Er-Chiacchiera/Soccer-2018-19/Meccanica/Adafruit BNO055/Renderings/Render.png

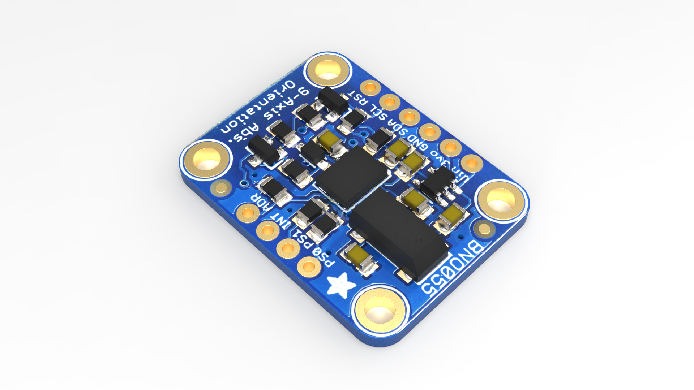
Meccanica/Adafruit BNO055/Renderings/Render.png
