Er-Chiacchiera/Soccer-2018-19/Meccanica/Adafruit BNO055/bottom.jpg

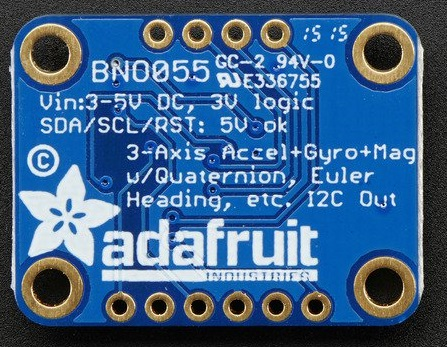
Meccanica/Adafruit BNO055/bottom.jpg
