Er-Chiacchiera/Soccer-2018-19/README.md

# Soccer-2018-19
Soccer Robot of Pacinotti-Archimede 2018/2019
