Er-Chiacchiera/Soccer-2018-19/Elettronica/Immagini/bmp/nero prova.bmp

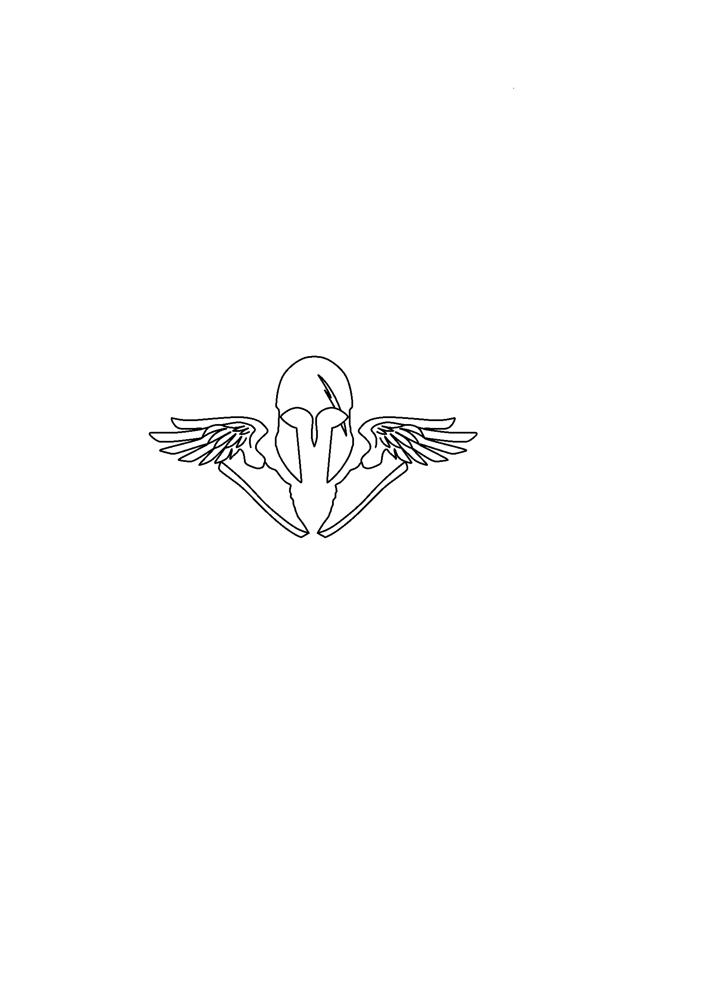
Elettronica/Immagini/bmp/nero prova.bmp
