Er-Chiacchiera/Soccer-2018-19/Meccanica/Adafruit BNO055/Renderings/Render2.png

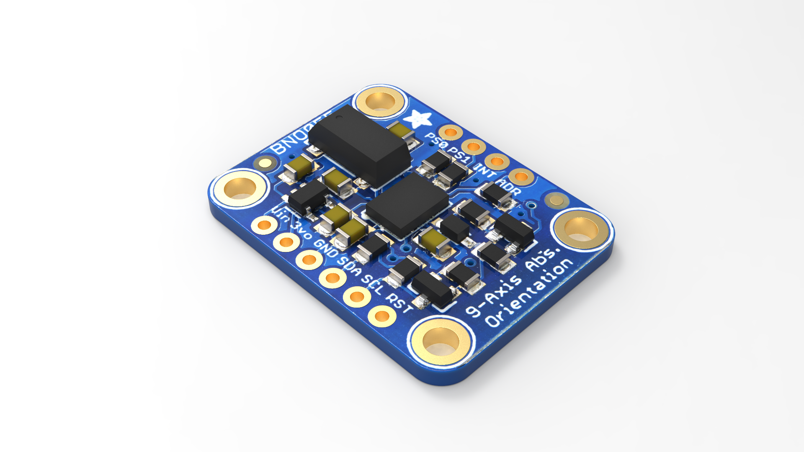
Meccanica/Adafruit BNO055/Renderings/Render2.png
