Er-Chiacchiera/Soccer-2018-19/Meccanica/Adafruit BNO055/top.jpg

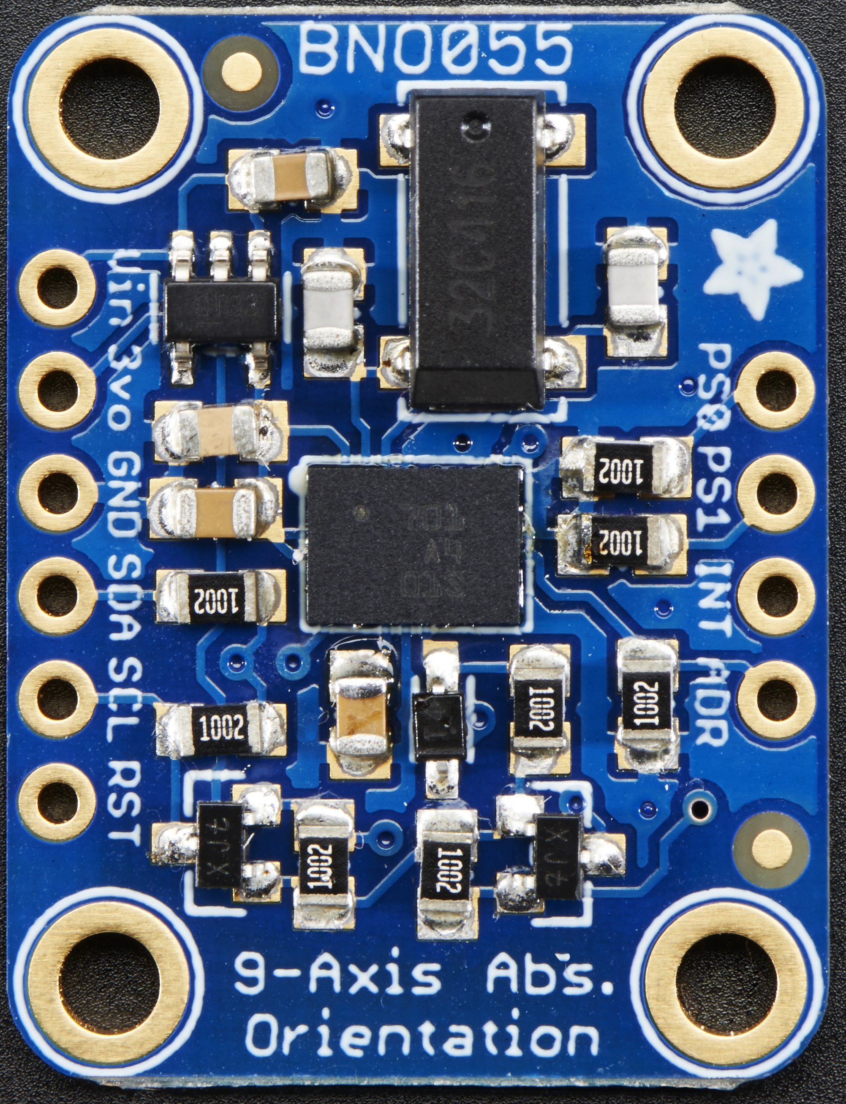
Meccanica/Adafruit BNO055/top.jpg
