Er-Chiacchiera/Soccer-2018-19/Elettronica/DXF/sensori_linea.dxf

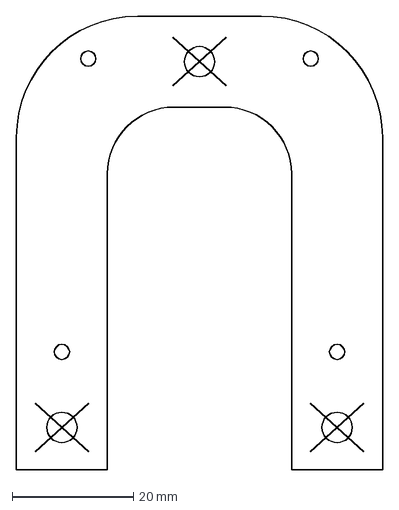
[picture p6: CAD file, 2019-03-06]
Elettronica/DXF/sensori_linea.dxf
60.3 x 74.8 mm
