Er-Chiacchiera/Soccer-2018-19/Elettronica/Vecchie/soccer-2015-pcb/Sensore Linea Rev 1/Sensore Linea Rev 1/sensore_linea.dxf

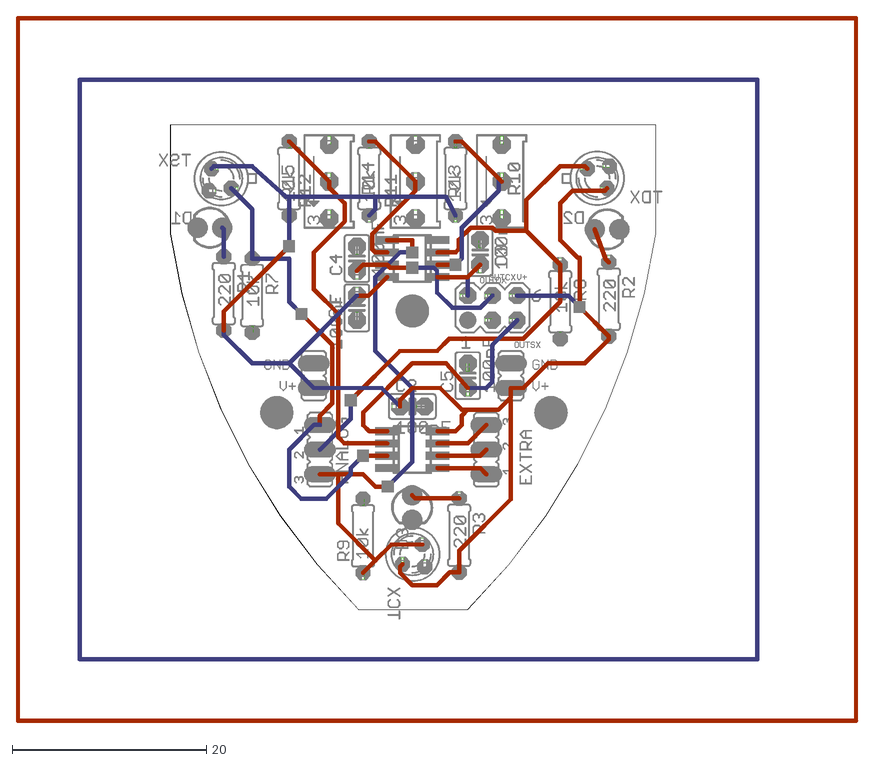
[picture p7: CAD file, 2019-03-06]
Elettronica/Vecchie/soccer-2015-pcb/Sensore Linea Rev 1/Sensore Linea Rev 1/sensore_linea.dxf
86.8 x 72.8
