Er-Chiacchiera/Soccer-2018-19/Meccanica/Adafruit BNO055/Adafruit_BNO055.SLDPRT

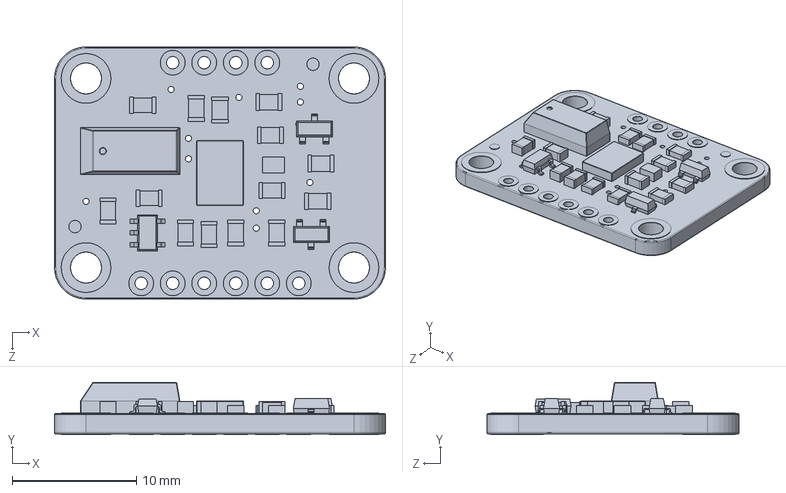
[picture p8: CAD file, 2019-03-06]
Meccanica/Adafruit BNO055/Adafruit_BNO055.SLDPRT
26.7 x 4.20 x 20.3 mm
