Er-Chiacchiera/Soccer-2018-19/Meccanica/Base_Sotto.dxf

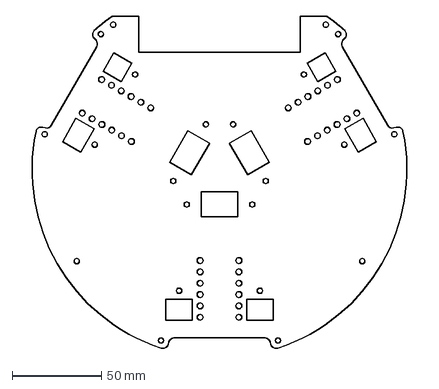
[picture p9: CAD file, 2019-03-11]
Meccanica/Base_Sotto.dxf
227.6 x 186.1 mm
