Er-Chiacchiera/Soccer-2018-19/Elettronica/DXF/PCB .dxf

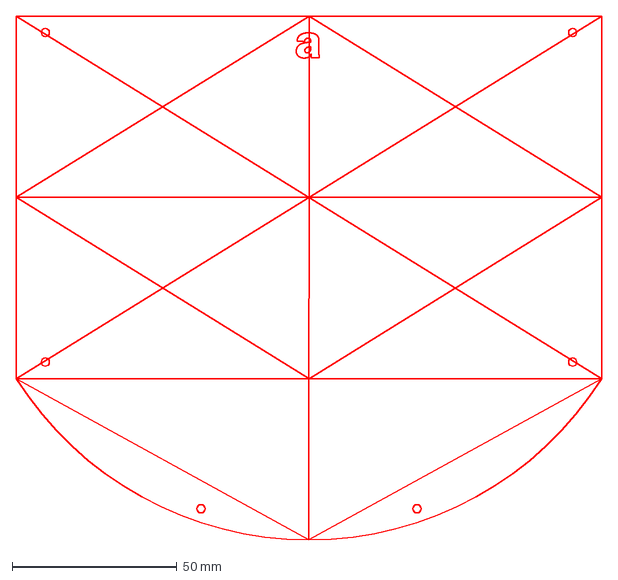
[picture p10: CAD file, 2019-03-06]
Elettronica/DXF/PCB .dxf
177.6 x 159.0 mm
