Er-Chiacchiera/Soccer-2018-19/Meccanica/Base_Sopra.dxf

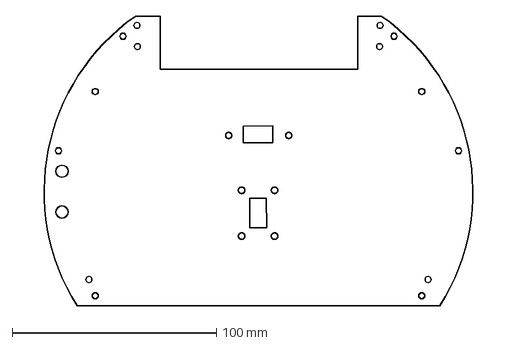
[picture p11: CAD file, 2019-03-11]
Meccanica/Base_Sopra.dxf
237.4 x 142.0 mm
