Er-Chiacchiera/Soccer-2018-19/Elettronica/Vecchie/soccer-2015-pcb/Sotto/cappucci anteriori.stl

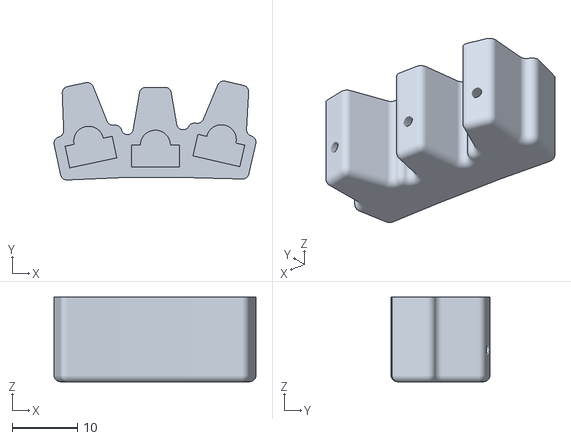
[picture p12: CAD file, 2019-03-06]
Elettronica/Vecchie/soccer-2015-pcb/Sotto/cappucci anteriori.stl
31.1 x 15.2 x 13.0
