Er-Chiacchiera/Soccer-2018-19/Meccanica/Rullo_Conico.stl

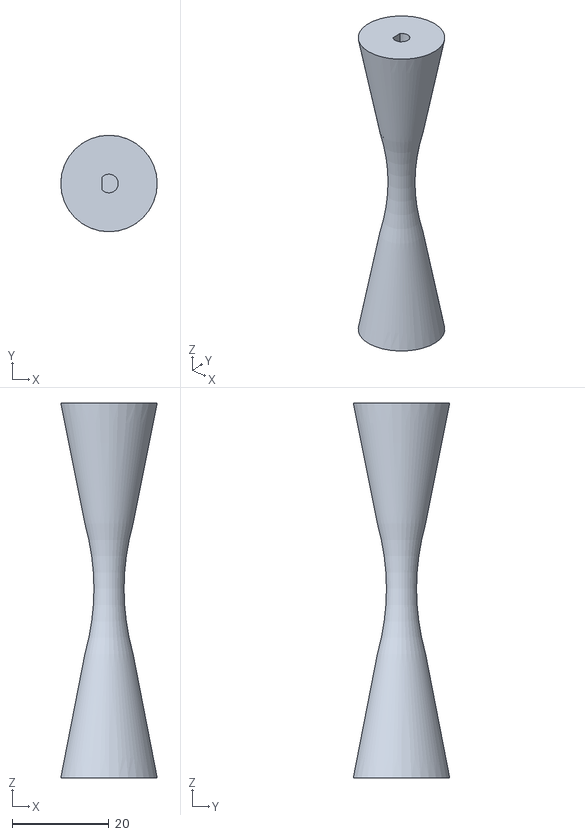
[picture p13: CAD file, 2019-03-06]
Meccanica/Rullo_Conico.stl
20.0 x 20.0 x 77.7
