Er-Chiacchiera/Soccer-2018-19/Meccanica/Rullo_Cilindrico.stl

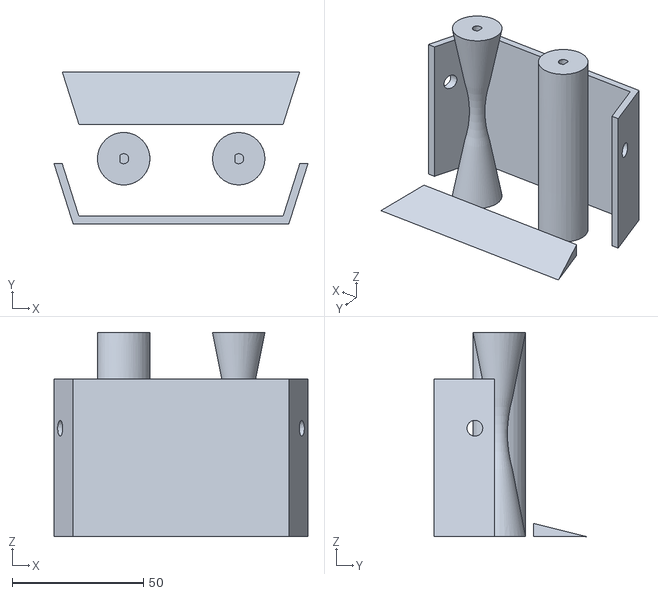
[picture p14: CAD file, 2019-03-06]
Meccanica/Rullo_Cilindrico.stl
96.7 x 57.9 x 77.7
