Er-Chiacchiera/Soccer-2018-19/Meccanica/Rampa_pt3.stl

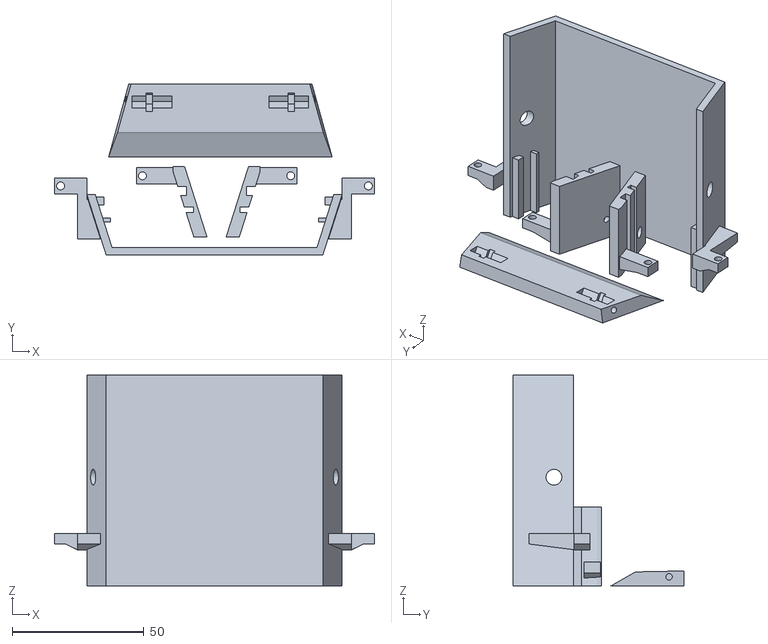
[picture p15: CAD file, 2019-03-06]
Meccanica/Rampa_pt3.stl
121.3 x 65.0 x 80.0
