Er-Chiacchiera/Soccer-2018-19/Meccanica/Rampa_pt2.stl

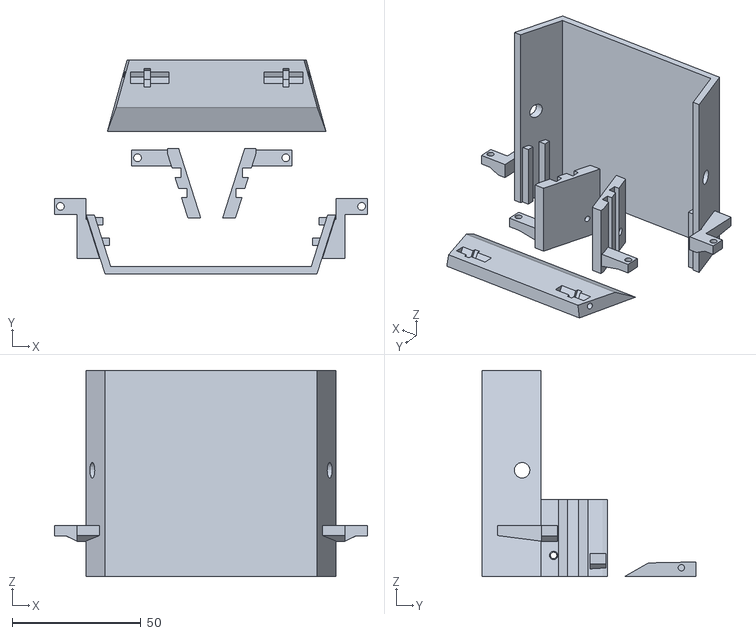
[picture p16: CAD file, 2019-03-06]
Meccanica/Rampa_pt2.stl
121.3 x 83.1 x 80.0
