Er-Chiacchiera/Soccer-2018-19/Meccanica/Rampa_pt1.stl

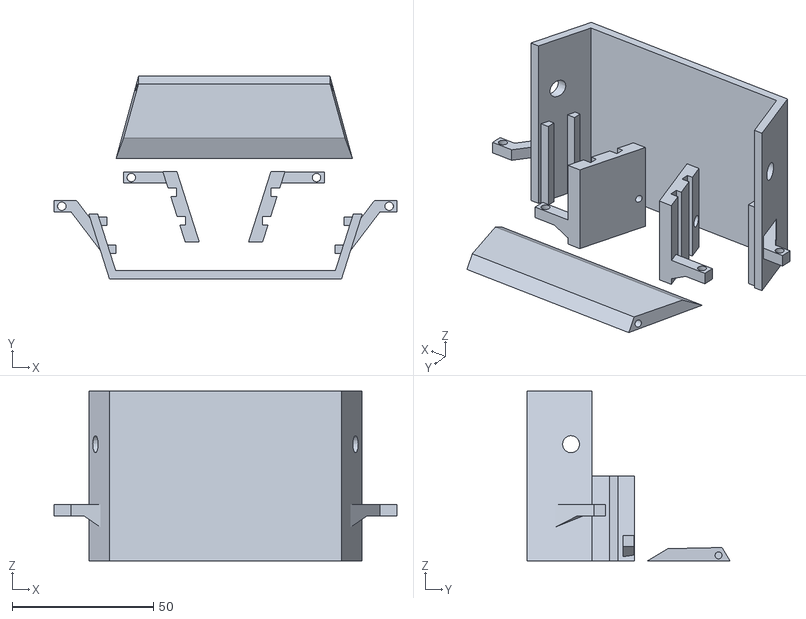
[picture p17: CAD file, 2019-03-06]
Meccanica/Rampa_pt1.stl
121.4 x 71.9 x 60.0
