Er-Chiacchiera/Soccer-2018-19/Meccanica/PCB .dxf

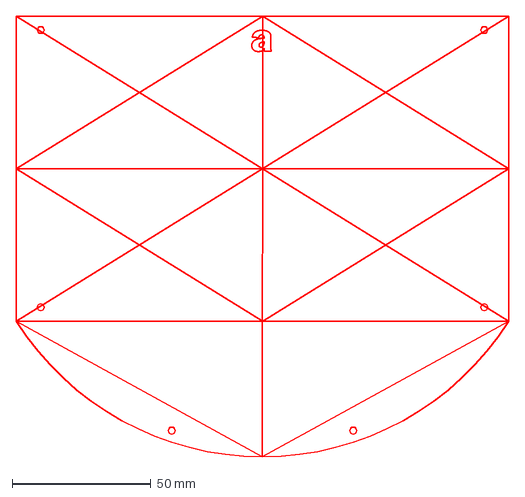
[picture p18: CAD file, 2019-03-06]
Meccanica/PCB .dxf
177.6 x 159.0 mm
