Er-Chiacchiera/Soccer-2018-19/Meccanica/Stampa_Ruote_prova.stl

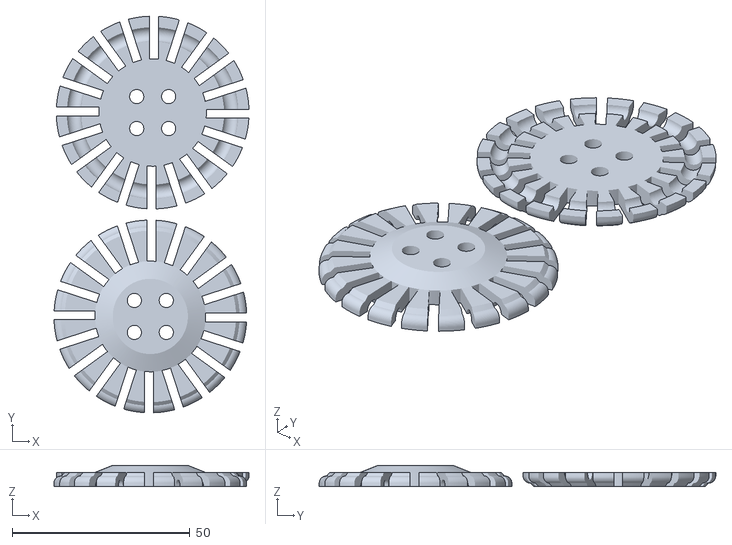
[picture p19: CAD file, 2019-03-06]
Meccanica/Stampa_Ruote_prova.stl
54.8 x 111.5 x 6.00
