Er-Chiacchiera/Soccer-2018-19/(list of files, cad)

Other CAD files:
Elettronica/Vecchie/soccer-2015-pcb/Sotto/Calciatore Rev.2 DOWN.dwg
Elettronica/Vecchie/soccer-2015-pcb/Sotto/cappuccio.dwg
Meccanica/Adafruit BNO055/Adafruit_BNO055_AP203.STEP
Meccanica/Adafruit BNO055/Adafruit_BNO055_AP214.STEP
Elettronica/Vecchie/soccer-2015-pcb/Sotto/cappucci anteriori.dwg
Meccanica/Rampa_pt1.3dm
Meccanica/Rampa_pt2.3dm
Meccanica/Rampa_pt3 .3dm
Meccanica/bussola.3dm
Meccanica/logo soccer.3dm
