Er-Chiacchiera/Soccer-2018-19/Elettronica/PCB/PCB.brd

## EAGLE design Elettronica/PCB/PCB.brd (2020-01-30)

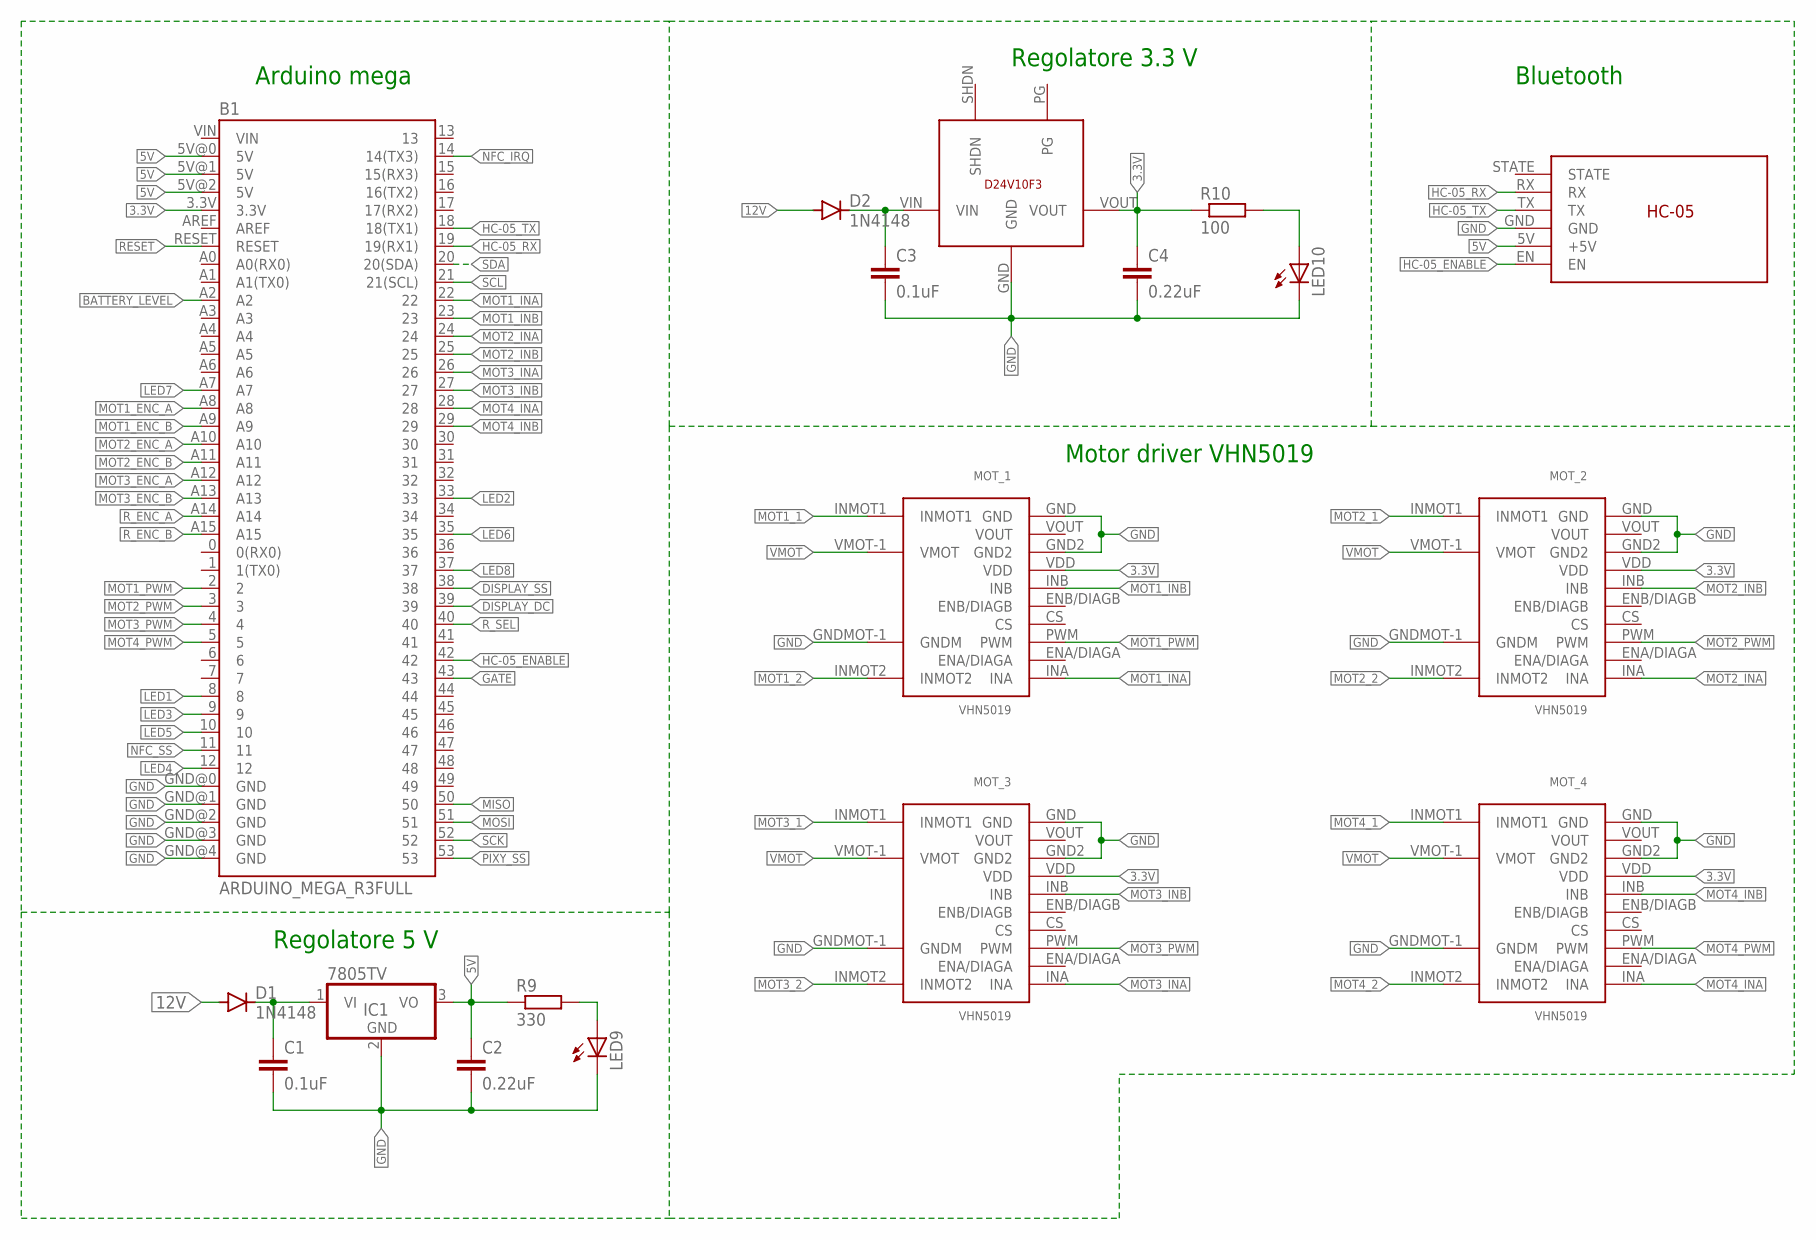
[picture p20: schematic PCB.sch, sheet 1]

Parts:
B1: ARDUINO_MEGA_R3FULL; ARDUINO_MEGA
C1, C3: 0.1uF; CAP-PTH-SMALL-KIT
C2, C4: 0.22uF; CAP-PTH-SMALL-KIT
D1, D2: 1N4148; DO41-10
IC1: 7805TV; TO220V
LED9, LED10: LED1206; LED-1206
MOT_1, MOT_2, MOT_3, MOT_4: VHN5019; MOTOR-SHIELD
R9: 330; R1206
R10: 100; R1206
U$1: STEPDOWN_D24V10F3
U$9: HC-05

Connections:
3.3V: B1.3.3V, C4.1, MOT_1.VDD, MOT_2.VDD, MOT_3.VDD, MOT_4.VDD, R10.1, U$1.VOUT; also elsewhere on the board
5V: B1.5V@0 (5V), B1.5V@1 (5V), B1.5V@2 (5V), C2.1, IC1.3 (VO), R9.1, U$9.5V (+5V); also elsewhere on the board
12V: D1.A, D2.A; also elsewhere on the board
BATTERY_LEVEL: B1.A2; also elsewhere on the board
DISPLAY_DC: B1.39; also elsewhere on the board
DISPLAY_SS: B1.38; also elsewhere on the board
GATE: B1.43; also elsewhere on the board
GND: B1.GND@0 (GND), B1.GND@1 (GND), B1.GND@2 (GND), B1.GND@3 (GND), B1.GND@4 (GND), C1.2, C2.2, C3.2, C4.2, IC1.2 (GND), LED9.C, LED10.C, MOT_1.GND, MOT_1.GND2, MOT_1.GNDMOT-1 (GNDM), MOT_2.GND, MOT_2.GND2, MOT_2.GNDMOT-1 (GNDM), MOT_3.GND, MOT_3.GND2, MOT_3.GNDMOT-1 (GNDM), MOT_4.GND, MOT_4.GND2, MOT_4.GNDMOT-1 (GNDM), U$1.GND, U$9.GND; also elsewhere on the board
HC-05_ENABLE: B1.42, U$9.EN
HC-05_RX: B1.19 (19(RX1)), U$9.RX
HC-05_TX: B1.18 (18(TX1)), U$9.TX
LED1: B1.8; also elsewhere on the board
LED2: B1.33; also elsewhere on the board
LED3: B1.9; also elsewhere on the board
LED4: B1.12; also elsewhere on the board
LED5: B1.10; also elsewhere on the board
LED6: B1.35; also elsewhere on the board
LED7: B1.A7; also elsewhere on the board
LED8: B1.37; also elsewhere on the board
MISO: B1.50; also elsewhere on the board
MOSI: B1.51; also elsewhere on the board
MOT1_1: MOT_1.INMOT1; also elsewhere on the board
MOT1_2: MOT_1.INMOT2; also elsewhere on the board
MOT1_ENC_A: B1.A8; also elsewhere on the board
MOT1_ENC_B: B1.A9; also elsewhere on the board
MOT1_INA: B1.22, MOT_1.INA
MOT1_INB: B1.23, MOT_1.INB
MOT1_PWM: B1.2, MOT_1.PWM
MOT2_1: MOT_2.INMOT1; also elsewhere on the board
MOT2_2: MOT_2.INMOT2; also elsewhere on the board
MOT2_ENC_A: B1.A10; also elsewhere on the board
MOT2_ENC_B: B1.A11; also elsewhere on the board
MOT2_INA: B1.24, MOT_2.INA
MOT2_INB: B1.25, MOT_2.INB
MOT2_PWM: B1.3, MOT_2.PWM
MOT3_1: MOT_3.INMOT1; also elsewhere on the board
MOT3_2: MOT_3.INMOT2; also elsewhere on the board
MOT3_ENC_A: B1.A12; also elsewhere on the board
MOT3_ENC_B: B1.A13; also elsewhere on the board
MOT3_INA: B1.26, MOT_3.INA
MOT3_INB: B1.27, MOT_3.INB
MOT3_PWM: B1.4, MOT_3.PWM
MOT4_1: MOT_4.INMOT1
MOT4_2: MOT_4.INMOT2
MOT4_INA: B1.28, MOT_4.INA
MOT4_INB: B1.29, MOT_4.INB
MOT4_PWM: B1.5, MOT_4.PWM
unnamed: LED9.A, R9.2
unnamed: C3.1, D2.C, U$1.VIN
unnamed: LED10.A, R10.2
unnamed: C1.1, D1.C, IC1.1 (VI)
NFC_IRQ: B1.14 (14(TX3)); also elsewhere on the board
NFC_SS: B1.11; also elsewhere on the board
PIXY_SS: B1.53; also elsewhere on the board
RESET: B1.RESET; also elsewhere on the board
R_ENC_A: B1.A14; also elsewhere on the board
R_ENC_B: B1.A15; also elsewhere on the board
R_SEL: B1.40; also elsewhere on the board
SCK: B1.52; also elsewhere on the board
SCL: B1.21 (21(SCL)); also elsewhere on the board
SDA: B1.20 (20(SDA)); also elsewhere on the board
VMOT: MOT_1.VMOT-1 (VMOT), MOT_2.VMOT-1 (VMOT), MOT_3.VMOT-1 (VMOT), MOT_4.VMOT-1 (VMOT); also elsewhere on the board

Notes on the sheet:
Arduino mega
Regolatore 5 V
Motor driver VHN5019
Bluetooth
Regolatore 3.3 V

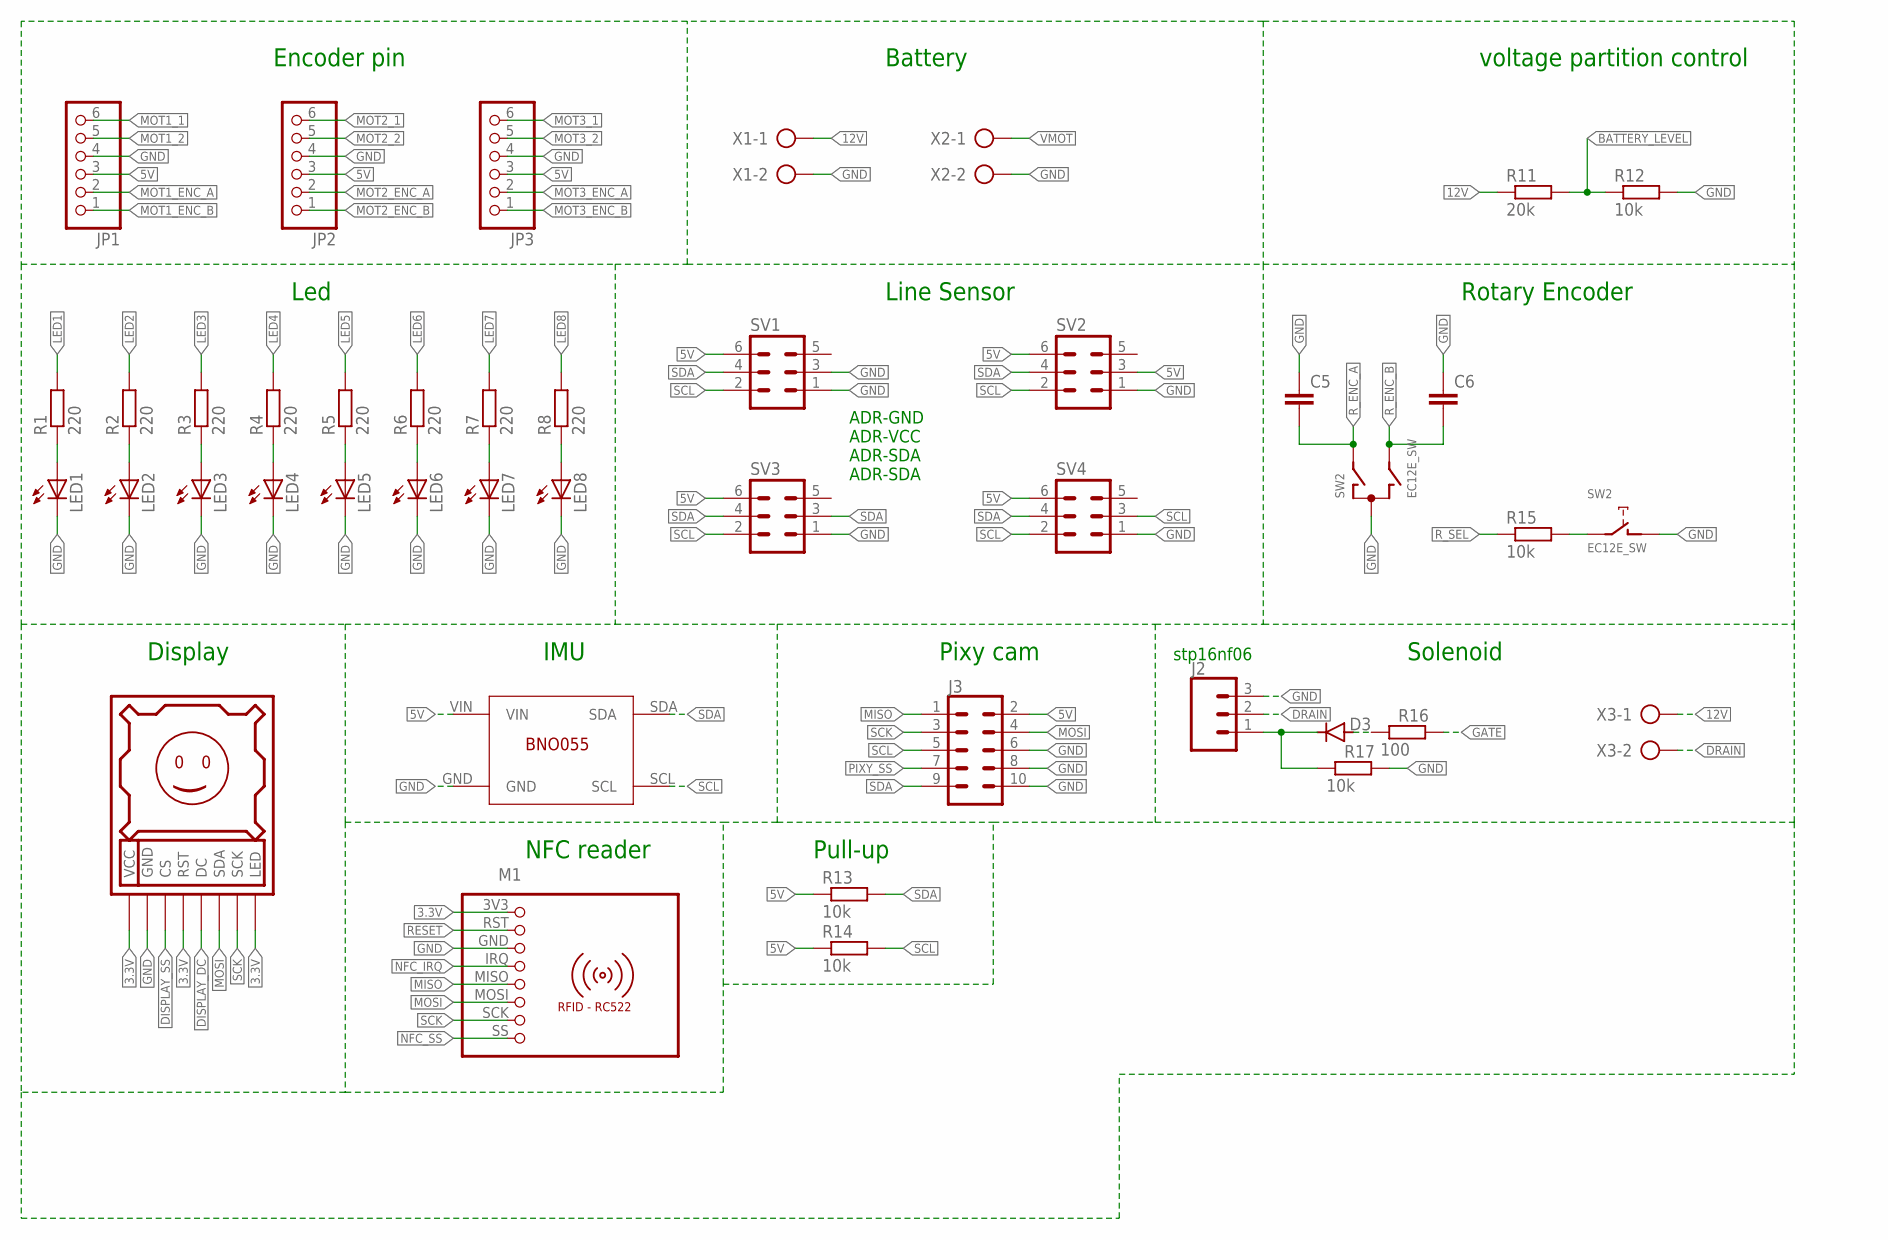
[picture p21: schematic PCB.sch, sheet 2]

Parts:
C5, C6: C-EUC1206; C1206
D3: 1N4148; DO35-7
DISPLAY1: DISPLAY128X128
J2: 455-1750-1-ND; 1X03
J3: CONN_05X2PTH; 2X5
JP1, JP2, JP3: PINHD-1X6; 1X06
LED1, LED2, LED3, LED4, LED5, LED6, LED7, LED8: LED1206; LED-1206
M1: RFID-RC522
R1, R2, R3, R4, R5, R6, R7, R8: 220; R1206
R11: 20k; 0204/7
R12: 10k; 0204/7
R13, R14, R15, R17: 10k; R1206
R16: 100; R1206
SV1, SV2, SV3, SV4: MA03-2
SW2: EC12E_SW; ALPS_EC12E_SW
U$8: BNO055; BNO005
X1, X2, X3: AK500/2-H

Connections:
3.3V: DISPLAY1.LED, DISPLAY1.RST, DISPLAY1.VCC, M1.3V3 (1); also elsewhere on the board
5V: J3.2, JP1.3, JP2.3, JP3.3, R13.1, R14.1, SV1.6, SV2.3, SV2.6, SV3.6, SV4.6, U$8.VIN; also elsewhere on the board
12V: R11.1, X1.1, X3.1; also elsewhere on the board
BATTERY_LEVEL: R11.2, R12.1; also elsewhere on the board
DISPLAY_DC: DISPLAY1.DC; also elsewhere on the board
DISPLAY_SS: DISPLAY1.CS; also elsewhere on the board
DRAIN: J2.2, X3.2
GATE: R16.2; also elsewhere on the board
GND: C5.1, C6.1, DISPLAY1.GND, J2.3, J3.6, J3.8, J3.10, JP1.4, JP2.4, JP3.4, LED1.C, LED2.C, LED3.C, LED4.C, LED5.C, LED6.C, LED7.C, LED8.C, M1.GND (3), R12.2, R17.2, SV1.1, SV1.3, SV2.1, SV3.1, SV4.1, SW2.C, SW2.D (1), U$8.GND, X1.2, X2.2; also elsewhere on the board
LED1: R1.2; also elsewhere on the board
LED2: R2.2; also elsewhere on the board
LED3: R3.2; also elsewhere on the board
LED4: R4.2; also elsewhere on the board
LED5: R5.2; also elsewhere on the board
LED6: R6.2; also elsewhere on the board
LED7: R7.2; also elsewhere on the board
LED8: R8.2; also elsewhere on the board
MISO: J3.1, M1.MISO (5); also elsewhere on the board
MOSI: DISPLAY1.SDA, J3.4, M1.MOSI (6); also elsewhere on the board
MOT1_1: JP1.6; also elsewhere on the board
MOT1_2: JP1.5; also elsewhere on the board
MOT1_ENC_A: JP1.2; also elsewhere on the board
MOT1_ENC_B: JP1.1; also elsewhere on the board
MOT2_1: JP2.6; also elsewhere on the board
MOT2_2: JP2.5; also elsewhere on the board
MOT2_ENC_A: JP2.2; also elsewhere on the board
MOT2_ENC_B: JP2.1; also elsewhere on the board
MOT3_1: JP3.6; also elsewhere on the board
MOT3_2: JP3.5; also elsewhere on the board
MOT3_ENC_A: JP3.2; also elsewhere on the board
MOT3_ENC_B: JP3.1; also elsewhere on the board
unnamed: D3.C, J2.1, R17.1
unnamed: D3.A, R16.1
unnamed: LED1.A, R1.1
unnamed: LED2.A, R2.1
unnamed: LED3.A, R3.1
unnamed: LED4.A, R4.1
unnamed: LED5.A, R5.1
unnamed: LED6.A, R6.1
unnamed: LED7.A, R7.1
unnamed: LED8.A, R8.1
unnamed: R15.2, SW2.E (2)
NFC_IRQ: M1.IRQ (4); also elsewhere on the board
NFC_SS: M1.SS (8); also elsewhere on the board
PIXY_SS: J3.7; also elsewhere on the board
RESET: M1.RST (2); also elsewhere on the board
R_ENC_A: C5.2, SW2.A; also elsewhere on the board
R_ENC_B: C6.2, SW2.B; also elsewhere on the board
R_SEL: R15.1; also elsewhere on the board
SCK: DISPLAY1.SCK, J3.3, M1.SCK (7); also elsewhere on the board
SCL: J3.5, R14.2, SV1.2, SV2.2, SV3.2, SV4.2, SV4.3, U$8.SCL; also elsewhere on the board
SDA: J3.9, R13.2, SV1.4, SV2.4, SV3.3, SV3.4, SV4.4, U$8.SDA; also elsewhere on the board
VMOT: X2.1; also elsewhere on the board

Notes on the sheet:
Encoder pin
Battery
Led
ADR-GND ADR-VCC ADR-SDA ADR-SDA
voltage partition control
Rotary Encoder
Line Sensor
Display
Solenoid
IMU
Pixy cam
NFC reader
stp16nf06
Pull-up

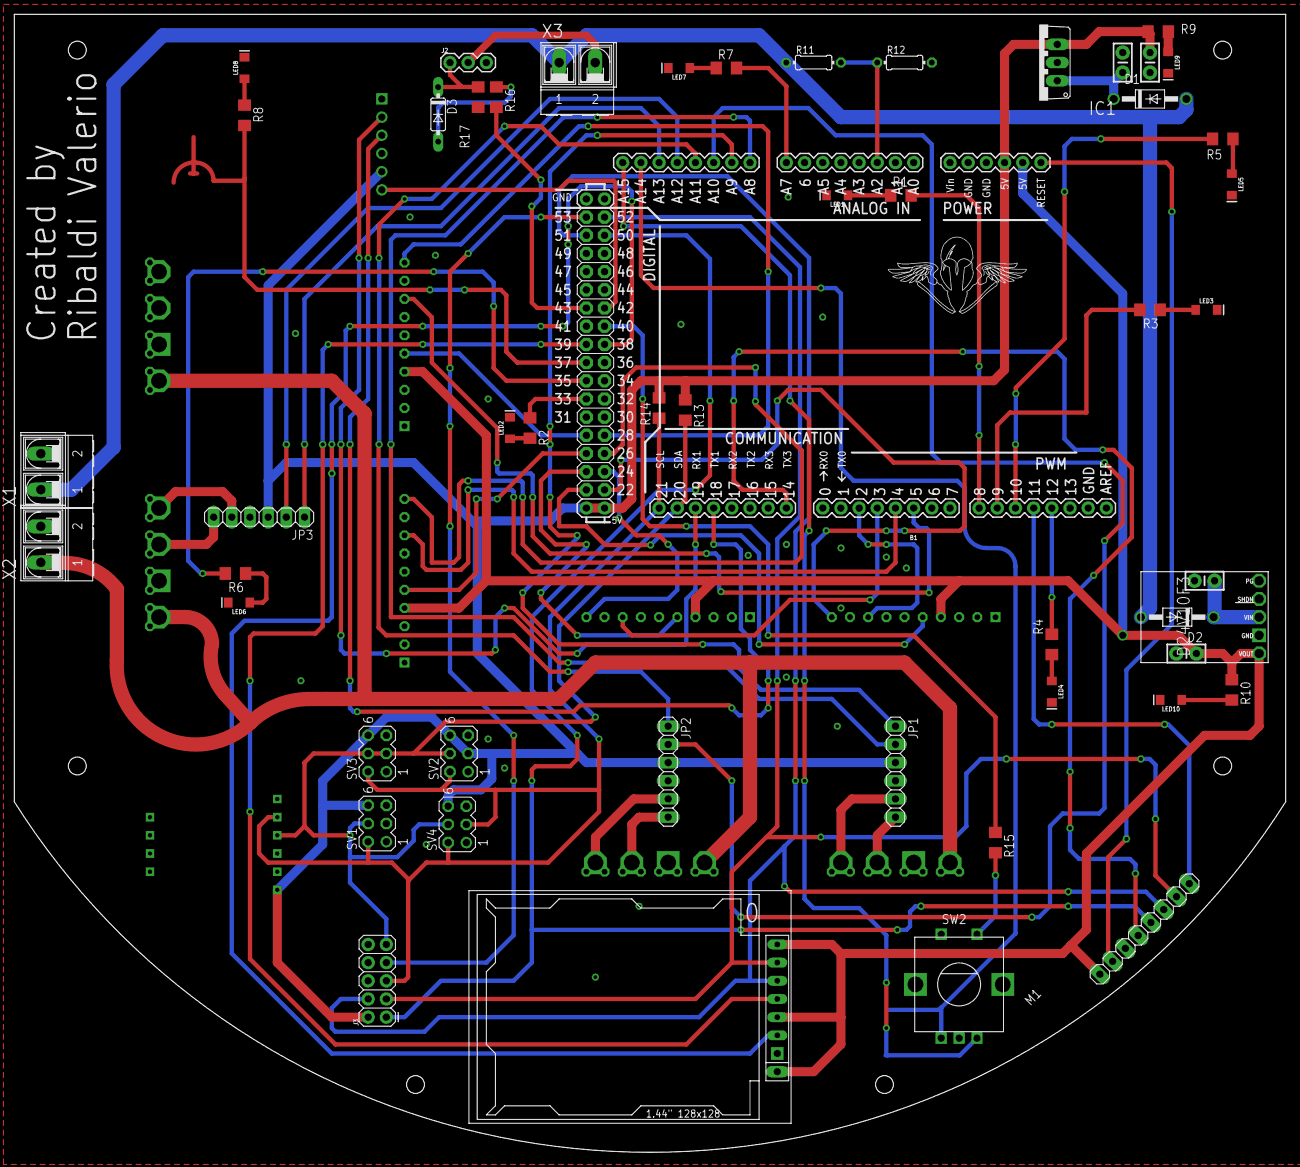
[picture p22: board PCB.brd from above]

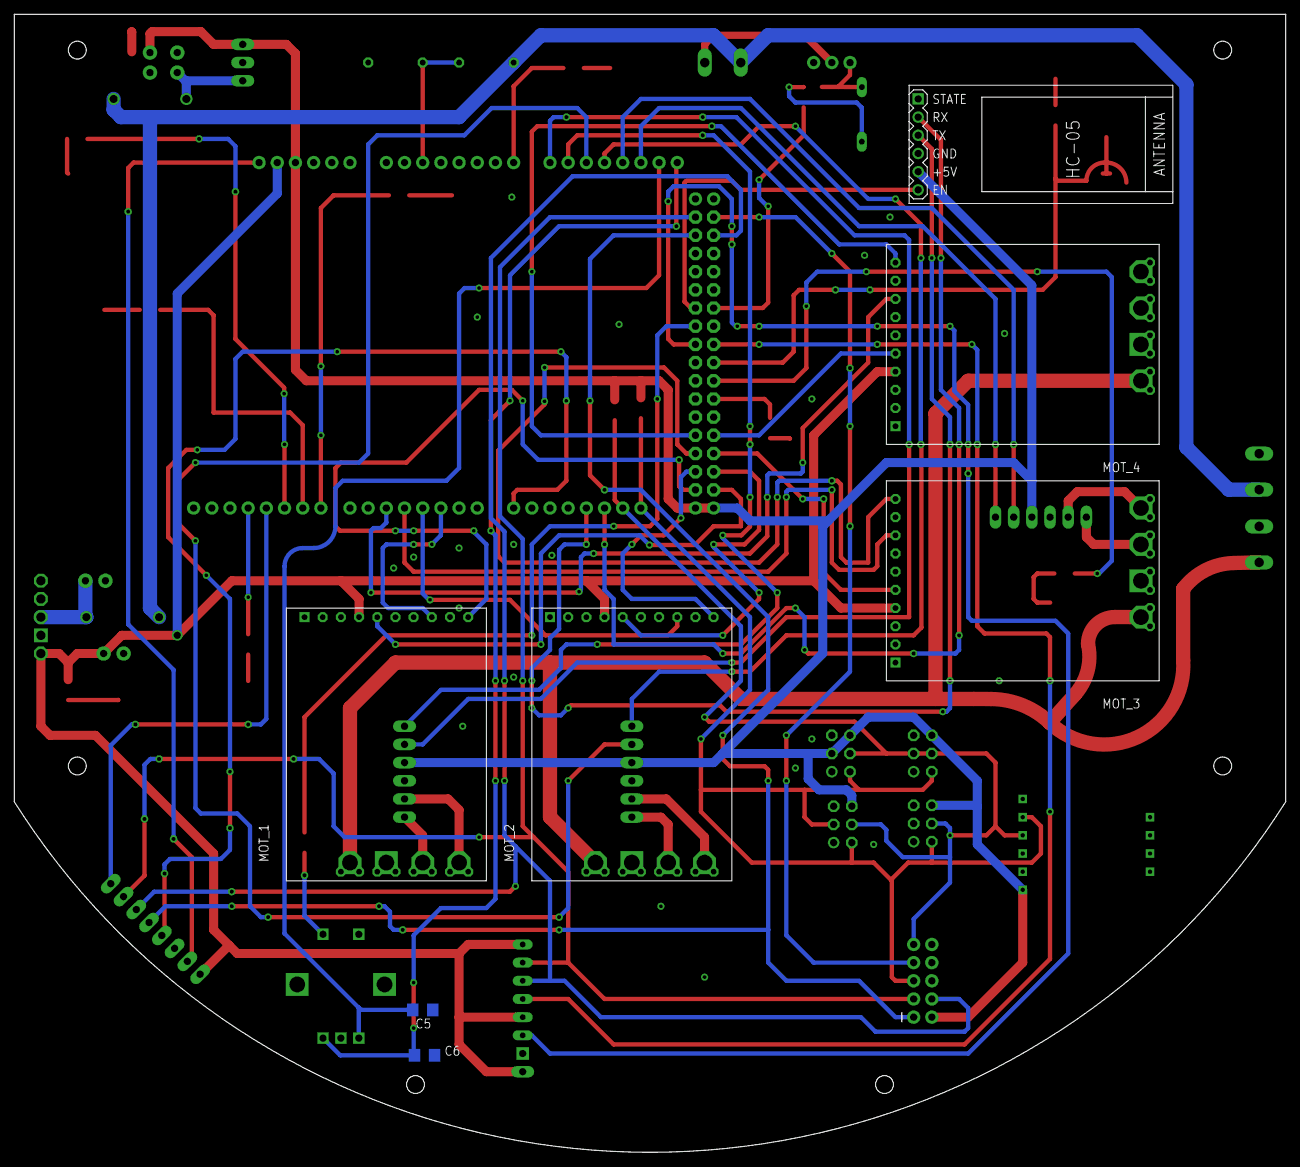
[picture p23: board PCB.brd from below]

Board: 2 copper layers, 177.6 x 159.0 mm, 60 parts (7 on the bottom side), 72 nets.
