Er-Chiacchiera/Soccer-2018-19/Elettronica/Vecchie/soccer-2015-pcb/Sensore Linea Rev 1/Sensore Linea Rev 1/sensore_linea.brd

## EAGLE design Elettronica/Vecchie/soccer-2015-pcb/Sensore Linea Rev 1/Sensore Linea Rev 1/sensore_linea.brd (2019-03-06)

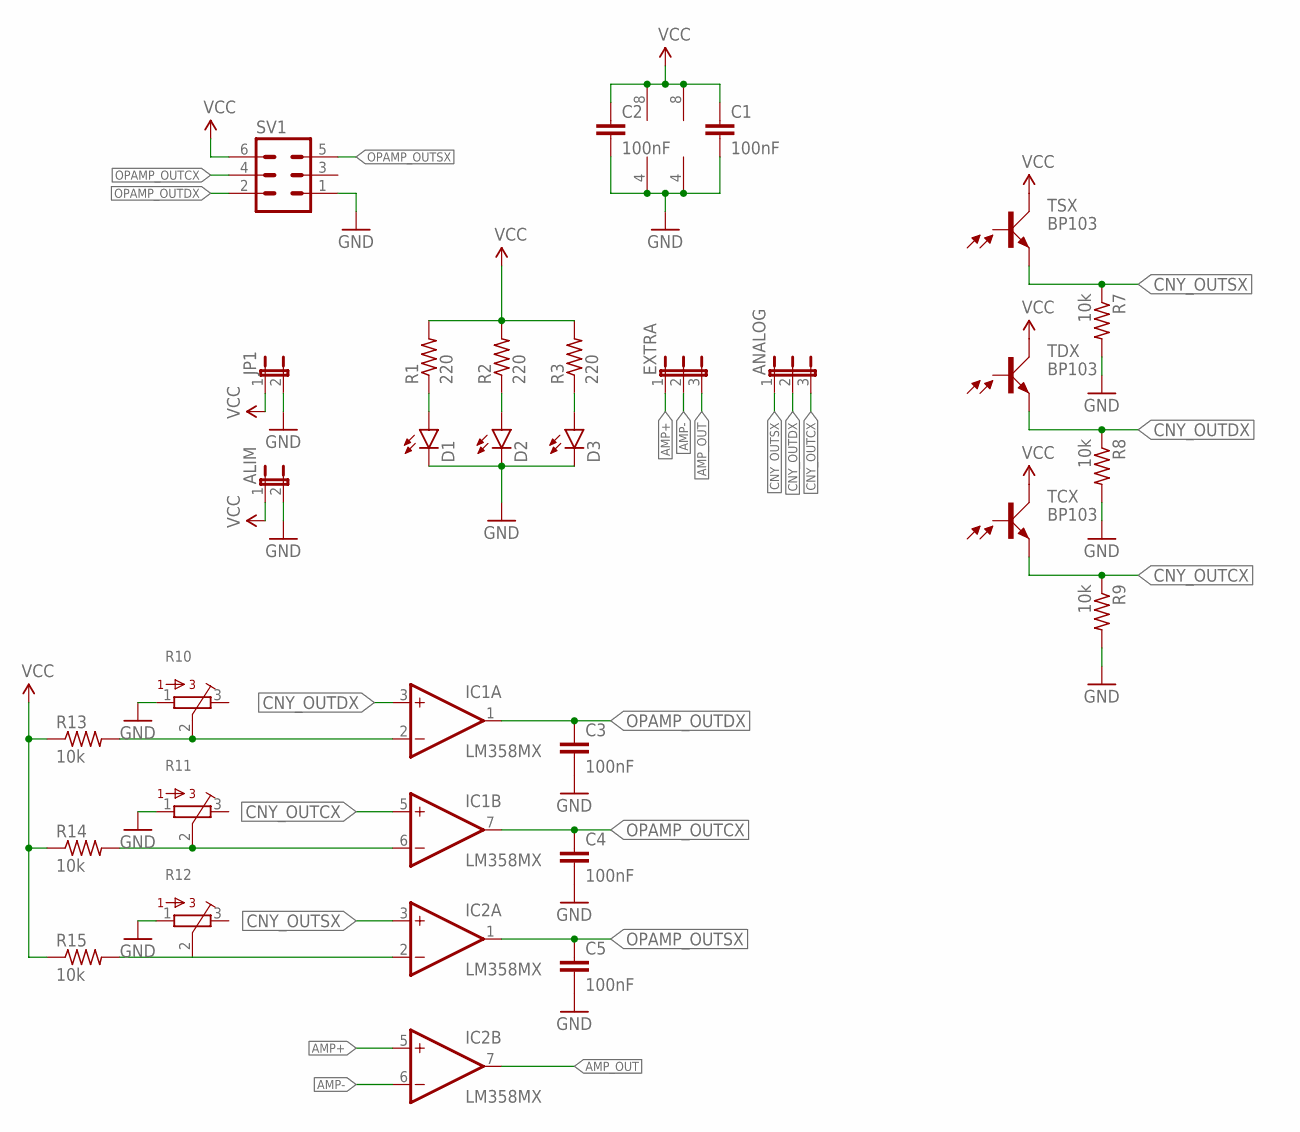
[picture p24: schematic sensore_linea.sch]

Parts:
ALIM: JP1E; JP1
ANALOG: JP2E; JP2
C1, C2, C3, C4, C5: 100nF; C2.5-2
D1, D2, D3: LED3MM
EXTRA: JP2E; JP2
IC1, IC2: LM358MX; SO08
JP1: JP1E; JP1
R1, R2, R3: 220; 0207/7
R7, R8, R9, R13, R14, R15: 10k; 0207/7
R10, R11, R12: 3386-J; 3386J
SV1: MA03-2
TCX: BP103
TDX: BP103
TSX: BP103

Connections:
AMP+: EXTRA.1, IC2.5 (+IN)
AMP-: EXTRA.2, IC2.6 (-IN)
AMP_OUT: EXTRA.3, IC2.7 (OUT)
CNY_OUTCX: ANALOG.3, IC1.5 (+IN), R9.1, TCX.E
CNY_OUTDX: ANALOG.2, IC1.3 (+IN), R8.1, TDX.E
CNY_OUTSX: ANALOG.1, IC2.3 (+IN), R7.1, TSX.E
GND: ALIM.2, C1.2, C2.2, C3.2, C4.2, C5.2, D1.K (C), D2.K (C), D3.K (C), IC1.4 (V-), IC2.4 (V-), JP1.2, R7.2, R8.2, R9.2, R10.1, R11.1, R12.1, SV1.1
unnamed: D1.A, R1.1
unnamed: D2.A, R2.1
unnamed: D3.A, R3.1
unnamed: IC1.2 (-IN), R10.2, R13.2
unnamed: IC1.6 (-IN), R11.2, R14.2
unnamed: IC2.2 (-IN), R12.2, R15.2
OPAMP_OUTCX: C4.1, IC1.7 (OUT), SV1.4
OPAMP_OUTDX: C3.1, IC1.1 (OUT), SV1.2
OPAMP_OUTSX: C5.1, IC2.1 (OUT), SV1.5
VCC: ALIM.1, C1.1, C2.1, IC1.8 (V+), IC2.8 (V+), JP1.1, R1.2, R2.2, R3.2, R13.1, R14.1, R15.1, SV1.6, TCX.C, TDX.C, TSX.C

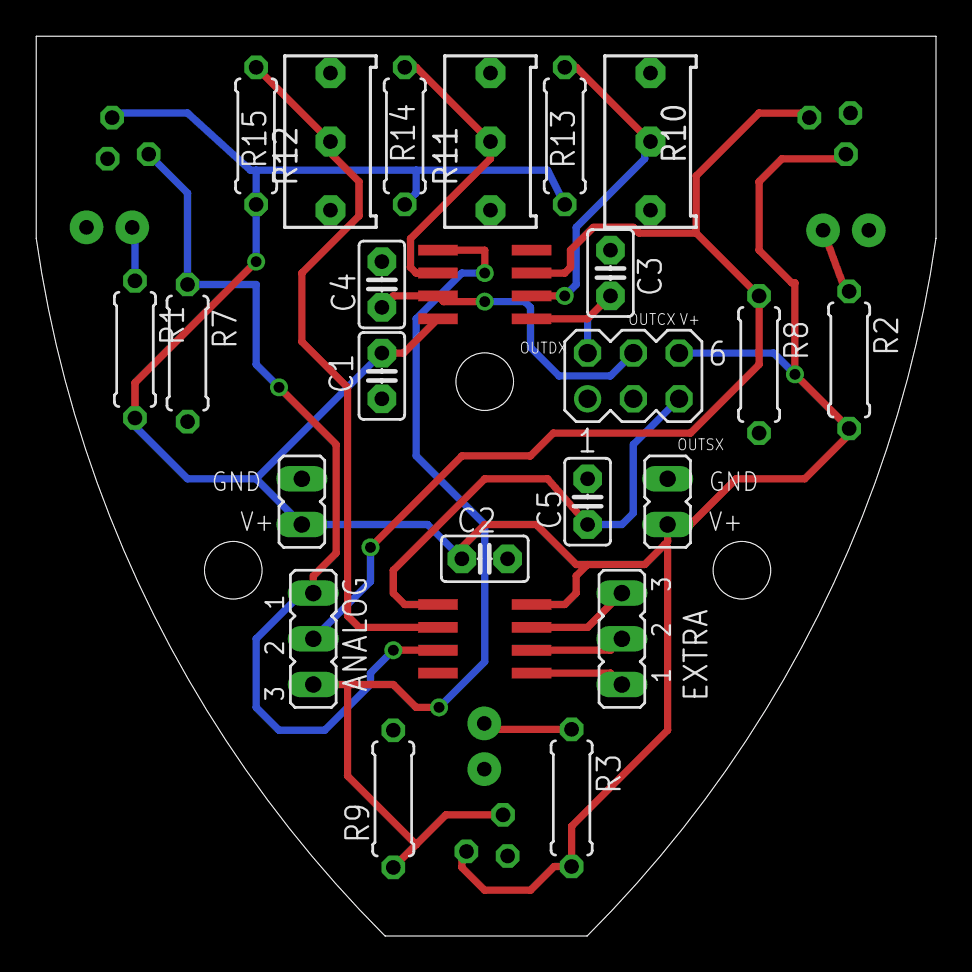
[picture p25: board sensore_linea.brd from above]

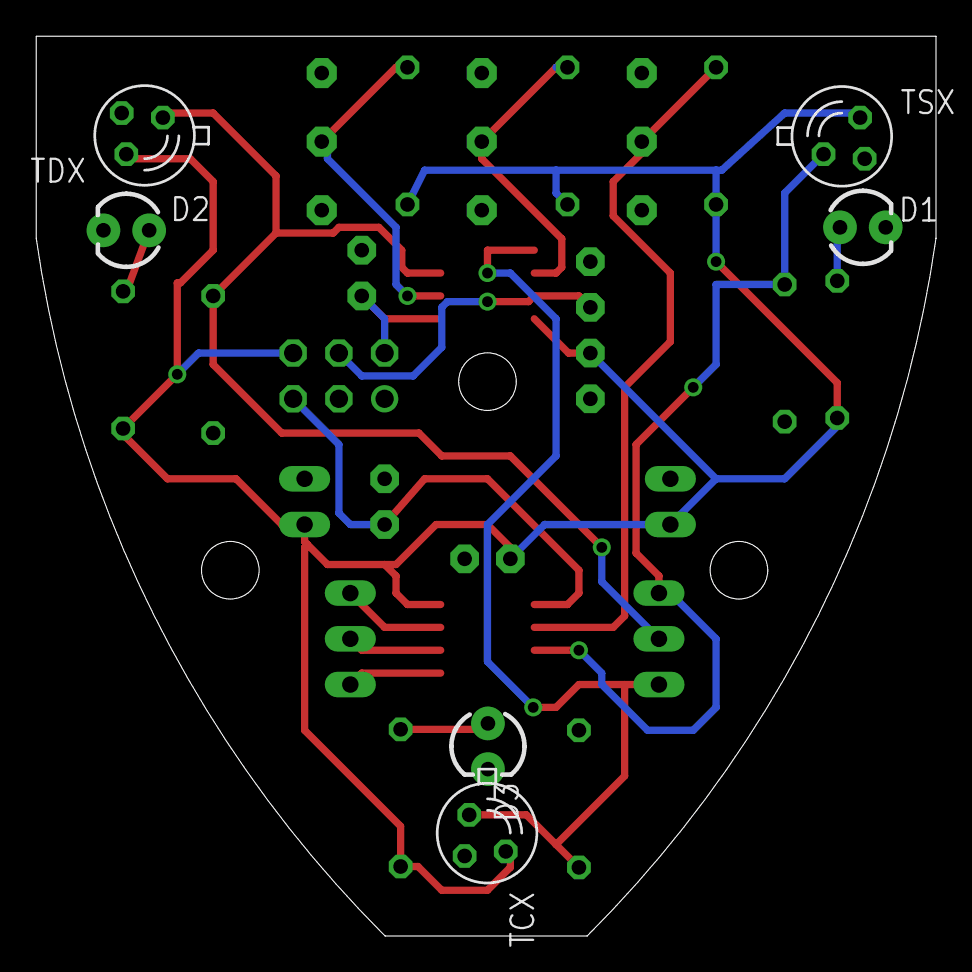
[picture p26: board sensore_linea.brd from below]

Board: 2 copper layers, 50.0 x 50.0 mm, 30 parts (6 on the bottom side), 17 nets.
