Er-Chiacchiera/Soccer-2018-19/Elettronica/Vecchie/Sensori_linea_1718/sensore-linea.brd

## EAGLE design Elettronica/Vecchie/Sensori_linea_1718/sensore-linea.brd (2019-03-06)

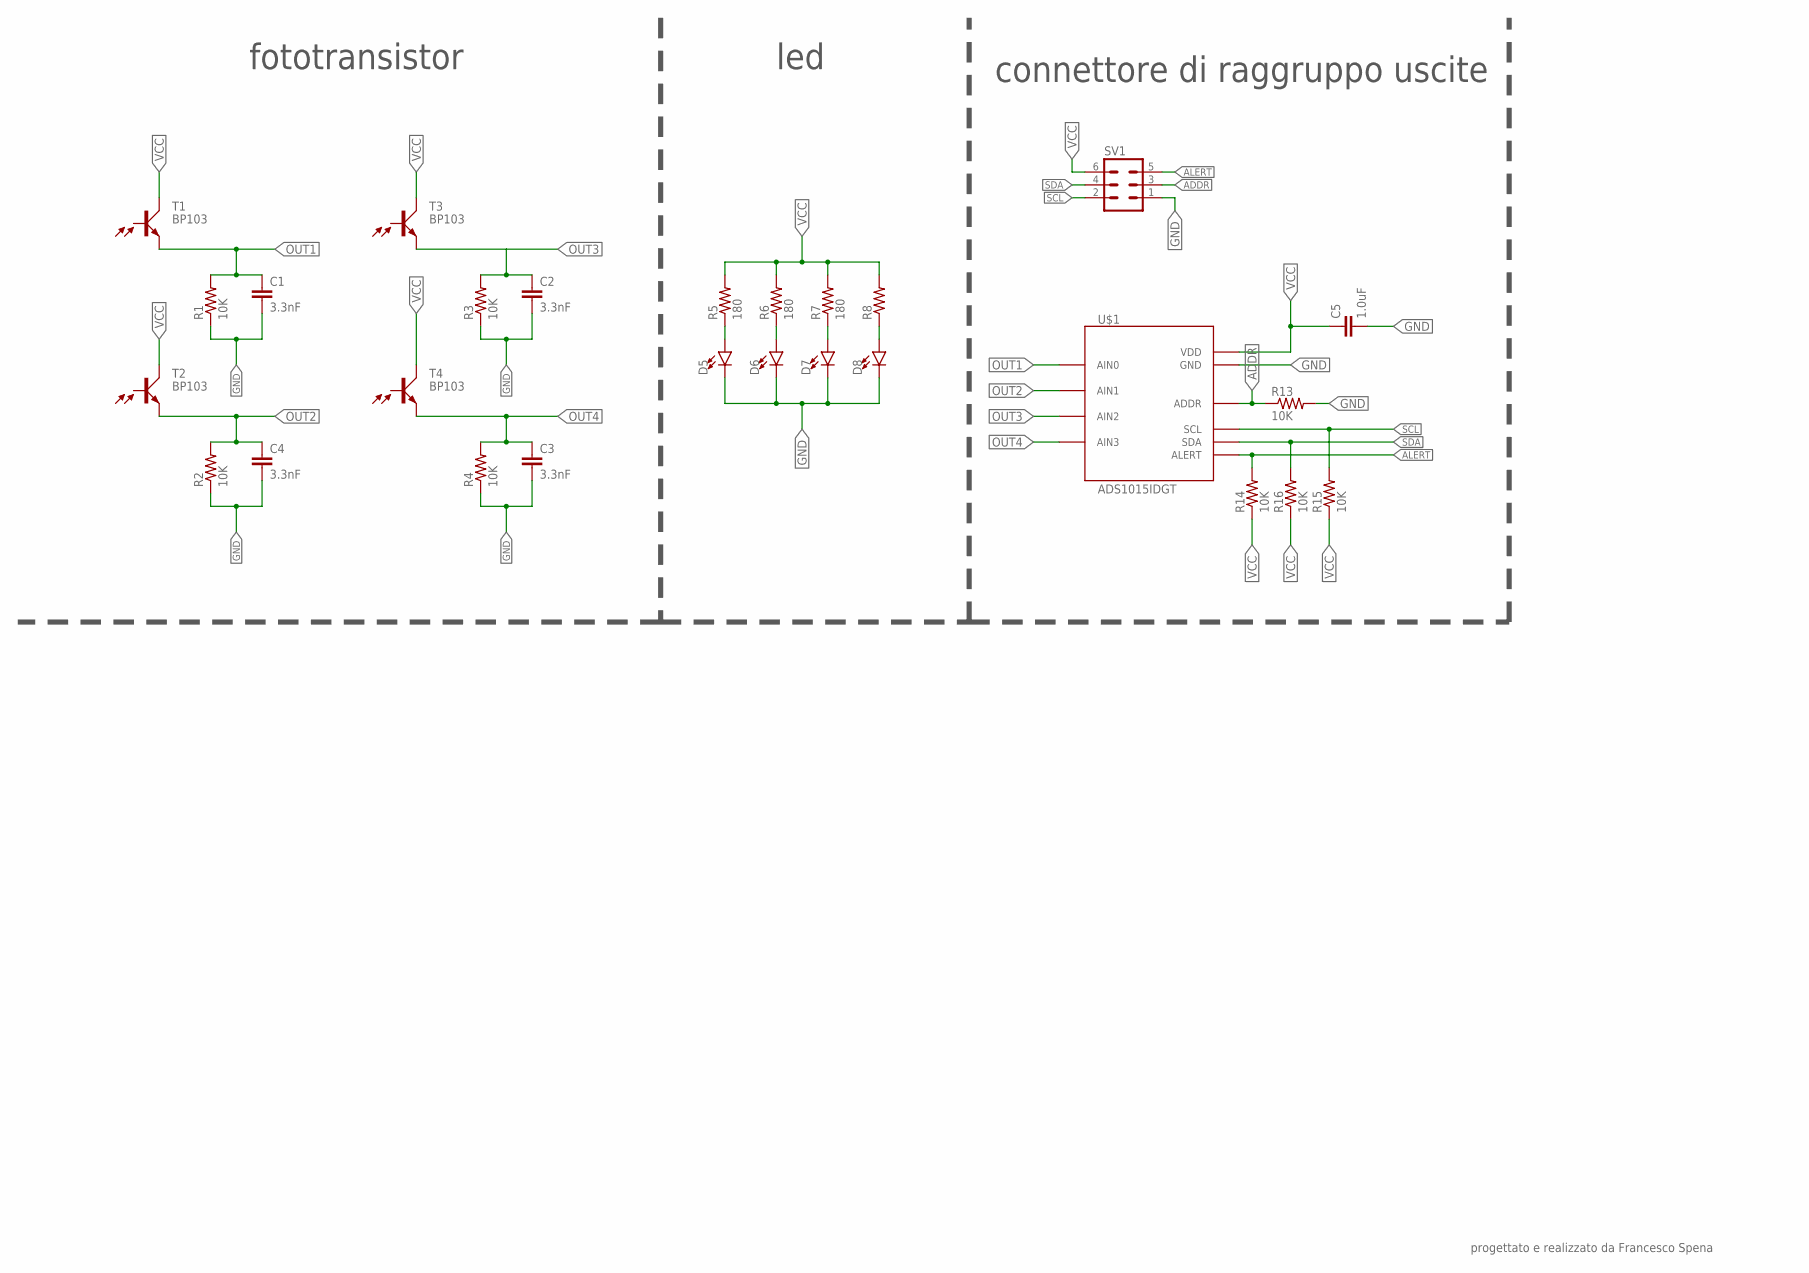
[picture p27: schematic sensore-linea.sch]

Parts:
C1, C2, C3, C4: 3.3nF; 0603
C5: 1.0uF; 0402
D5, D6, D7, D8: LED3MM; LED_3MM
R1, R2, R3, R4, R13, R14, R15, R16: 10K; 0204/7
R5, R6, R7: 180; 0204/7
R8: R-US_0204/7; 0204/7
SV1: MA03-2
T1, T2, T3, T4: BP103
U$1: ADS1015IDGT; MSOP10_0.5

Connections:
ADDR: R13.1, SV1.3, U$1.1 (ADDR)
ALERT: R14.2, SV1.5, U$1.2 (ALERT)
GND: C1.2, C2.2, C3.2, C4.2, C5.2, D5.K (C), D6.K (C), D7.K (C), D8.K (C), R1.1, R2.1, R3.1, R4.1, R13.2, SV1.1, U$1.3 (GND)
unnamed: D5.A, R5.1
unnamed: D6.A, R6.1
unnamed: D7.A, R7.1
unnamed: D8.A, R8.1
OUT1: C1.1, R1.2, T1.E, U$1.4 (AIN0)
OUT2: C4.1, R2.2, T2.E, U$1.5 (AIN1)
OUT3: C2.1, R3.2, T3.E, U$1.6 (AIN2)
OUT4: C3.1, R4.2, T4.E, U$1.7 (AIN3)
SCL: R15.2, SV1.2, U$1.10 (SCL)
SDA: R16.2, SV1.4, U$1.9 (SDA)
VCC: C5.1, R5.2, R6.2, R7.2, R8.2, R14.1, R15.1, R16.1, SV1.6, T1.C, T2.C, T3.C, T4.C, U$1.8 (VDD)

Notes on the sheet:
fototransistor
led
connettore di raggruppo uscite
progettato e realizzato da Francesco Spena

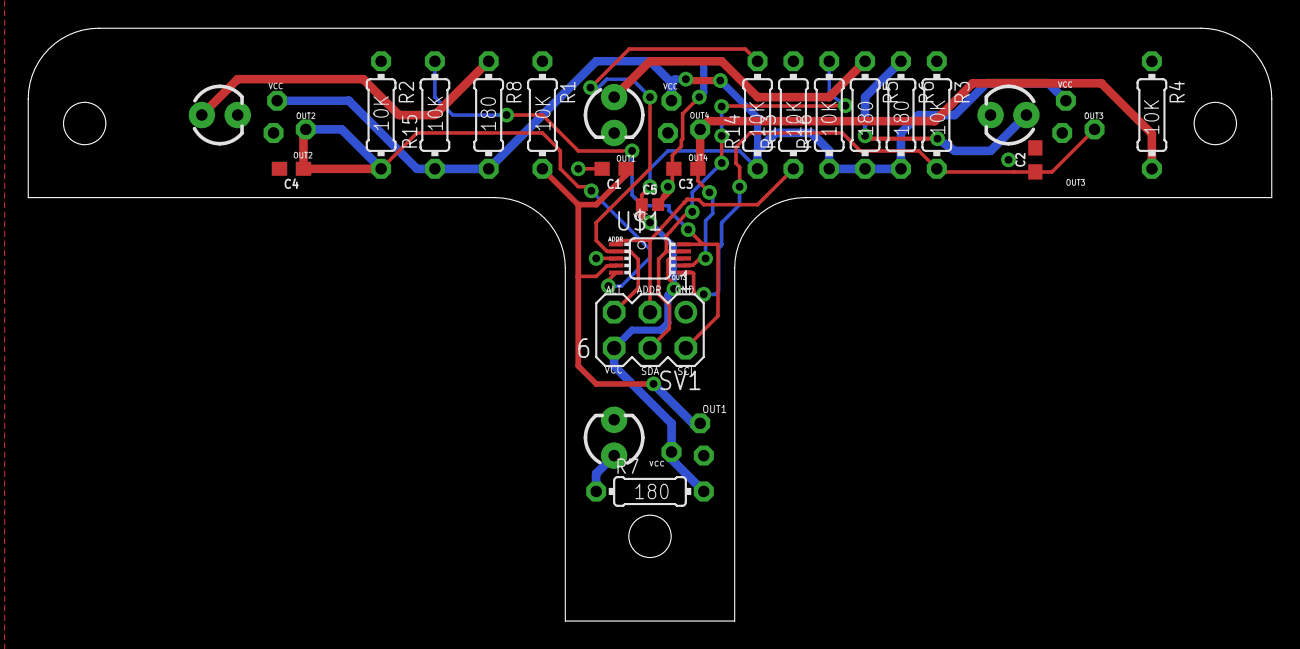
[picture p28: board Elettronica/Vecchie/Sensori_linea_1718/sensore-linea.brd from above]

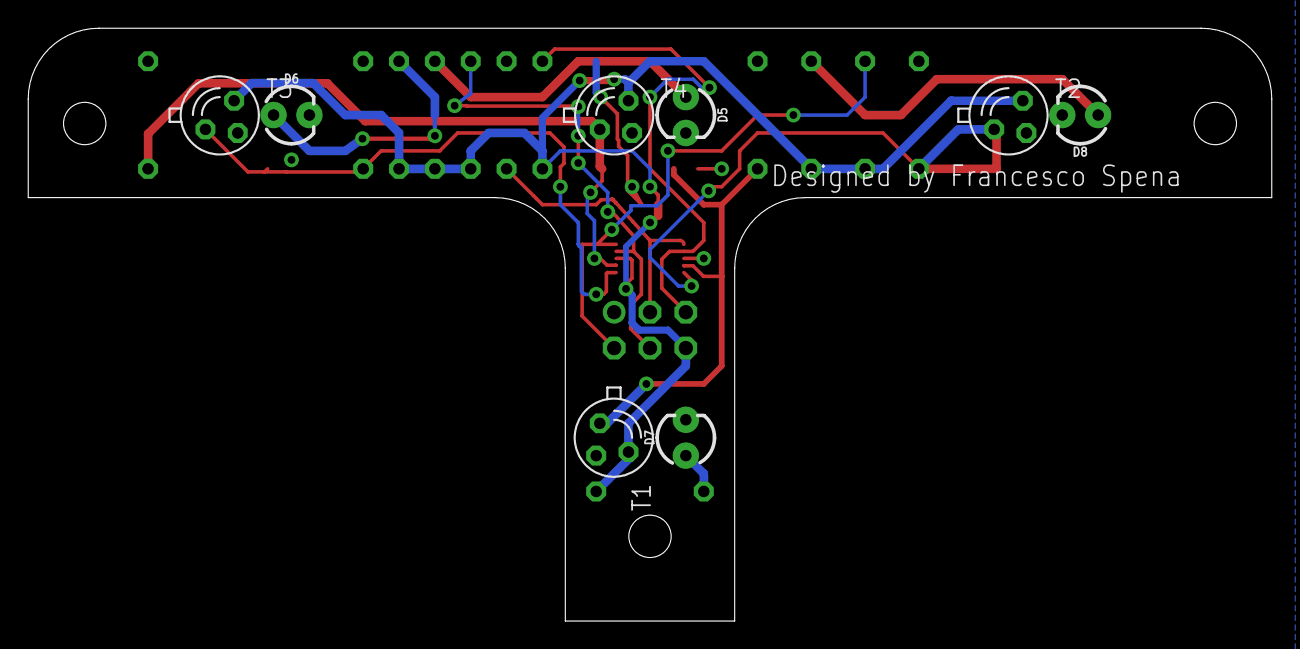
[picture p29: board Elettronica/Vecchie/Sensori_linea_1718/sensore-linea.brd from below]

Board: 2 copper layers, 88.1 x 42.0 mm, 27 parts (8 on the bottom side), 14 nets.
