Er-Chiacchiera/Soccer-2018-19/Elettronica/Vecchie/soccer-2015-pcb/Sotto/Calciatore Rev.2 DOWN.brd

## EAGLE design Elettronica/Vecchie/soccer-2015-pcb/Sotto/Calciatore Rev.2 DOWN.brd (2019-03-06)

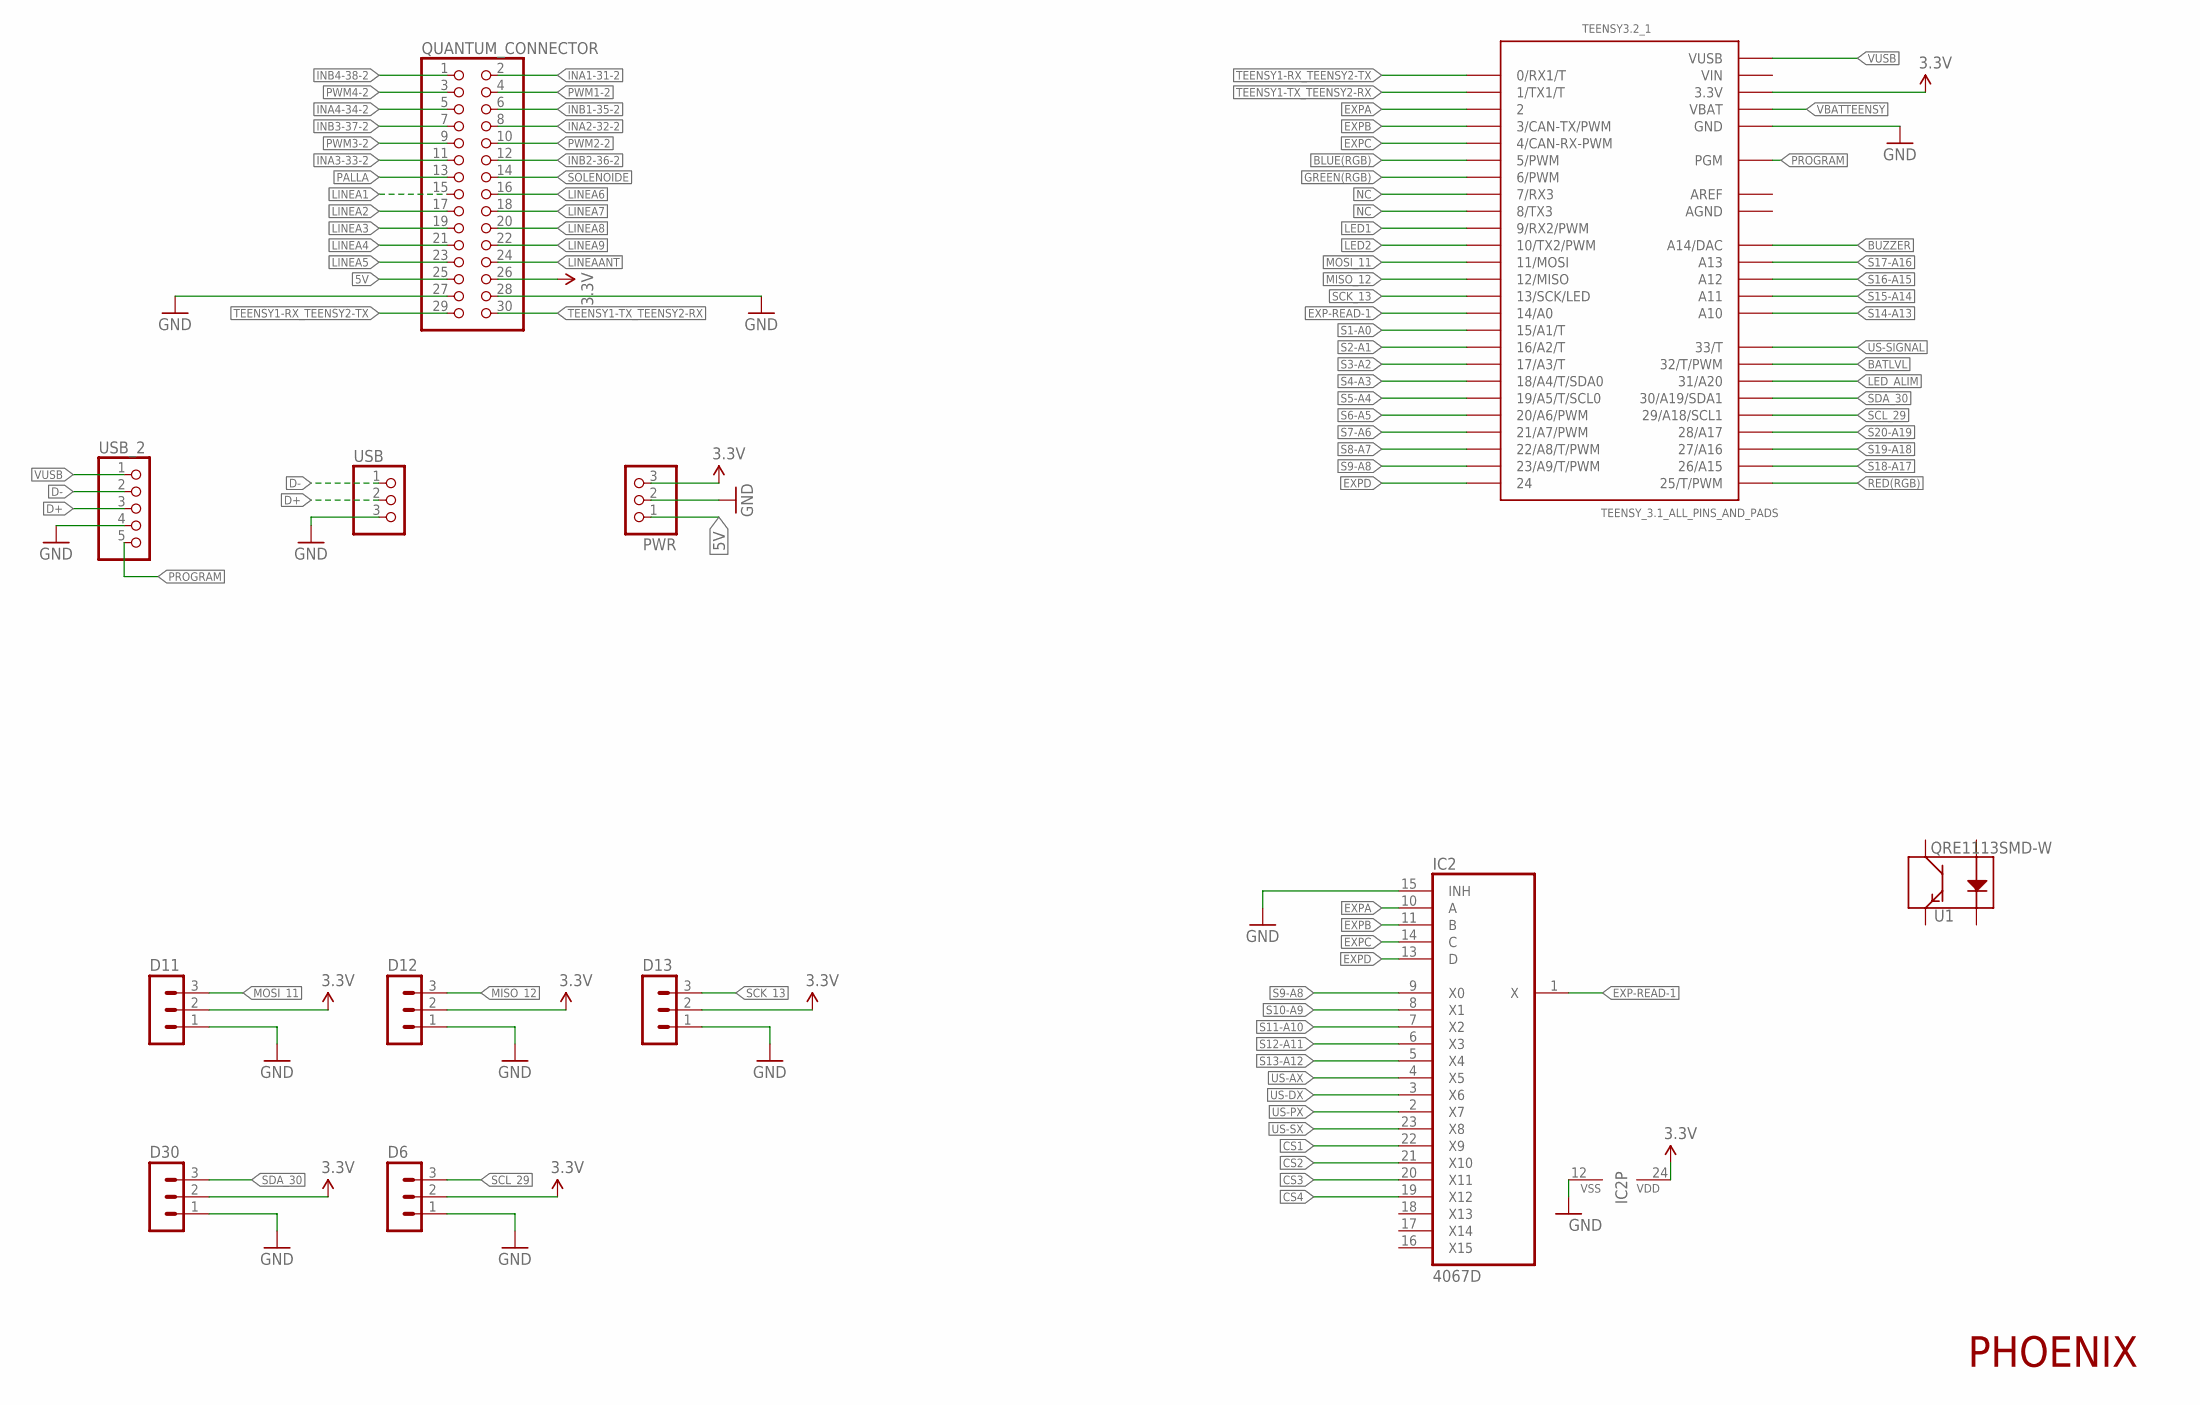
[picture p30: schematic Calciatore Rev.2 DOWN.sch, sheet 1]

Parts:
D6, D11, D12, D13, D30: MA03-1
IC2: 4067D; SO24W
PWR: PINHD-1X3; 1X03
QUANTUM_CONNECTOR: PINHD-2X15; 2X15
TEENSY3.2_1: TEENSY_3.1_ALL_PINS_AND_PADS; TEENSY3_ALL_PINS_&_PADS
U1: QRE1113SMD-W; QRE1113-W
USB: PINHD-1X3; 1X03
USB_2: PINHD-1X5; 1X05

Connections:
3.3V: D6.2, D11.2, D12.2, D13.2, D30.2, IC2.24 (VDD), PWR.3, QUANTUM_CONNECTOR.26, TEENSY3.2_1.3.3V, TEENSY3.2_1.3.3V1 (3.3V), TEENSY3.2_1.3.3V2 (3.3V); also elsewhere on the board
5V: PWR.1, QUANTUM_CONNECTOR.25; also elsewhere on the board
AGND: TEENSY3.2_1.AGND
AREF: TEENSY3.2_1.AREF
BATLVL: TEENSY3.2_1.32 (32/T/PWM); also elsewhere on the board
BLUE(RGB): TEENSY3.2_1.5 (5/PWM); also elsewhere on the board
BUZZER: TEENSY3.2_1.RESET/DAC (A14/DAC); also elsewhere on the board
CS1: IC2.22 (X9); also elsewhere on the board
CS2: IC2.21 (X10); also elsewhere on the board
CS3: IC2.20 (X11); also elsewhere on the board
CS4: IC2.19 (X12); also elsewhere on the board
D+: USB.2, USB_2.3
D-: USB.1, USB_2.2
EXP-READ-1: IC2.1 (X), TEENSY3.2_1.14/A0
EXPA: IC2.10 (A), TEENSY3.2_1.2
EXPB: IC2.11 (B), TEENSY3.2_1.3 (3/CAN-TX/PWM)
EXPC: IC2.14 (C), TEENSY3.2_1.4 (4/CAN-RX-PWM)
EXPD: IC2.13 (D), TEENSY3.2_1.24
GND: D6.1, D11.1, D12.1, D13.1, D30.1, IC2.12 (VSS), IC2.15 (INH), PWR.2, QUANTUM_CONNECTOR.27, QUANTUM_CONNECTOR.28, TEENSY3.2_1.GND, TEENSY3.2_1.GND1 (GND), TEENSY3.2_1.GND2 (GND), USB.3, USB_2.4; also elsewhere on the board
GREEN(RGB): TEENSY3.2_1.6 (6/PWM); also elsewhere on the board
INA1-31-2: QUANTUM_CONNECTOR.2; also elsewhere on the board
INA2-32-2: QUANTUM_CONNECTOR.8; also elsewhere on the board
INA3-33-2: QUANTUM_CONNECTOR.11; also elsewhere on the board
INA4-34-2: QUANTUM_CONNECTOR.5; also elsewhere on the board
INB1-35-2: QUANTUM_CONNECTOR.6; also elsewhere on the board
INB2-36-2: QUANTUM_CONNECTOR.12; also elsewhere on the board
INB3-37-2: QUANTUM_CONNECTOR.7; also elsewhere on the board
INB4-38-2: QUANTUM_CONNECTOR.1; also elsewhere on the board
LED1: TEENSY3.2_1.9 (9/RX2/PWM); also elsewhere on the board
LED2: TEENSY3.2_1.10 (10/TX2/PWM); also elsewhere on the board
LED_ALIM: TEENSY3.2_1.31 (31/A20); also elsewhere on the board
LINEA1: QUANTUM_CONNECTOR.15
LINEA2: QUANTUM_CONNECTOR.17
LINEA3: QUANTUM_CONNECTOR.19
LINEA4: QUANTUM_CONNECTOR.21
LINEA5: QUANTUM_CONNECTOR.23
LINEA6: QUANTUM_CONNECTOR.16
LINEA7: QUANTUM_CONNECTOR.18
LINEA8: QUANTUM_CONNECTOR.20
LINEA9: QUANTUM_CONNECTOR.22
LINEAANT: QUANTUM_CONNECTOR.24
MISO_12: D12.3, TEENSY3.2_1.12 (12/MISO)
MOSI_11: D11.3, TEENSY3.2_1.11 (11/MOSI)
NC: TEENSY3.2_1.7 (7/RX3), TEENSY3.2_1.8 (8/TX3)
PALLA: QUANTUM_CONNECTOR.13
PROGRAM: TEENSY3.2_1.PGM, USB_2.5
PWM1-2: QUANTUM_CONNECTOR.4; also elsewhere on the board
PWM2-2: QUANTUM_CONNECTOR.10; also elsewhere on the board
PWM3-2: QUANTUM_CONNECTOR.9; also elsewhere on the board
PWM4-2: QUANTUM_CONNECTOR.3; also elsewhere on the board
RED(RGB): TEENSY3.2_1.25 (25/T/PWM); also elsewhere on the board
S1-A0: TEENSY3.2_1.15/A1 (15/A1/T); also elsewhere on the board
S2-A1: TEENSY3.2_1.16/A2 (16/A2/T); also elsewhere on the board
S3-A2: TEENSY3.2_1.17/A3 (17/A3/T); also elsewhere on the board
S4-A3: TEENSY3.2_1.18/A4 (18/A4/T/SDA0); also elsewhere on the board
S5-A4: TEENSY3.2_1.19/A5 (19/A5/T/SCL0); also elsewhere on the board
S6-A5: TEENSY3.2_1.20/A6 (20/A6/PWM); also elsewhere on the board
S7-A6: TEENSY3.2_1.21/A7 (21/A7/PWM); also elsewhere on the board
S8-A7: TEENSY3.2_1.22/A8 (22/A8/T/PWM); also elsewhere on the board
S9-A8: IC2.9 (X0), TEENSY3.2_1.23/A9 (23/A9/T/PWM); also elsewhere on the board
S10-A9: IC2.8 (X1); also elsewhere on the board
S11-A10: IC2.7 (X2); also elsewhere on the board
S12-A11: IC2.6 (X3); also elsewhere on the board
S13-A12: IC2.5 (X4); also elsewhere on the board
S14-A13: TEENSY3.2_1.A10; also elsewhere on the board
S15-A14: TEENSY3.2_1.A11; also elsewhere on the board
S16-A15: TEENSY3.2_1.A12; also elsewhere on the board
S17-A16: TEENSY3.2_1.A13; also elsewhere on the board
S18-A17: TEENSY3.2_1.26 (26/A15); also elsewhere on the board
S19-A18: TEENSY3.2_1.27 (27/A16); also elsewhere on the board
S20-A19: TEENSY3.2_1.28 (28/A17); also elsewhere on the board
SCK_13: D13.3, TEENSY3.2_1.13 (13/SCK/LED)
SCL_29: D6.3, TEENSY3.2_1.29 (29/A18/SCL1)
SDA_30: D30.3, TEENSY3.2_1.30 (30/A19/SDA1)
SOLENOIDE: QUANTUM_CONNECTOR.14; also elsewhere on the board
TEENSY1-RX_TEENSY2-TX: QUANTUM_CONNECTOR.29, TEENSY3.2_1.0 (0/RX1/T)
TEENSY1-TX_TEENSY2-RX: QUANTUM_CONNECTOR.30, TEENSY3.2_1.1 (1/TX1/T)
US-AX: IC2.4 (X5); also elsewhere on the board
US-DX: IC2.3 (X6); also elsewhere on the board
US-PX: IC2.2 (X7); also elsewhere on the board
US-SIGNAL: TEENSY3.2_1.33 (33/T); also elsewhere on the board
US-SX: IC2.23 (X8); also elsewhere on the board
VBATTEENSY: TEENSY3.2_1.VBAT
VIN: TEENSY3.2_1.VIN; also elsewhere on the board
VUSB: TEENSY3.2_1.VUSB, USB_2.1

Notes on the sheet:
PHOENIX

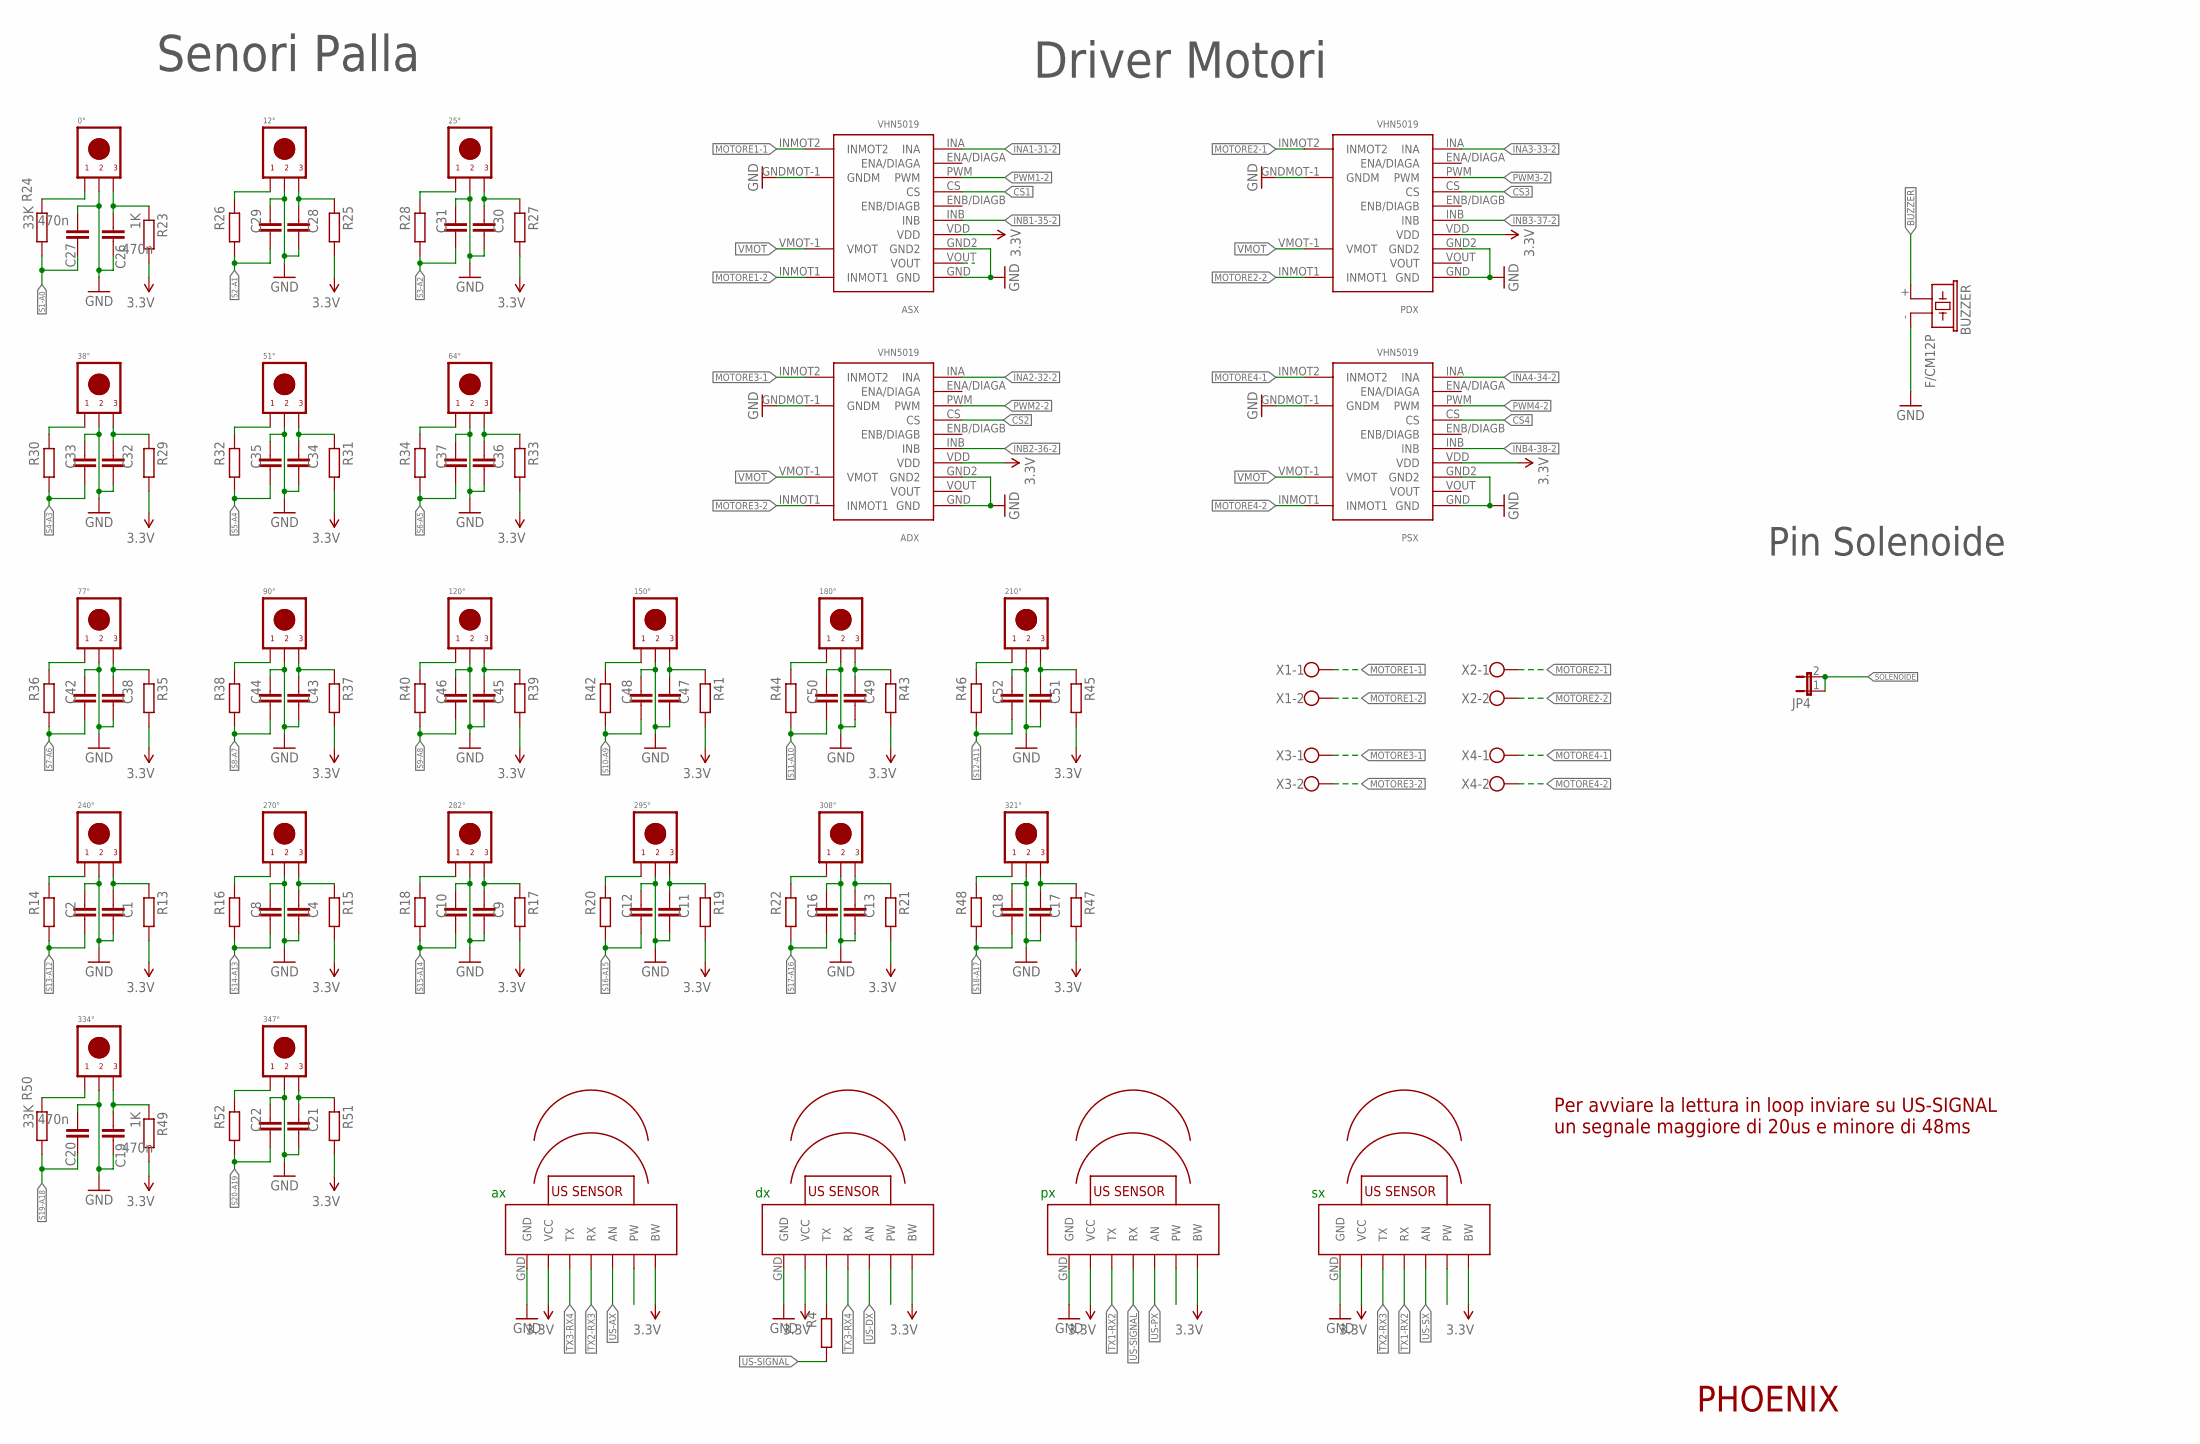
[picture p31: schematic Calciatore Rev.2 DOWN.sch, sheet 2]

Parts:
0°, 12°, 25°, 38°, 51°, 64°, 77°, 90°, 120°, 150°, 180°, 210°, 240°, 270°, 282°, 295°, 308°, 321°, 334°, 347°: effe; TSOP4840
ADX: VHN5019; MOTOR-SHIELD
ASX: VHN5019; MOTOR-SHIELD
AX: MB1010
BUZZER: F/CM12P
C1, C2, C4, C8, C9, C10, C11, C12, C13, C16, C17, C18, C21, C22, C28, C29, C30, C31, C32, C33, C34, C35, C36, C37, C38, C42, C43, C44, C45, C46, C47, C48, C49, C50, C51, C52: C-EUC1206; C1206
C19, C20, C26, C27: 470n; C1206
DX: MB1010
JP4: JP1E; JP1
PDX: VHN5019; MOTOR-SHIELD
PSX: VHN5019; MOTOR-SHIELD
PX: MB1010
R4, R13, R14, R15, R16, R17, R18, R19, R20, R21, R22, R25, R26, R27, R28, R29, R30, R31, R32, R33, R34, R35, R36, R37, R38, R39, R40, R41, R42, R43, R44, R45, R46, R47, R48, R51, R52: R-EU_M1206; M1206
R23, R49: 1K; M1206
R24, R50: 33K; M1206
SX: MB1010
X1, X2, X3, X4: W237-102

Connections:
3.3V: ADX.VDD, ASX.VDD, AX.BW, AX.VCC, DX.BW, DX.VCC, PDX.VDD, PSX.VDD, PX.BW, PX.VCC, R13.2, R15.2, R17.2, R19.2, R21.2, R23.2, R25.2, R27.2, R29.2, R31.2, R33.2, R35.2, R37.2, R39.2, R41.2, R43.2, R45.2, R47.2, R49.2, R51.2, SX.BW, SX.VCC; also elsewhere on the board
BUZZER: BUZZER.+ (1); also elsewhere on the board
CS1: ASX.CS; also elsewhere on the board
CS2: ADX.CS; also elsewhere on the board
CS3: PDX.CS; also elsewhere on the board
CS4: PSX.CS; also elsewhere on the board
GND: 0°.GND, 12°.GND, 25°.GND, 38°.GND, 51°.GND, 64°.GND, 77°.GND, 90°.GND, 120°.GND, 150°.GND, 180°.GND, 210°.GND, 240°.GND, 270°.GND, 282°.GND, 295°.GND, 308°.GND, 321°.GND, 334°.GND, 347°.GND, ADX.GND, ADX.GND2, ADX.GNDMOT-1 (GNDM), ASX.GND, ASX.GND2, ASX.GNDMOT-1 (GNDM), AX.GND, BUZZER.- (2), C1.2, C2.1, C4.2, C8.1, C9.2, C10.1, C11.2, C12.1, C13.2, C16.1, C17.2, C18.1, C19.2, C20.2, C21.2, C22.1, C26.2, C27.2, C28.2, C29.1, C30.2, C31.1, C32.2, C33.1, C34.2, C35.1, C36.2, C37.1, C38.2, C42.1, C43.2, C44.1, C45.2, C46.1, C47.2, C48.1, C49.2, C50.1, C51.2, C52.1, DX.GND, PDX.GND, PDX.GND2, PDX.GNDMOT-1 (GNDM), PSX.GND, PSX.GND2, PSX.GNDMOT-1 (GNDM), PX.GND, SX.GND; also elsewhere on the board
INA1-31-2: ASX.INA; also elsewhere on the board
INA2-32-2: ADX.INA; also elsewhere on the board
INA3-33-2: PDX.INA; also elsewhere on the board
INA4-34-2: PSX.INA; also elsewhere on the board
INB1-35-2: ASX.INB; also elsewhere on the board
INB2-36-2: ADX.INB; also elsewhere on the board
INB3-37-2: PDX.INB; also elsewhere on the board
INB4-38-2: PSX.INB; also elsewhere on the board
MOTORE1-1: ASX.INMOT2, X1.1
MOTORE1-2: ASX.INMOT1, X1.2
MOTORE2-1: PDX.INMOT2, X2.1
MOTORE2-2: PDX.INMOT1, X2.2
MOTORE3-1: ADX.INMOT2, X3.1
MOTORE3-2: ADX.INMOT1, X3.2
MOTORE4-1: PSX.INMOT2, X4.1
MOTORE4-2: PSX.INMOT1, X4.2
unnamed: 0°.VCC, C26.1, R23.1
unnamed: 0°.OUT, R24.1
unnamed: 12°.VCC, C28.1, R25.1
unnamed: 12°.OUT, R26.1
unnamed: 240°.VCC, C1.1, R13.1
unnamed: 270°.VCC, C4.1, R15.1
unnamed: 282°.VCC, C9.1, R17.1
unnamed: 25°.OUT, R28.1
unnamed: 38°.OUT, R30.1
unnamed: 51°.OUT, R32.1
unnamed: 25°.VCC, C30.1, R27.1
unnamed: 295°.VCC, C11.1, R19.1
unnamed: 308°.VCC, C13.1, R21.1
unnamed: 321°.VCC, C17.1, R47.1
unnamed: 64°.OUT, R34.1
unnamed: 38°.VCC, C32.1, R29.1
unnamed: 77°.OUT, R36.1
unnamed: 51°.VCC, C34.1, R31.1
unnamed: 120°.OUT, R40.1
unnamed: 64°.VCC, C36.1, R33.1
unnamed: 180°.OUT, R44.1
unnamed: 77°.VCC, C38.1, R35.1
unnamed: 90°.OUT, R38.1
unnamed: 90°.VCC, C43.1, R37.1
unnamed: 150°.OUT, R42.1
unnamed: 120°.VCC, C45.1, R39.1
unnamed: 210°.OUT, R46.1
unnamed: 150°.VCC, C47.1, R41.1
unnamed: 240°.OUT, R14.1
unnamed: 180°.VCC, C49.1, R43.1
unnamed: 270°.OUT, R16.1
unnamed: 210°.VCC, C51.1, R45.1
unnamed: 282°.OUT, R18.1
unnamed: 295°.OUT, R20.1
unnamed: 308°.OUT, R22.1
unnamed: 321°.OUT, R48.1
unnamed: 334°.VCC, C19.1, R49.1
unnamed: 347°.VCC, C21.1, R51.1
unnamed: 334°.OUT, R50.1
unnamed: 347°.OUT, R52.1
unnamed: DX.TX, R4.1
PWM1-2: ASX.PWM; also elsewhere on the board
PWM2-2: ADX.PWM; also elsewhere on the board
PWM3-2: PDX.PWM; also elsewhere on the board
PWM4-2: PSX.PWM; also elsewhere on the board
S1-A0: C27.1, R24.2; also elsewhere on the board
S2-A1: C29.2, R26.2; also elsewhere on the board
S3-A2: C31.2, R28.2; also elsewhere on the board
S4-A3: C33.2, R30.2; also elsewhere on the board
S5-A4: C35.2, R32.2; also elsewhere on the board
S6-A5: C37.2, R34.2; also elsewhere on the board
S7-A6: C42.2, R36.2; also elsewhere on the board
S8-A7: C44.2, R38.2; also elsewhere on the board
S9-A8: C46.2, R40.2; also elsewhere on the board
S10-A9: C48.2, R42.2; also elsewhere on the board
S11-A10: C50.2, R44.2; also elsewhere on the board
S12-A11: C52.2, R46.2; also elsewhere on the board
S13-A12: C2.2, R14.2; also elsewhere on the board
S14-A13: C8.2, R16.2; also elsewhere on the board
S15-A14: C10.2, R18.2; also elsewhere on the board
S16-A15: C12.2, R20.2; also elsewhere on the board
S17-A16: C16.2, R22.2; also elsewhere on the board
S18-A17: C18.2, R48.2; also elsewhere on the board
S19-A18: C20.1, R50.2; also elsewhere on the board
S20-A19: C22.2, R52.2; also elsewhere on the board
SOLENOIDE: JP4.1, JP4.2; also elsewhere on the board
TX1-RX2: PX.TX, SX.RX
TX2-RX3: AX.RX, SX.TX
TX3-RX4: AX.TX, DX.RX
US-AX: AX.AN; also elsewhere on the board
US-DX: DX.AN; also elsewhere on the board
US-PX: PX.AN; also elsewhere on the board
US-SIGNAL: PX.RX, R4.2; also elsewhere on the board
US-SX: SX.AN; also elsewhere on the board
VMOT: ADX.VMOT-1 (VMOT), ASX.VMOT-1 (VMOT), PDX.VMOT-1 (VMOT), PSX.VMOT-1 (VMOT); also elsewhere on the board
VOUT: ASX.VOUT

Notes on the sheet:
Driver Motori
Senori Palla
Pin Solenoide
PHOENIX
Per avviare la lettura in loop inviare su US-SIGNAL un segnale maggiore di 20us e minore di 48ms

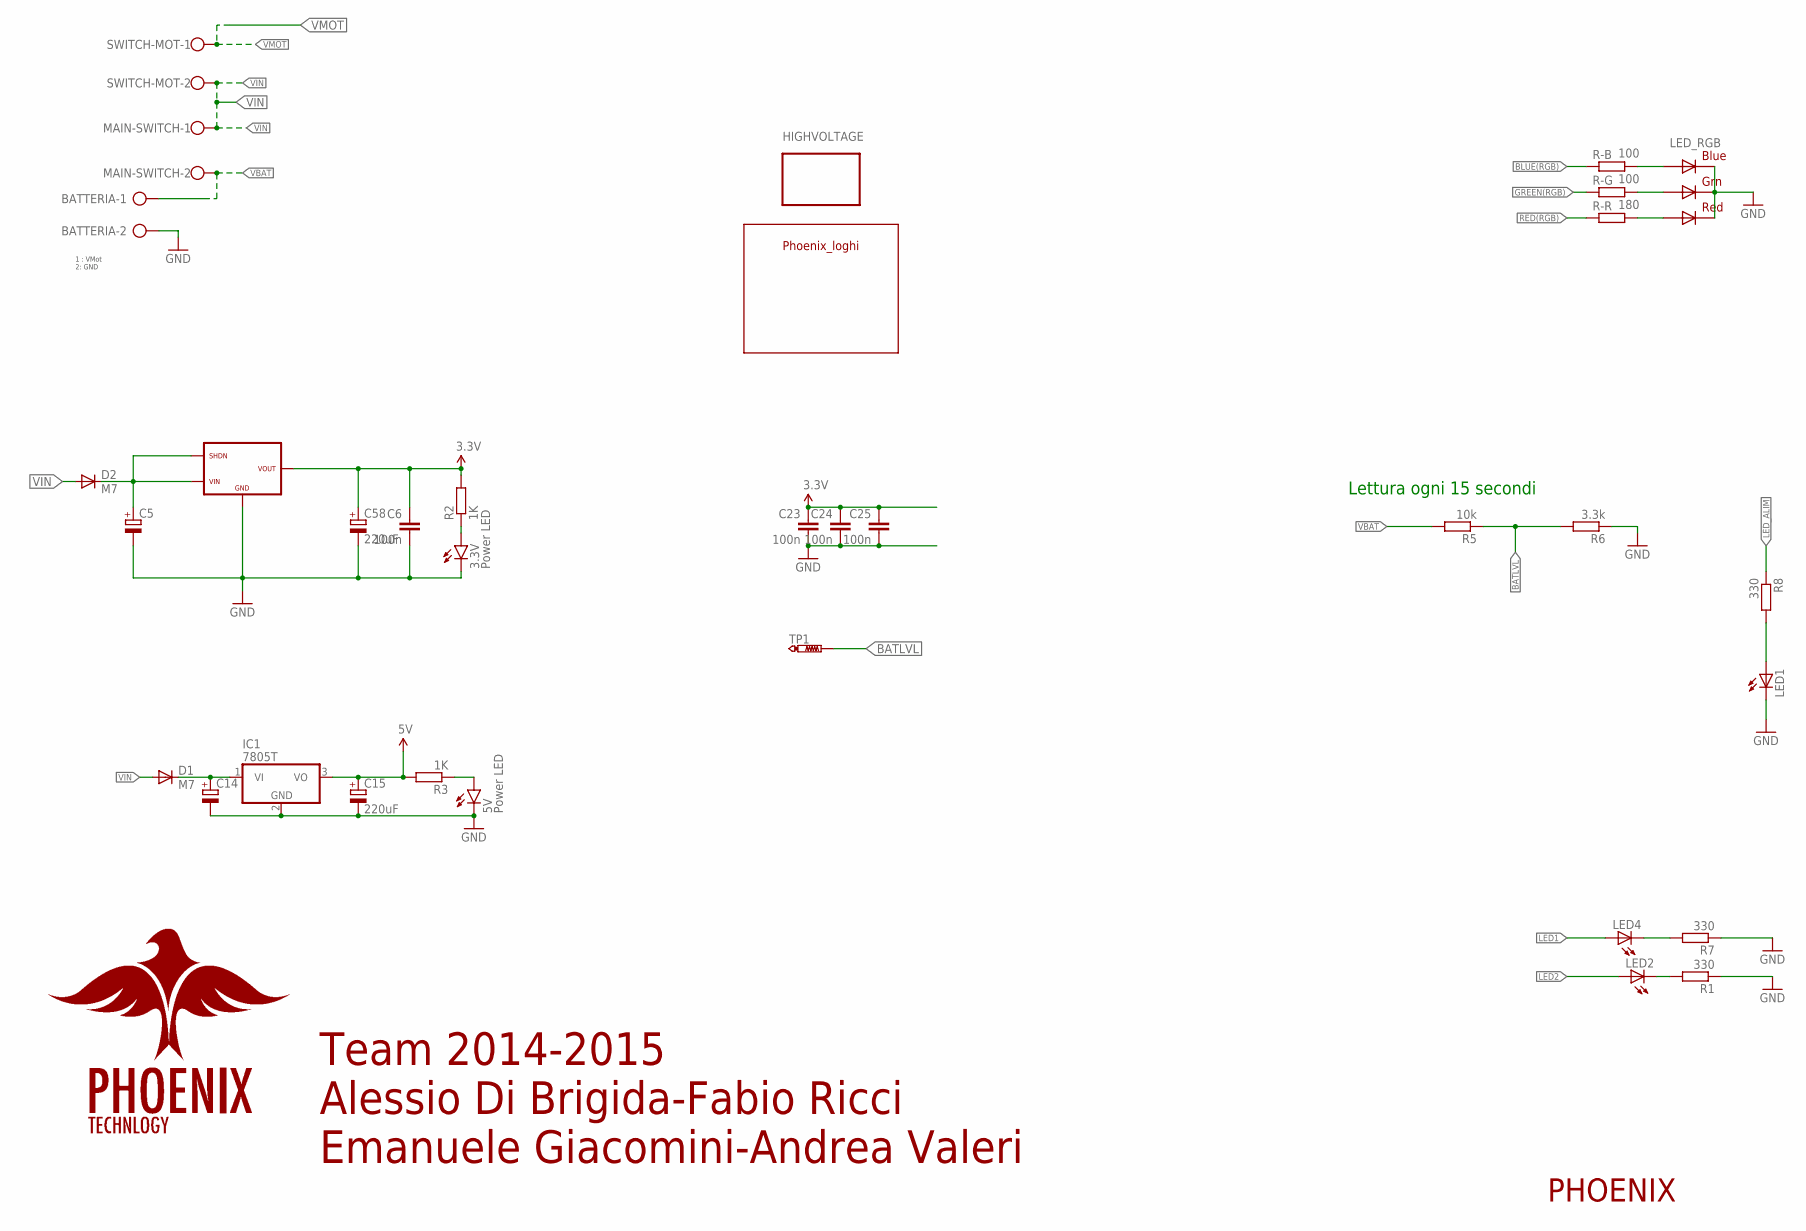
[picture p32: schematic Calciatore Rev.2 DOWN.sch, sheet 3]

Parts:
3.3V, 5V: Power LED; FKIT-LED-1206
BATTERIA: AK500/2-H
C5, C14: CPOL-EUE5-8.5; E5-8,5
C6, C23, C24, C25: 100n; C1206
C15, C58: 220uF; E5-8,5
D1, D2: M7; SMB
HIGHVOLTAGE: LOGO; LOGOHV
IC1: 7805T; TO220H
LED1, LED2, LED4: LEDSMT1206; 1206
LED_RGB: RGBLED5050
MAIN-SWITCH: W237-102
R1, R7, R8: 330; M1206
R2, R3: 1K; M1206
R5: 10k; M1206
R6: 3.3k; M1206
R-B: 100; M1206
R-G: 100; M1206
R-R: 180; M1206
SWITCH-MOT: W237-102
TP1: PTR1TP17SQ; TP17SQ
U$8: PHOENIX_LOGHI
U$10: ALIM; ALIM_SWITCHING

Connections:
3.3V: C6.1, C23.1, C24.1, C25.1, C58.+, R2.2, U$10.VOUT; also elsewhere on the board
5V: C15.+, IC1.3 (VO), R3.2; also elsewhere on the board
BATLVL: R5.1, R6.2, TP1.TP; also elsewhere on the board
BLUE(RGB): R-B.1; also elsewhere on the board
GND: 3.3V.C, 5V.C, BATTERIA.2, C5.-, C6.2, C14.-, C15.-, C23.2, C24.2, C25.2, C58.-, IC1.2 (GND), LED1.C, LED_RGB.4 (BLUE_C), LED_RGB.5 (RED_C), LED_RGB.6 (GREEN_C), R1.1, R6.1, R7.1, U$10.GND; also elsewhere on the board
GREEN(RGB): R-G.1; also elsewhere on the board
LED1: LED4.A; also elsewhere on the board
LED2: LED2.A; also elsewhere on the board
LED_ALIM: R8.1; also elsewhere on the board
unnamed: LED2.C, R1.2
unnamed: LED1.A, R8.2
unnamed: C5.+, D2.C, U$10.SHDN, U$10.VIN
unnamed: 3.3V.A, R2.1
unnamed: LED_RGB.3 (BLUE_A), R-B.2
unnamed: LED_RGB.1 (GREEN_A), R-G.2
unnamed: LED4.C, R7.2
unnamed: LED_RGB.2 (RED_A), R-R.2
unnamed: C14.+, D1.C, IC1.1 (VI)
unnamed: 5V.A, R3.1
RED(RGB): R-R.1; also elsewhere on the board
VBAT: BATTERIA.1, MAIN-SWITCH.2, R5.2
VIN: D1.A, D2.A, MAIN-SWITCH.1, SWITCH-MOT.2; also elsewhere on the board
VMOT: SWITCH-MOT.1; also elsewhere on the board

Notes on the sheet:
Team 2014-2015 Alessio Di Brigida-Fabio Ricci Emanuele Giacomini-Andrea Valeri
PHOENIX
1 : VMot 2: GND
Lettura ogni 15 secondi

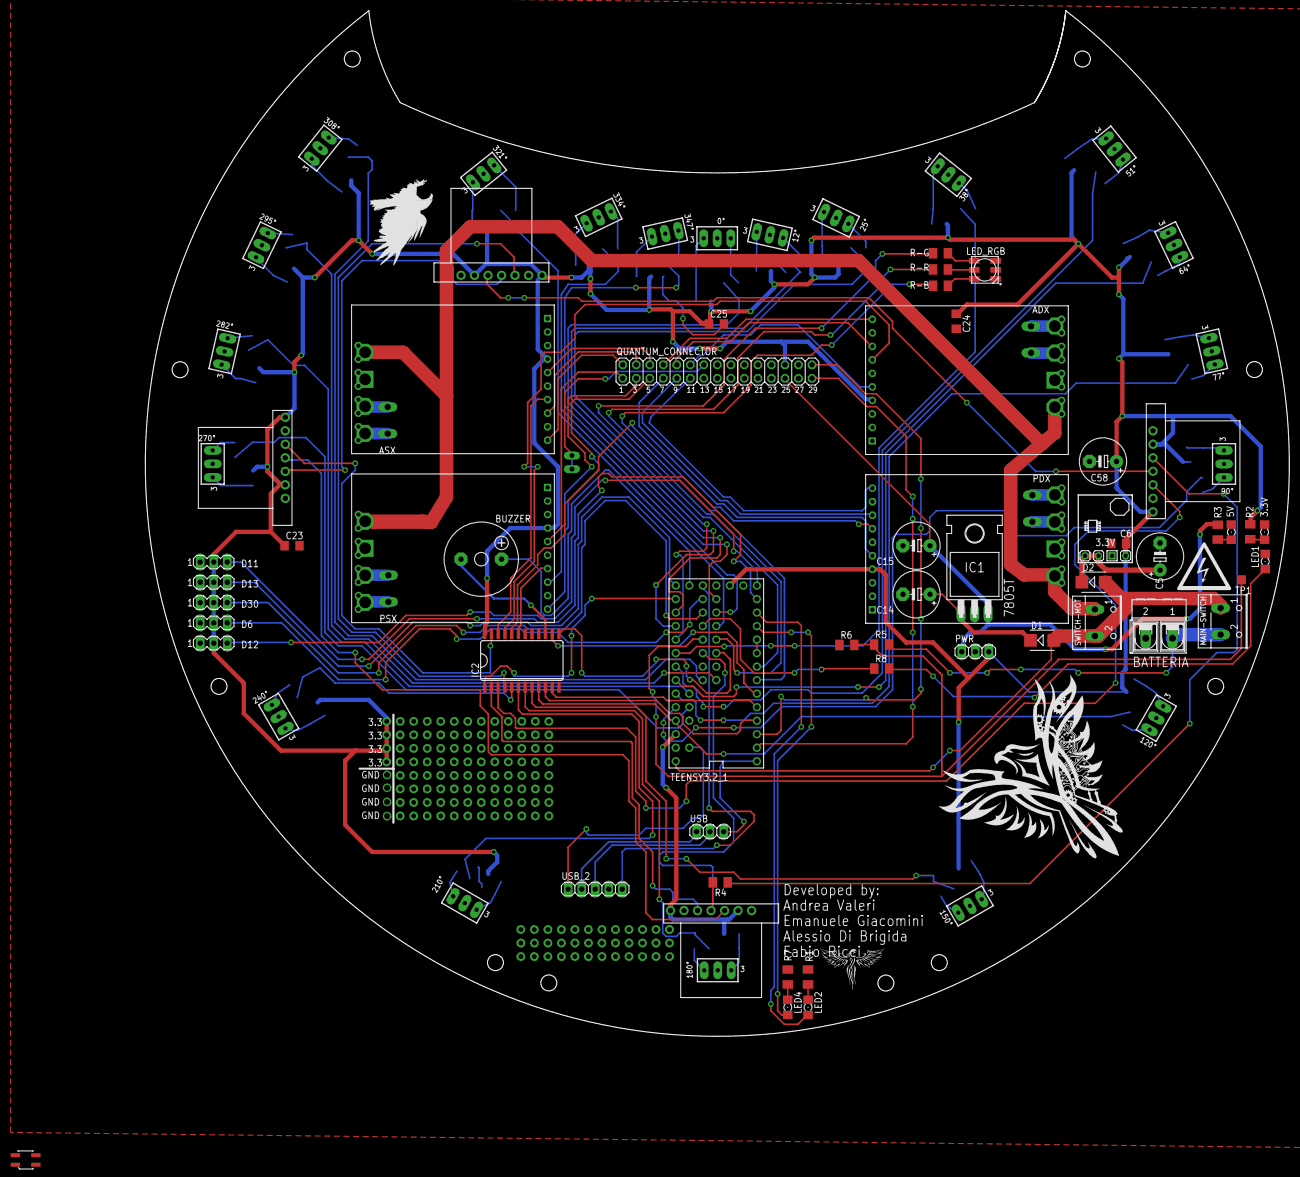
[picture p33: board Calciatore Rev.2 DOWN.brd from above]

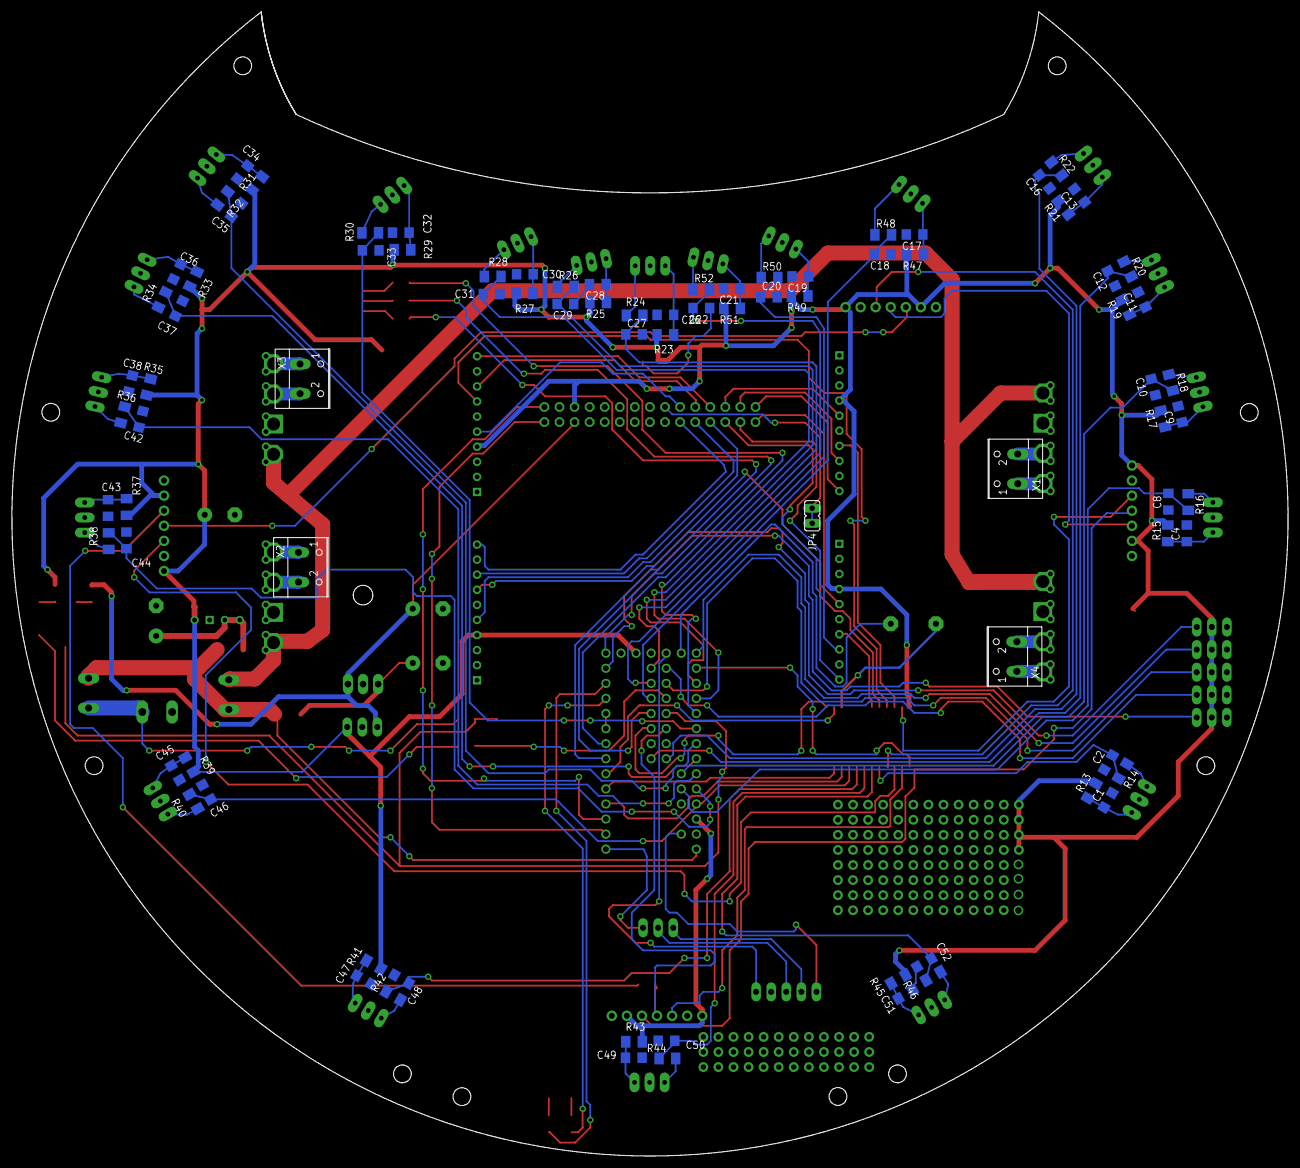
[picture p34: board Calciatore Rev.2 DOWN.brd from below]

Board: 2 copper layers, 215.0 x 192.7 mm, 163 parts (85 on the bottom side), 135 nets.

Other parts of the board:
U$5: EAGLE-PLC-12MM
U$12: PHOENIX
