Er-Chiacchiera/Soccer-2018-19/Elettronica/Vecchie/soccer-2015-pcb/sopra/Calciatore Rev.2 UP.brd

## EAGLE design Elettronica/Vecchie/soccer-2015-pcb/sopra/Calciatore Rev.2 UP.brd (2019-03-06)

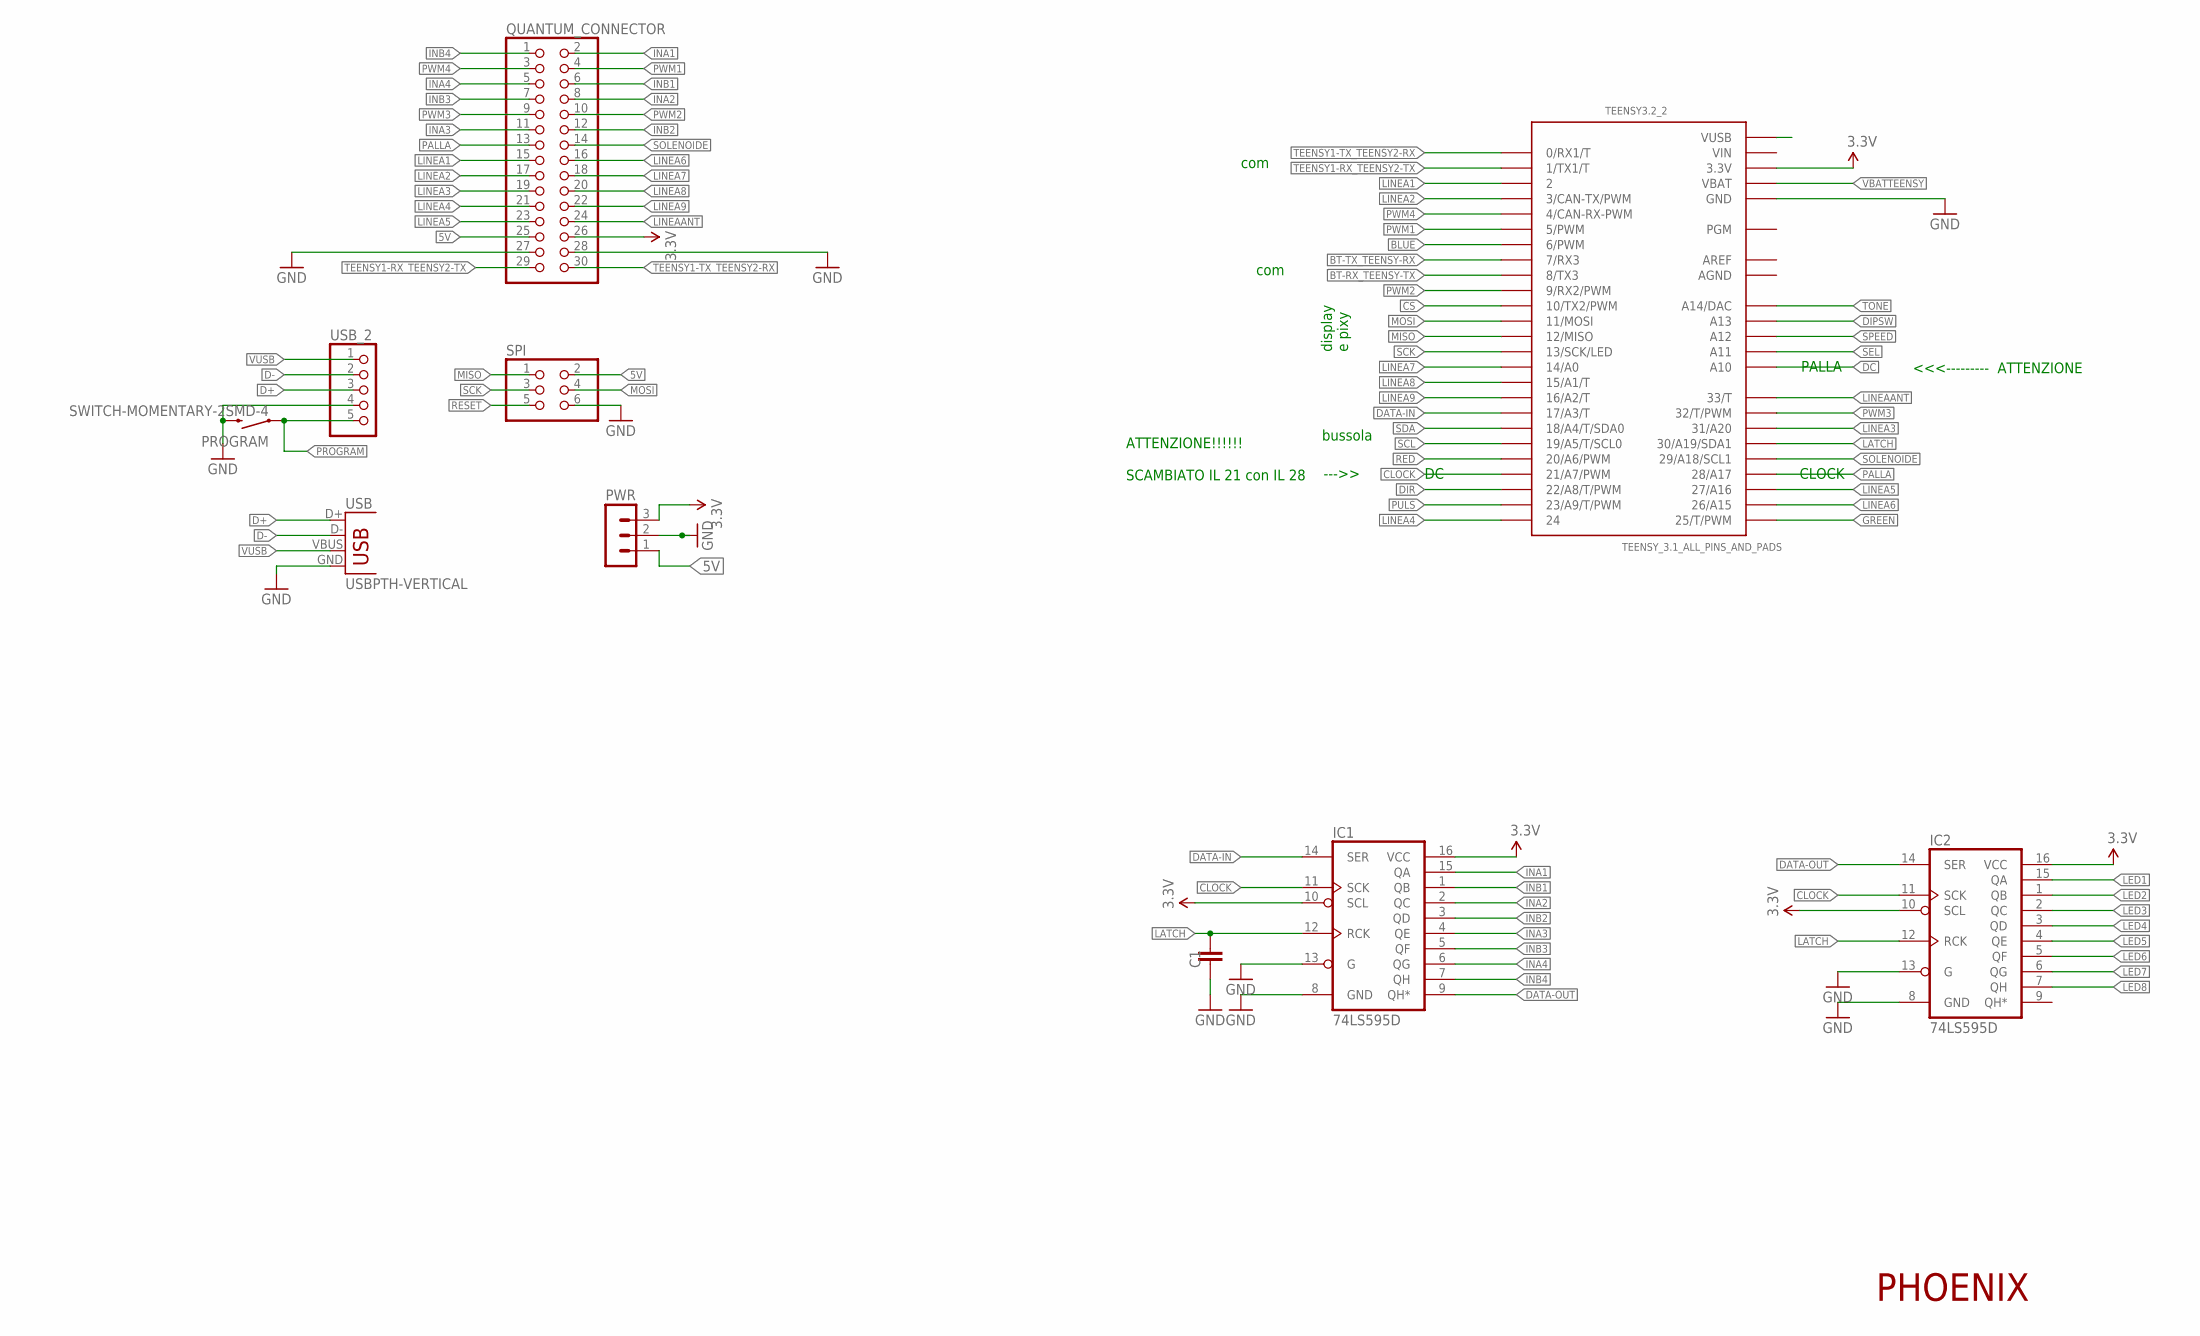
[picture p35: schematic Calciatore Rev.2 UP.sch, sheet 1]

Parts:
C1: C-EUC1206; C1206
IC1, IC2: 74LS595D; SO16
PROGRAM: SWITCH-MOMENTARY-2SMD-4; TACTILE_SWITCH_TALL
PWR: MA03-1
QUANTUM_CONNECTOR: PINHD-2X15; 2X15
SPI: PINHD-2X3; 2X03
TEENSY3.2_2: TEENSY_3.1_ALL_PINS_AND_PADS; TEENSY3_ALL_PINS_&_PADS
USB: USBPTH-VERTICAL; USB-B-PTH-VERTICAL
USB_2: PINHD-1X5; 1X05

Connections:
3.3V: IC1.10 (SCL), IC1.16 (VCC), IC2.10 (SCL), IC2.16 (VCC), PWR.3, QUANTUM_CONNECTOR.26, TEENSY3.2_2.3.3V, TEENSY3.2_2.3.3V1 (3.3V), TEENSY3.2_2.3.3V2 (3.3V); also elsewhere on the board
5V: PWR.1, QUANTUM_CONNECTOR.25, SPI.2; also elsewhere on the board
AGND: TEENSY3.2_2.AGND
AREF: TEENSY3.2_2.AREF
BLUE: TEENSY3.2_2.6 (6/PWM); also elsewhere on the board
BT-RX_TEENSY-TX: TEENSY3.2_2.8 (8/TX3); also elsewhere on the board
BT-TX_TEENSY-RX: TEENSY3.2_2.7 (7/RX3); also elsewhere on the board
CLOCK: IC1.11 (SCK), IC2.11 (SCK), TEENSY3.2_2.21/A7 (21/A7/PWM)
CS: TEENSY3.2_2.10 (10/TX2/PWM); also elsewhere on the board
D+: USB.D+, USB_2.3
D-: USB.D-, USB_2.2
DATA-IN: IC1.14 (SER), TEENSY3.2_2.17/A3 (17/A3/T)
DATA-OUT: IC1.9 (QH*), IC2.14 (SER)
DC: TEENSY3.2_2.A10; also elsewhere on the board
DIPSW: TEENSY3.2_2.A13; also elsewhere on the board
DIR: TEENSY3.2_2.22/A8 (22/A8/T/PWM); also elsewhere on the board
GND: C1.1, IC1.8 (GND), IC1.13 (G), IC2.8 (GND), IC2.13 (G), PROGRAM.B2 (2), PWR.2, QUANTUM_CONNECTOR.27, QUANTUM_CONNECTOR.28, SPI.6, TEENSY3.2_2.GND, TEENSY3.2_2.GND1 (GND), TEENSY3.2_2.GND2 (GND), USB.GND, USB_2.4; also elsewhere on the board
GREEN: TEENSY3.2_2.25 (25/T/PWM); also elsewhere on the board
INA1: IC1.15 (QA), QUANTUM_CONNECTOR.2
INA2: IC1.2 (QC), QUANTUM_CONNECTOR.8
INA3: IC1.4 (QE), QUANTUM_CONNECTOR.11
INA4: IC1.6 (QG), QUANTUM_CONNECTOR.5
INB1: IC1.1 (QB), QUANTUM_CONNECTOR.6
INB2: IC1.3 (QD), QUANTUM_CONNECTOR.12
INB3: IC1.5 (QF), QUANTUM_CONNECTOR.7
INB4: IC1.7 (QH), QUANTUM_CONNECTOR.1
LATCH: C1.2, IC1.12 (RCK), IC2.12 (RCK), TEENSY3.2_2.30 (30/A19/SDA1)
LED1: IC2.15 (QA); also elsewhere on the board
LED2: IC2.1 (QB); also elsewhere on the board
LED3: IC2.2 (QC); also elsewhere on the board
LED4: IC2.3 (QD); also elsewhere on the board
LED5: IC2.4 (QE); also elsewhere on the board
LED6: IC2.5 (QF); also elsewhere on the board
LED7: IC2.6 (QG); also elsewhere on the board
LED8: IC2.7 (QH); also elsewhere on the board
LINEA1: QUANTUM_CONNECTOR.15, TEENSY3.2_2.2
LINEA2: QUANTUM_CONNECTOR.17, TEENSY3.2_2.3 (3/CAN-TX/PWM)
LINEA3: QUANTUM_CONNECTOR.19, TEENSY3.2_2.31 (31/A20)
LINEA4: QUANTUM_CONNECTOR.21, TEENSY3.2_2.24
LINEA5: QUANTUM_CONNECTOR.23, TEENSY3.2_2.27 (27/A16)
LINEA6: QUANTUM_CONNECTOR.16, TEENSY3.2_2.26 (26/A15)
LINEA7: QUANTUM_CONNECTOR.18, TEENSY3.2_2.14/A0
LINEA8: QUANTUM_CONNECTOR.20, TEENSY3.2_2.15/A1 (15/A1/T)
LINEA9: QUANTUM_CONNECTOR.22, TEENSY3.2_2.16/A2 (16/A2/T)
LINEAANT: QUANTUM_CONNECTOR.24, TEENSY3.2_2.33 (33/T)
MISO: SPI.1, TEENSY3.2_2.12 (12/MISO)
MOSI: SPI.4, TEENSY3.2_2.11 (11/MOSI); also elsewhere on the board
PALLA: QUANTUM_CONNECTOR.13, TEENSY3.2_2.28 (28/A17)
PROGRAM: PROGRAM.A2 (1), USB_2.5
PULS: TEENSY3.2_2.23/A9 (23/A9/T/PWM); also elsewhere on the board
PWM1: QUANTUM_CONNECTOR.4, TEENSY3.2_2.5 (5/PWM)
PWM2: QUANTUM_CONNECTOR.10, TEENSY3.2_2.9 (9/RX2/PWM)
PWM3: QUANTUM_CONNECTOR.9, TEENSY3.2_2.32 (32/T/PWM)
PWM4: QUANTUM_CONNECTOR.3, TEENSY3.2_2.4 (4/CAN-RX-PWM)
RED: TEENSY3.2_2.20/A6 (20/A6/PWM); also elsewhere on the board
RESET: SPI.5
SCK: SPI.3, TEENSY3.2_2.13 (13/SCK/LED); also elsewhere on the board
SCL: TEENSY3.2_2.19/A5 (19/A5/T/SCL0); also elsewhere on the board
SDA: TEENSY3.2_2.18/A4 (18/A4/T/SDA0); also elsewhere on the board
SEL: TEENSY3.2_2.A11; also elsewhere on the board
SOLENOIDE: QUANTUM_CONNECTOR.14, TEENSY3.2_2.29 (29/A18/SCL1)
SPEED: TEENSY3.2_2.A12; also elsewhere on the board
TEENSY1-RX_TEENSY2-TX: QUANTUM_CONNECTOR.29, TEENSY3.2_2.1 (1/TX1/T)
TEENSY1-TX_TEENSY2-RX: QUANTUM_CONNECTOR.30, TEENSY3.2_2.0 (0/RX1/T)
TONE: TEENSY3.2_2.RESET/DAC (A14/DAC); also elsewhere on the board
VBATTEENSY: TEENSY3.2_2.VBAT
VIN: TEENSY3.2_2.VIN
VUSB: USB.VBUS, USB_2.1

Notes on the sheet:
PHOENIX
display e pixy
bussola
com
ATTENZIONE!!!!!! SCAMBIATO IL 21 con IL 28
--->>
<<<--------- ATTENZIONE
CLOCK
PALLA

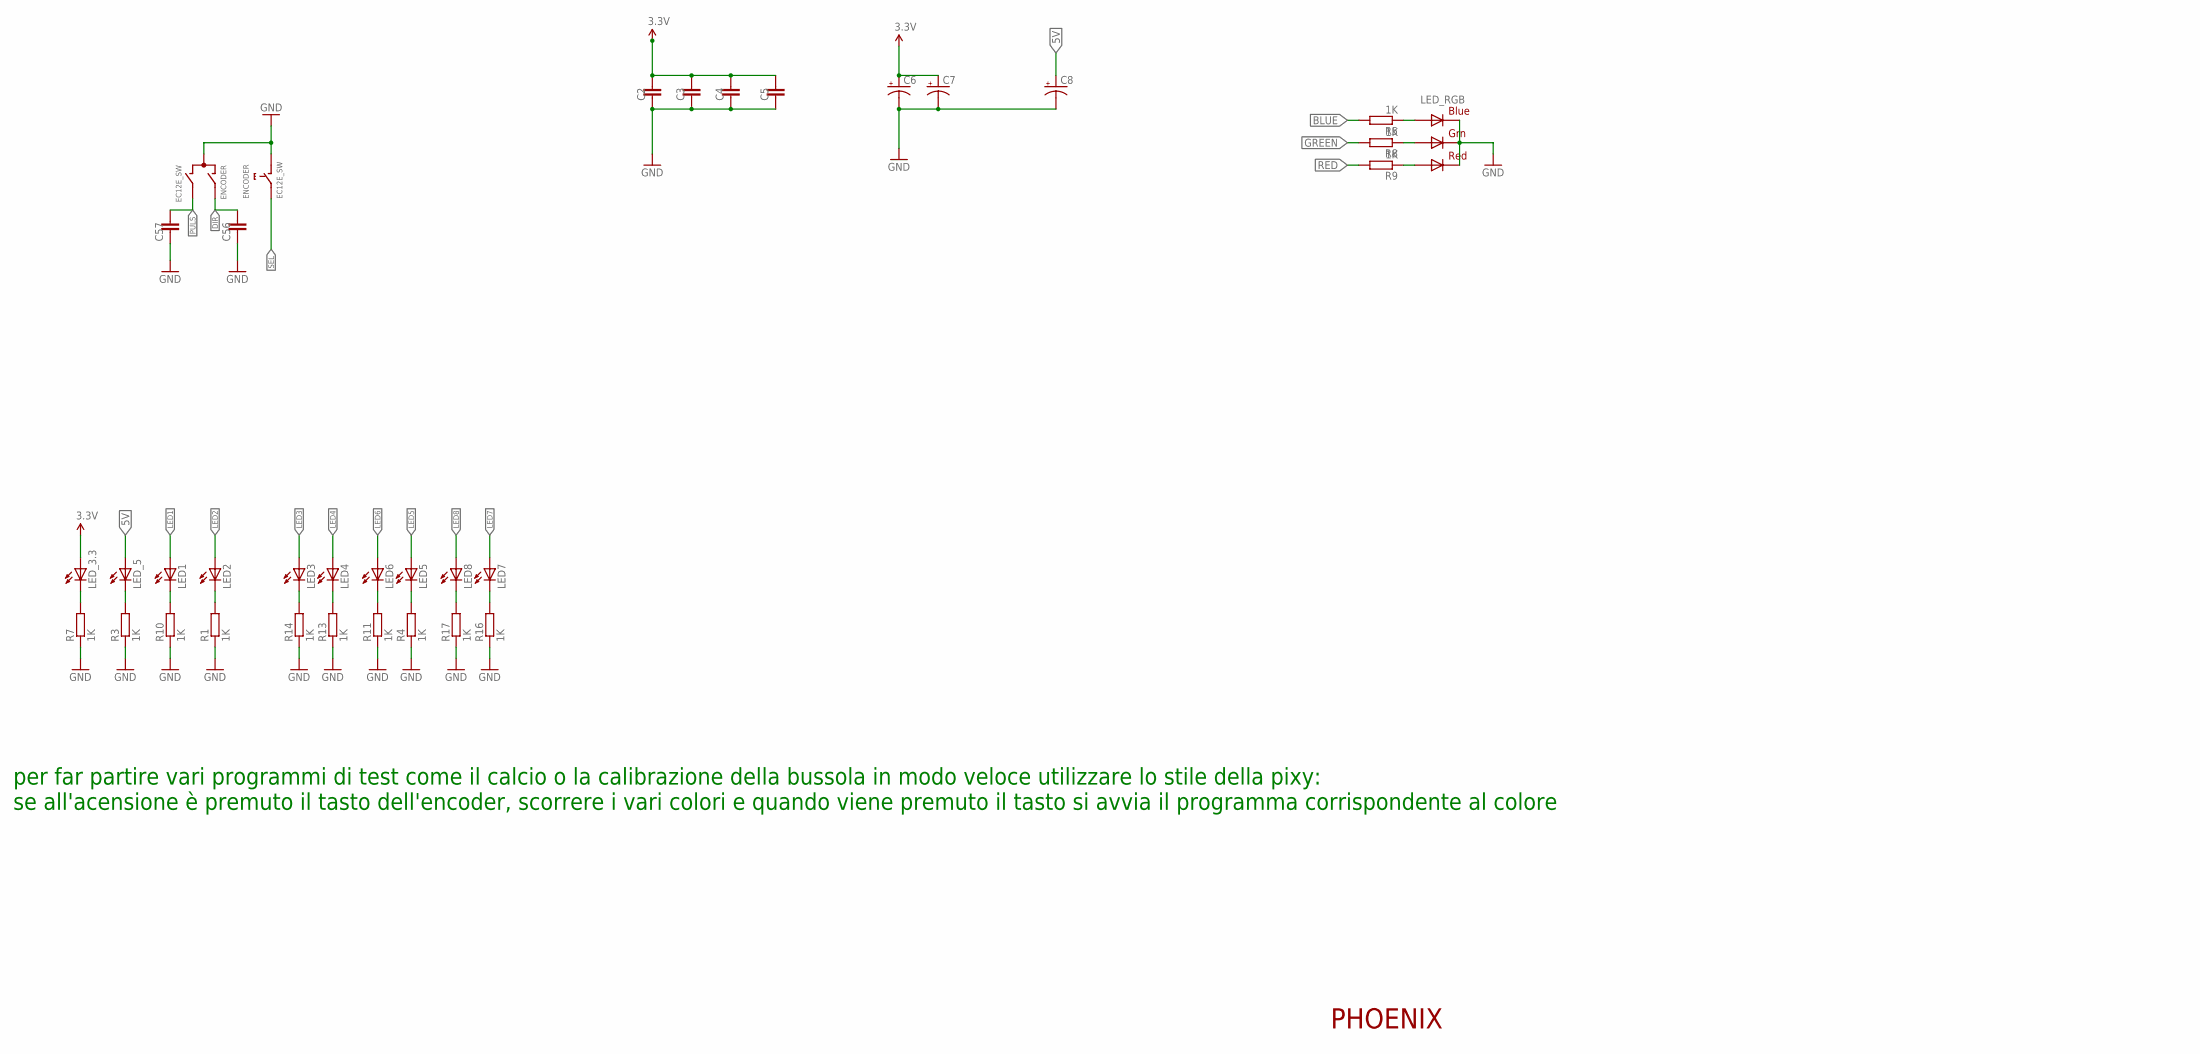
[picture p36: schematic Calciatore Rev.2 UP.sch, sheet 2]

Parts:
C2, C3, C4, C5, C56, C57: C-EUC1206; C1206
C6, C7, C8: CPOL-USE3.5-8; E3,5-8
ENCODER: EC12E_SW; ALPS_EC12E_SW
LED1, LED2, LED3, LED4, LED5, LED6, LED7, LED8: LEDSMT1206; 1206
LED_3.3, LED_5: LEDSMT1206; 1206
LED_RGB: RGBLED5050
R1, R3, R4, R5, R7, R8, R9, R10, R11, R13, R14, R16, R17: 1K; M1206

Connections:
3.3V: C2.2, C3.2, C4.2, C5.2, C6.+, C7.+, LED_3.3.A; also elsewhere on the board
5V: C8.+, LED_5.A; also elsewhere on the board
BLUE: R5.2; also elsewhere on the board
DIR: C56.2, ENCODER.A; also elsewhere on the board
GND: C2.1, C3.1, C4.1, C5.1, C6.-, C7.-, C8.-, C56.1, C57.1, ENCODER.C, ENCODER.D (1), LED_RGB.4 (BLUE_C), LED_RGB.5 (RED_C), LED_RGB.6 (GREEN_C), R1.1, R3.1, R4.1, R7.1, R10.1, R11.1, R13.1, R14.1, R16.1, R17.1; also elsewhere on the board
GREEN: R8.2; also elsewhere on the board
LED1: LED1.A; also elsewhere on the board
LED2: LED2.A; also elsewhere on the board
LED3: LED3.A; also elsewhere on the board
LED4: LED4.A; also elsewhere on the board
LED5: LED5.A; also elsewhere on the board
LED6: LED6.A; also elsewhere on the board
LED7: LED7.A; also elsewhere on the board
LED8: LED8.A; also elsewhere on the board
LED_3.3: LED_3.3.C, R7.2
unnamed: LED2.C, R1.2
unnamed: LED_5.C, R3.2
unnamed: LED5.C, R4.2
unnamed: LED6.C, R11.2
unnamed: LED7.C, R16.2
unnamed: LED_RGB.3 (BLUE_A), R5.1
unnamed: LED_RGB.1 (GREEN_A), R8.1
unnamed: LED_RGB.2 (RED_A), R9.1
unnamed: LED1.C, R10.2
unnamed: LED4.C, R13.2
unnamed: LED3.C, R14.2
unnamed: LED8.C, R17.2
PULS: C57.2, ENCODER.B; also elsewhere on the board
RED: R9.2; also elsewhere on the board
SEL: ENCODER.E (2); also elsewhere on the board

Notes on the sheet:
PHOENIX
per far partire vari programmi di test come il calcio o la calibrazione della bussola in modo veloce utilizzare lo stile della pixy: se all'acensione è premuto il tasto dell'encoder, scorrere i vari colori e quando viene premuto il tasto si avvia il programma corrispondente al colore

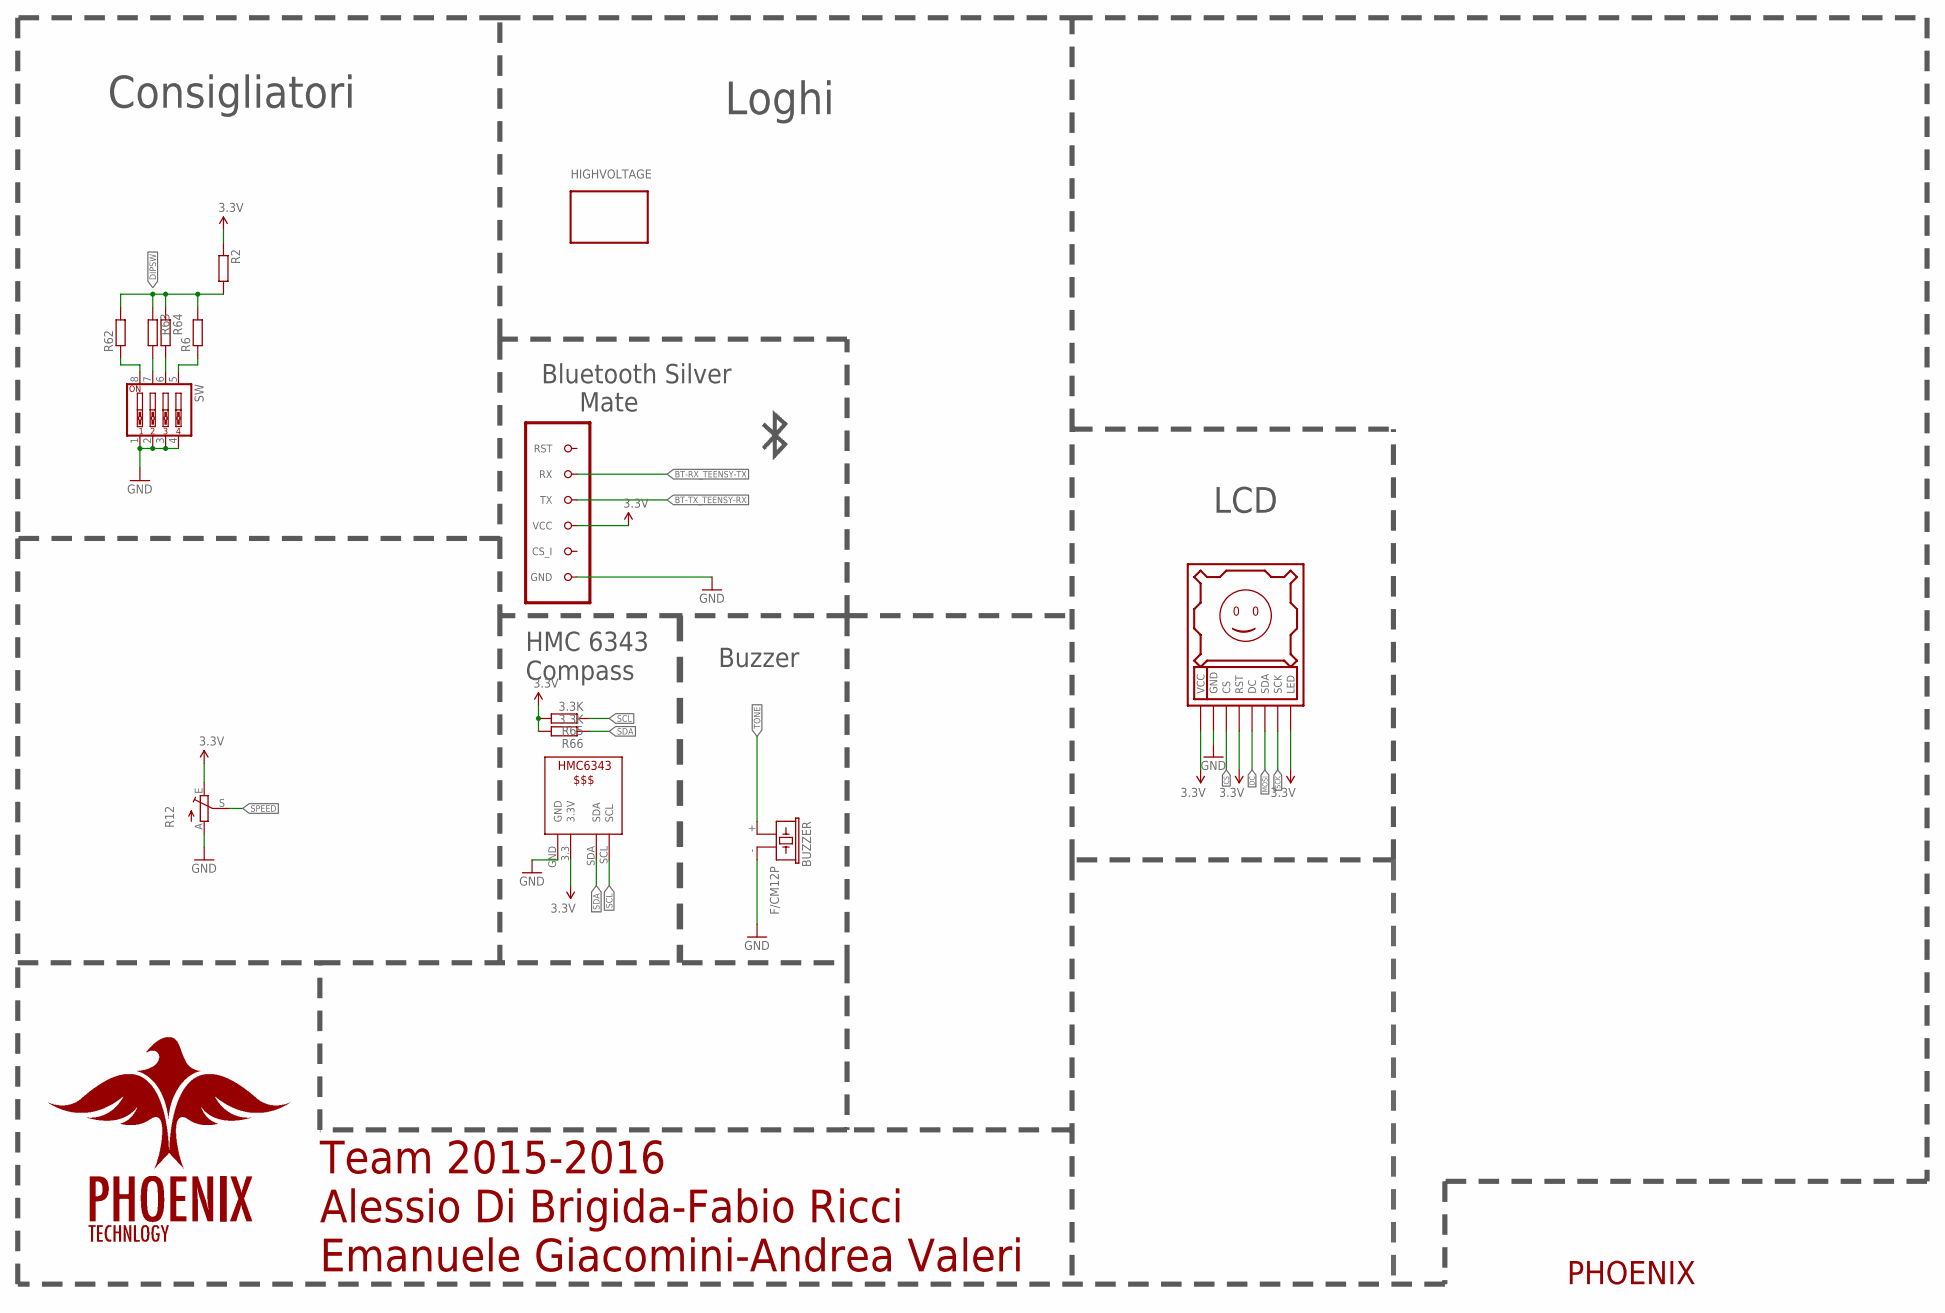
[picture p37: schematic Calciatore Rev.2 UP.sch, sheet 3]

Parts:
BUZZER: F/CM12P
DISPLAY1: DISPLAY128X128
HIGHVOLTAGE: LOGO; LOGOHV
R2, R6, R62, R63, R64: 10K; M1206
R12: TRIM_EU-S63P; S63P
R65, R66: 3.3K; M1206
SW: SW_DIP-4; EDG-04
U$5: HMC6343
U$9: BLUETOOTH

Connections:
3.3V: DISPLAY1.LED, DISPLAY1.RST, DISPLAY1.VCC, R2.1, R12.E, R65.2, R66.2, U$5.3.3 (3.3V), U$9.VCC; also elsewhere on the board
BT-RX_TEENSY-TX: U$9.RX; also elsewhere on the board
BT-TX_TEENSY-RX: U$9.TX; also elsewhere on the board
CS: DISPLAY1.CS; also elsewhere on the board
DC: DISPLAY1.DC; also elsewhere on the board
DIPSW: R2.2, R6.2, R62.2, R63.1, R64.1; also elsewhere on the board
GND: BUZZER.- (2), DISPLAY1.GND, R12.A, SW.1, SW.2, SW.3, SW.4, U$5.GND, U$9.GND; also elsewhere on the board
MOSI: DISPLAY1.SDA; also elsewhere on the board
unnamed: R64.2, SW.6
unnamed: R62.1, SW.8
unnamed: R6.1, SW.5
unnamed: R63.2, SW.7
SCK: DISPLAY1.SCK; also elsewhere on the board
SCL: R65.1, U$5.SCL; also elsewhere on the board
SDA: R66.1, U$5.SDA; also elsewhere on the board
SPEED: R12.S; also elsewhere on the board
TONE: BUZZER.+ (1); also elsewhere on the board

Notes on the sheet:
LCD
Buzzer
Bluetooth Silver Mate
HMC 6343 Compass
Consigliatori
Loghi
Team 2015-2016 Alessio Di Brigida-Fabio Ricci Emanuele Giacomini-Andrea Valeri
PHOENIX

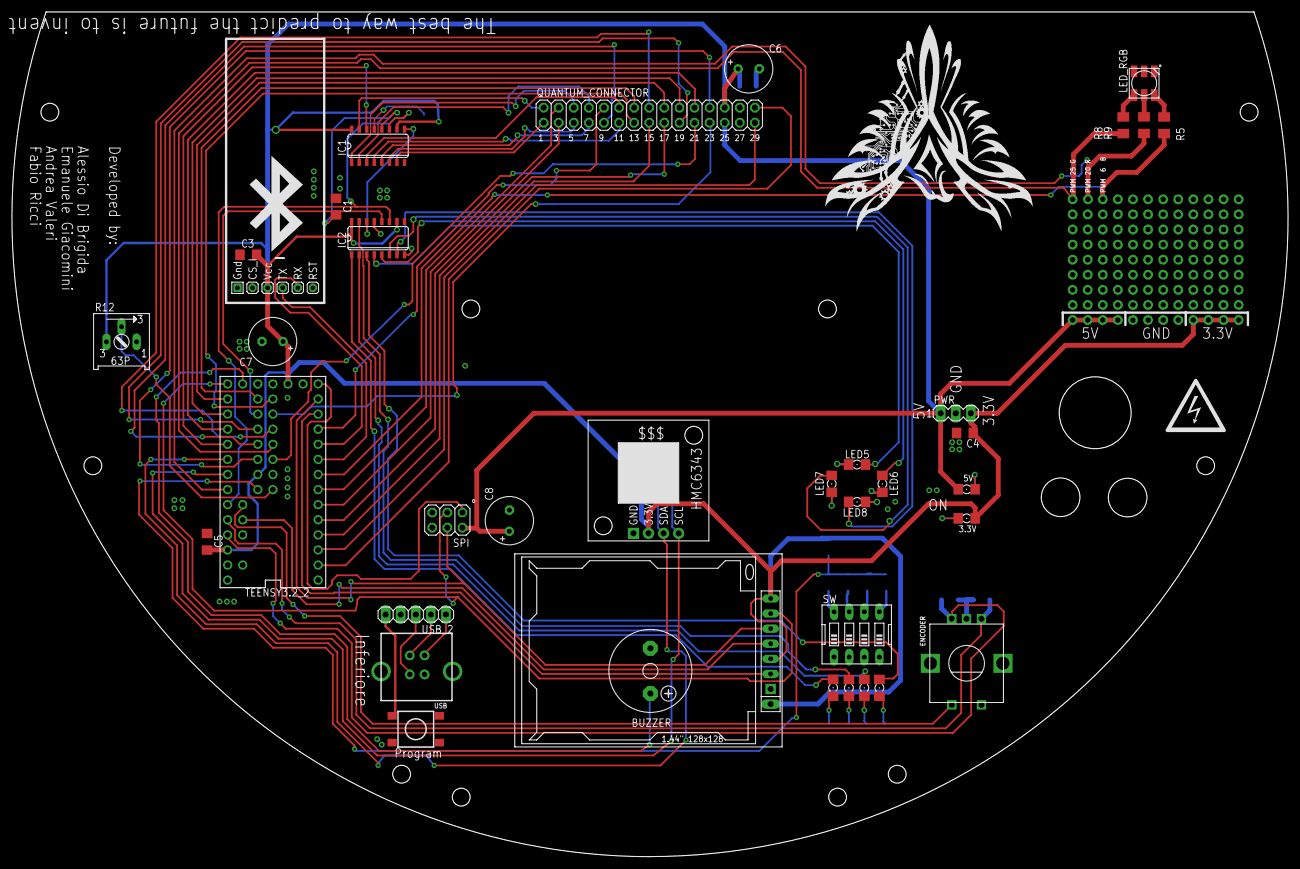
[picture p38: board Calciatore Rev.2 UP.brd from above]

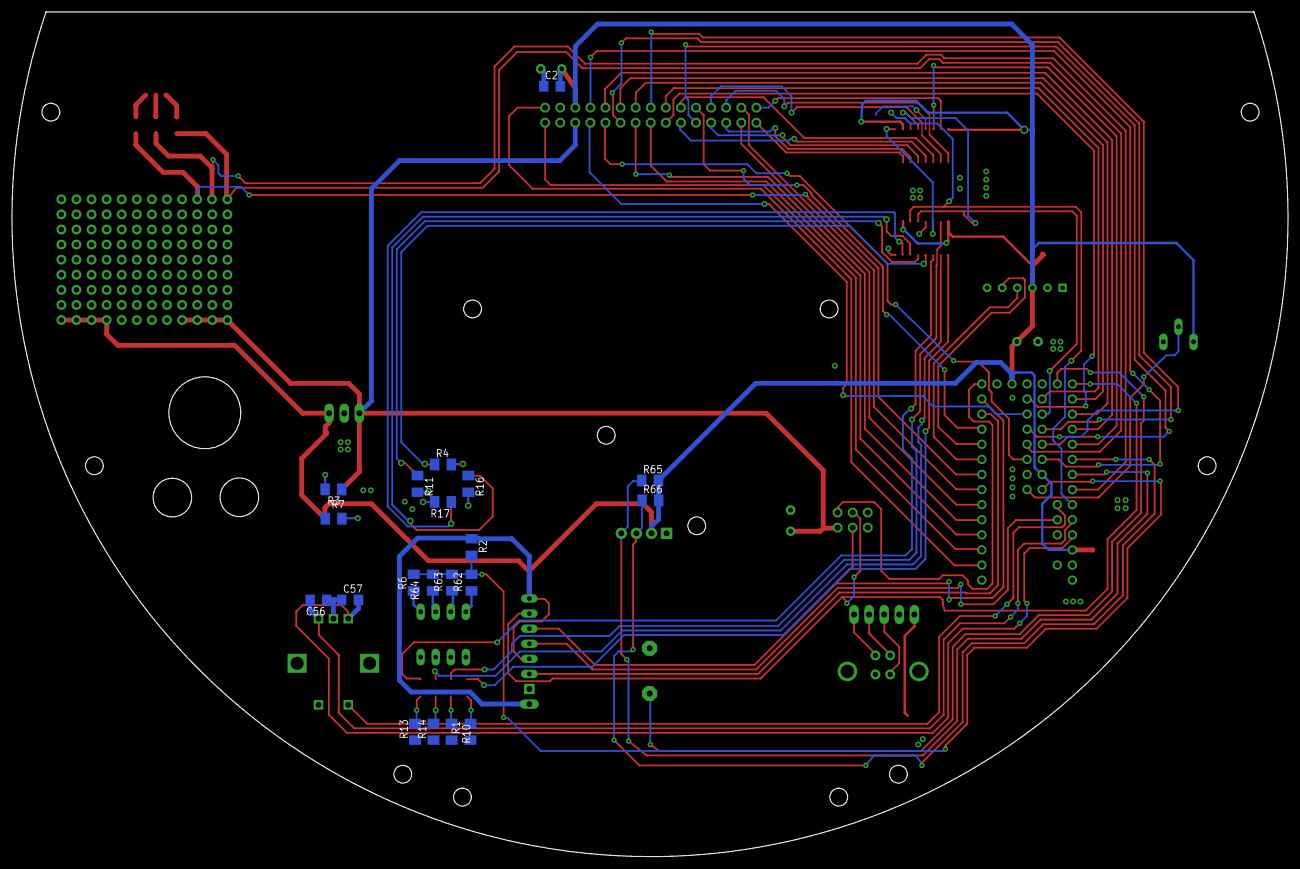
[picture p39: board Calciatore Rev.2 UP.brd from below]

Board: 2 copper layers, 214.8 x 142.2 mm, 59 parts (20 on the bottom side), 80 nets.

Other parts of the board:
U$1: PHOENIX
