Er-Chiacchiera/Soccer-2018-19/Elettronica/Sensori_linea/sensore-linea.brd

## EAGLE design Elettronica/Sensori_linea/sensore-linea.brd (2019-03-06)

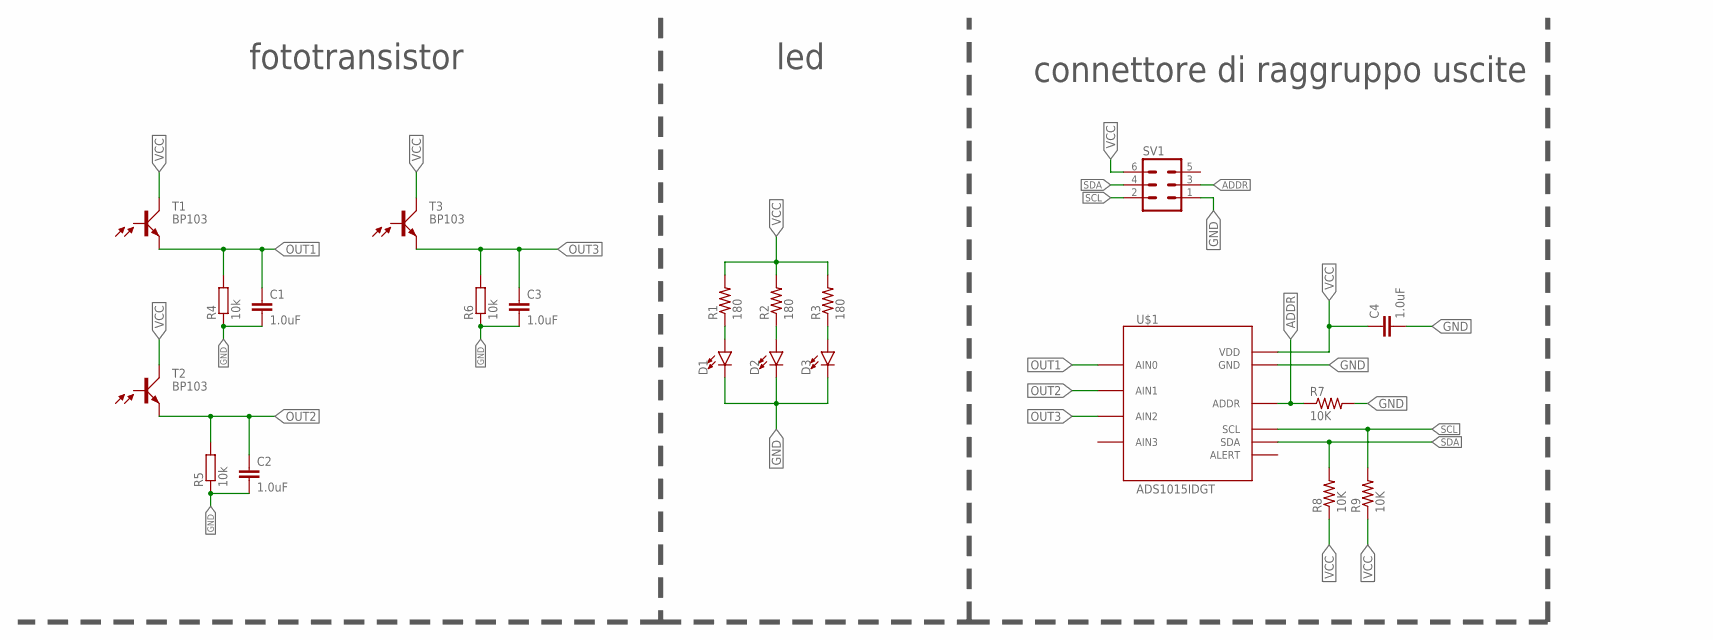
[picture p40: schematic sensore-linea.sch]

Parts:
C1, C2, C3: 1.0uF; 1206
C4: 1.0uF; 0402
D1, D2, D3: LED3MM; LED_3MM
R1, R2, R3: 180; 0204/7
R4, R5, R6: 10k; R1206
R7, R8, R9: 10K; 0204/7
SV1: MA03-2
T1, T2, T3: BP103
U$1: ADS1015IDGT; MSOP10_0.5

Connections:
ADDR: R7.1, SV1.3, U$1.1 (ADDR)
GND: C1.2, C2.2, C3.2, C4.2, D1.K (C), D2.K (C), D3.K (C), R4.1, R5.1, R6.1, R7.2, SV1.1, U$1.3 (GND)
unnamed: D1.A, R1.1
unnamed: D2.A, R2.1
unnamed: D3.A, R3.1
OUT1: C1.1, R4.2, T1.E, U$1.4 (AIN0)
OUT2: C2.1, R5.2, T2.E, U$1.5 (AIN1)
OUT3: C3.1, R6.2, T3.E, U$1.6 (AIN2)
SCL: R9.2, SV1.2, U$1.10 (SCL)
SDA: R8.2, SV1.4, U$1.9 (SDA)
VCC: C4.1, R1.2, R2.2, R3.2, R8.1, R9.1, SV1.6, T1.C, T2.C, T3.C, U$1.8 (VDD)

Notes on the sheet:
fototransistor
led
connettore di raggruppo uscite

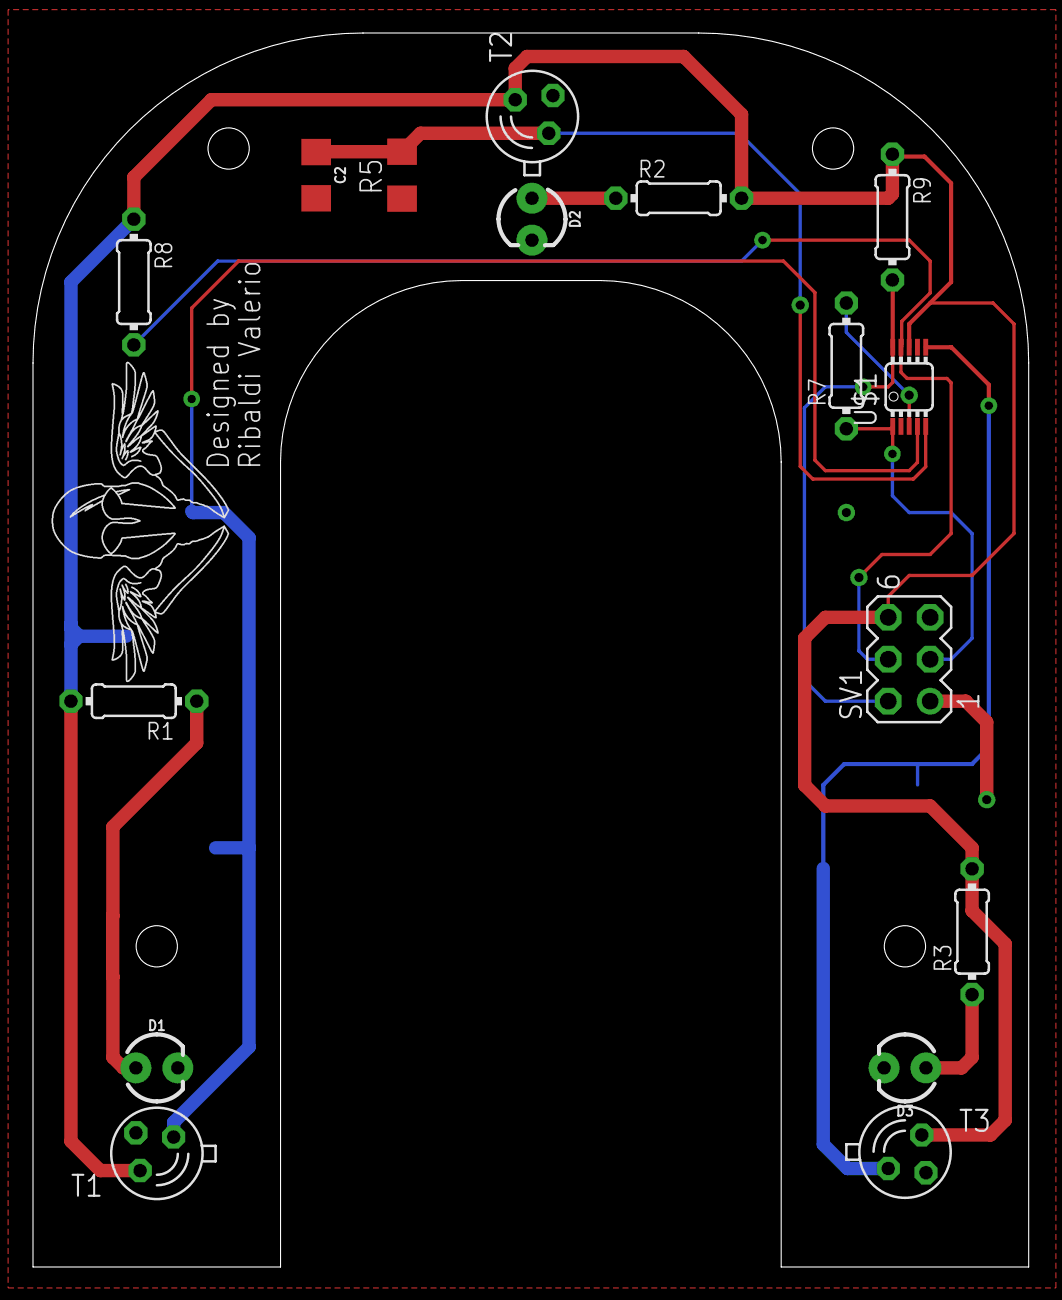
[picture p41: board Elettronica/Sensori_linea/sensore-linea.brd from above]

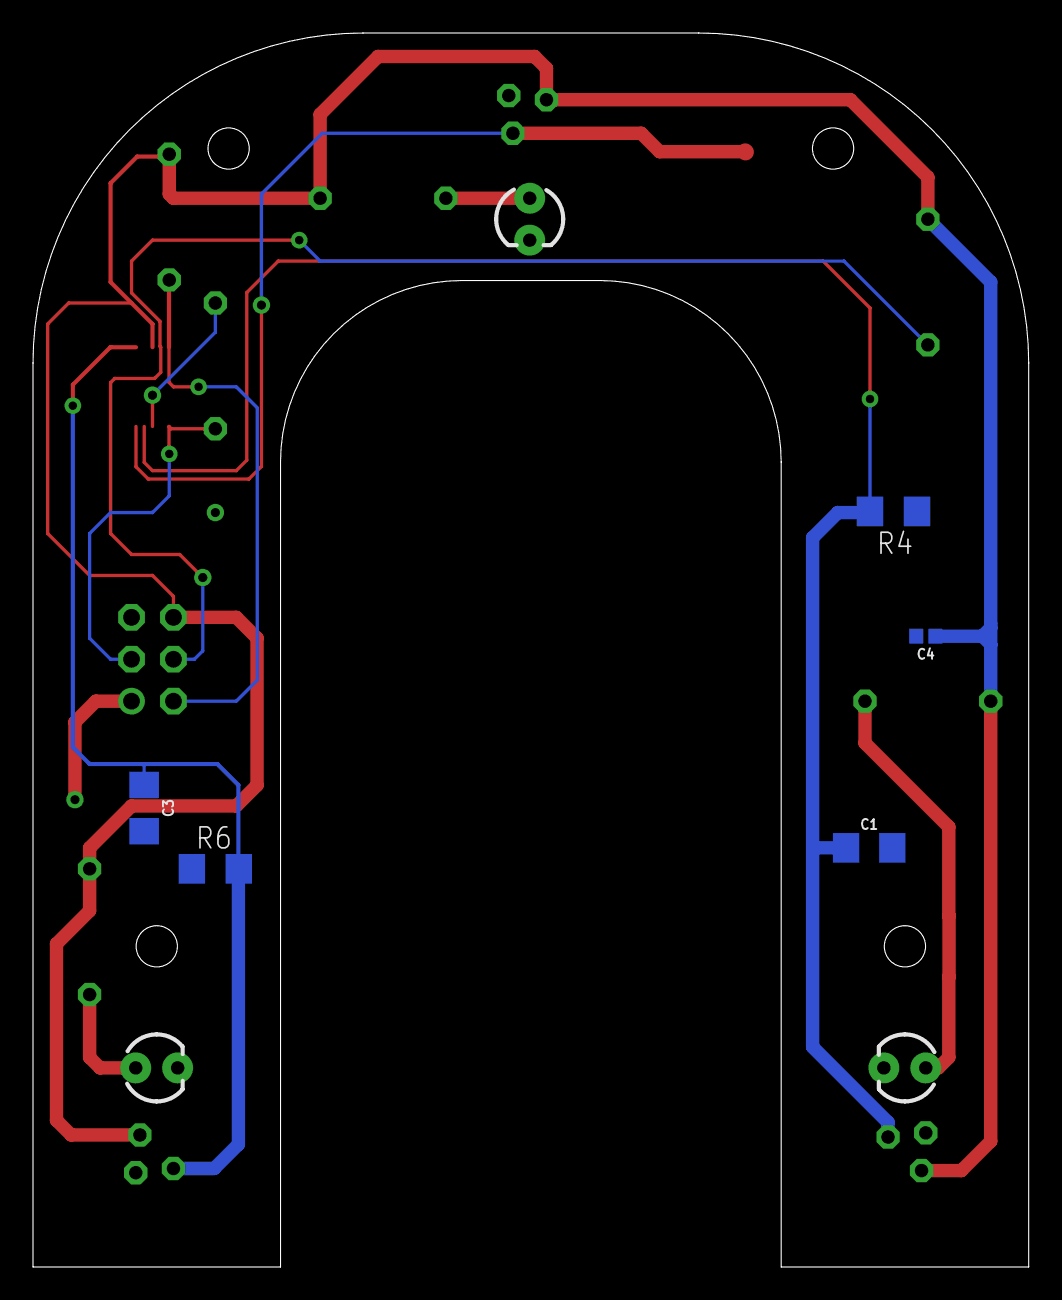
[picture p42: board Elettronica/Sensori_linea/sensore-linea.brd from below]

Board: 2 copper layers, 60.3 x 74.8 mm, 21 parts (5 on the bottom side), 11 nets.
