Er-Chiacchiera/Soccer-2018-19/Elettronica/Sensori_linea/sensore-linea-multipli.brd

## EAGLE design Elettronica/Sensori_linea/sensore-linea-multipli.brd (2019-03-06)

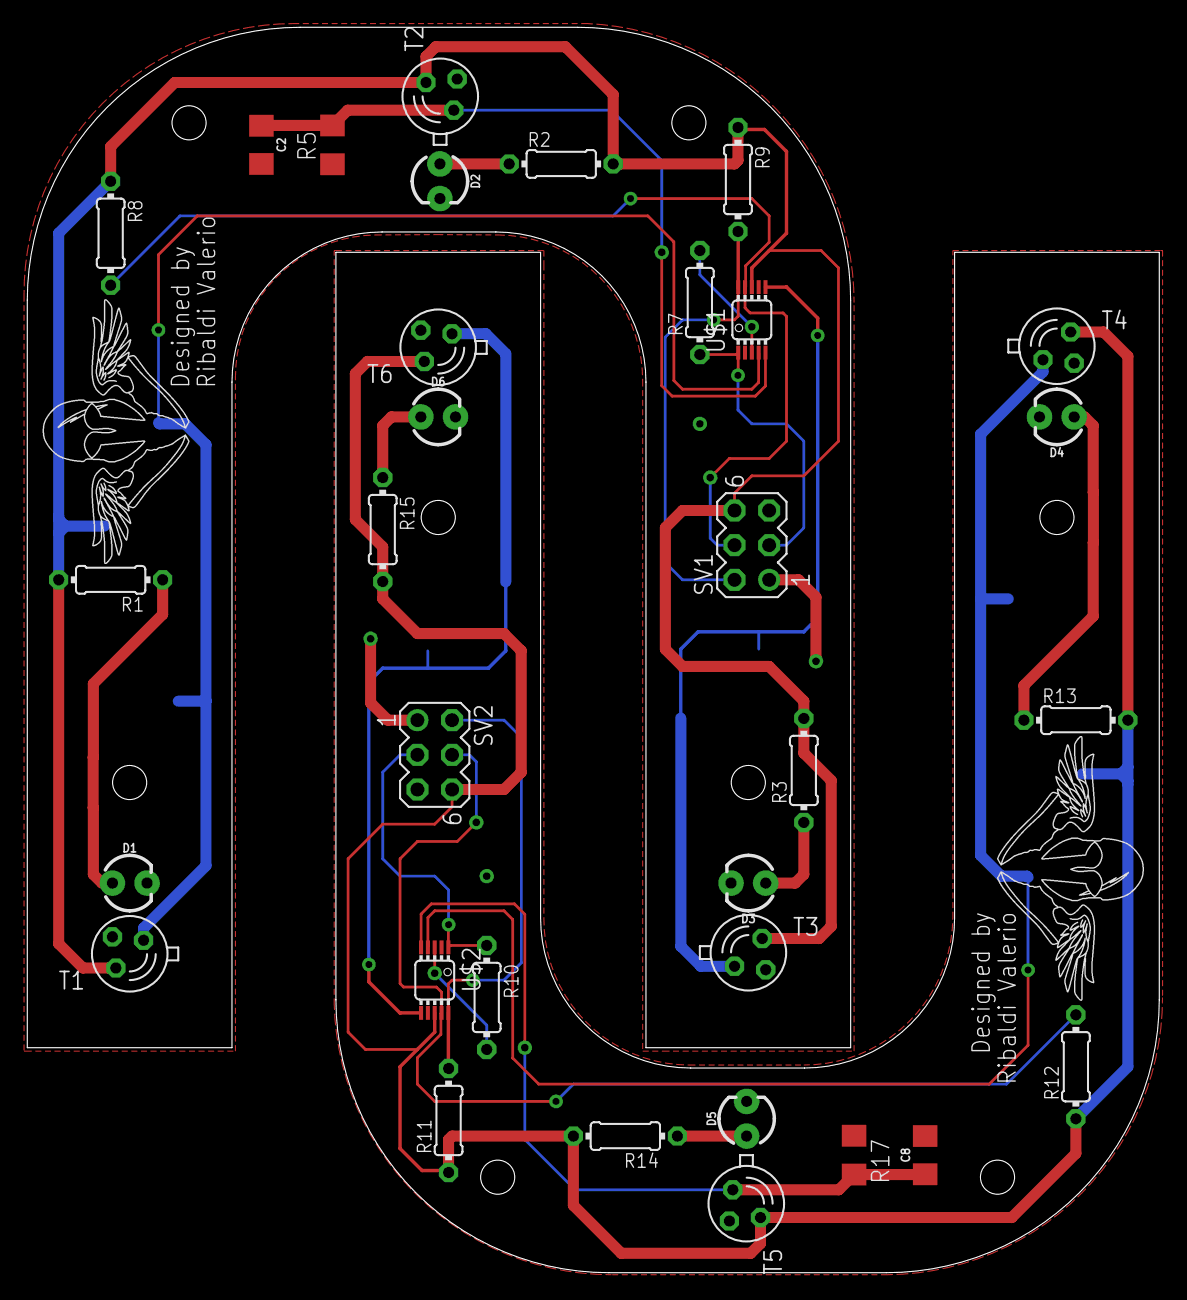
[picture p43: board sensore-linea-multipli.brd from above]

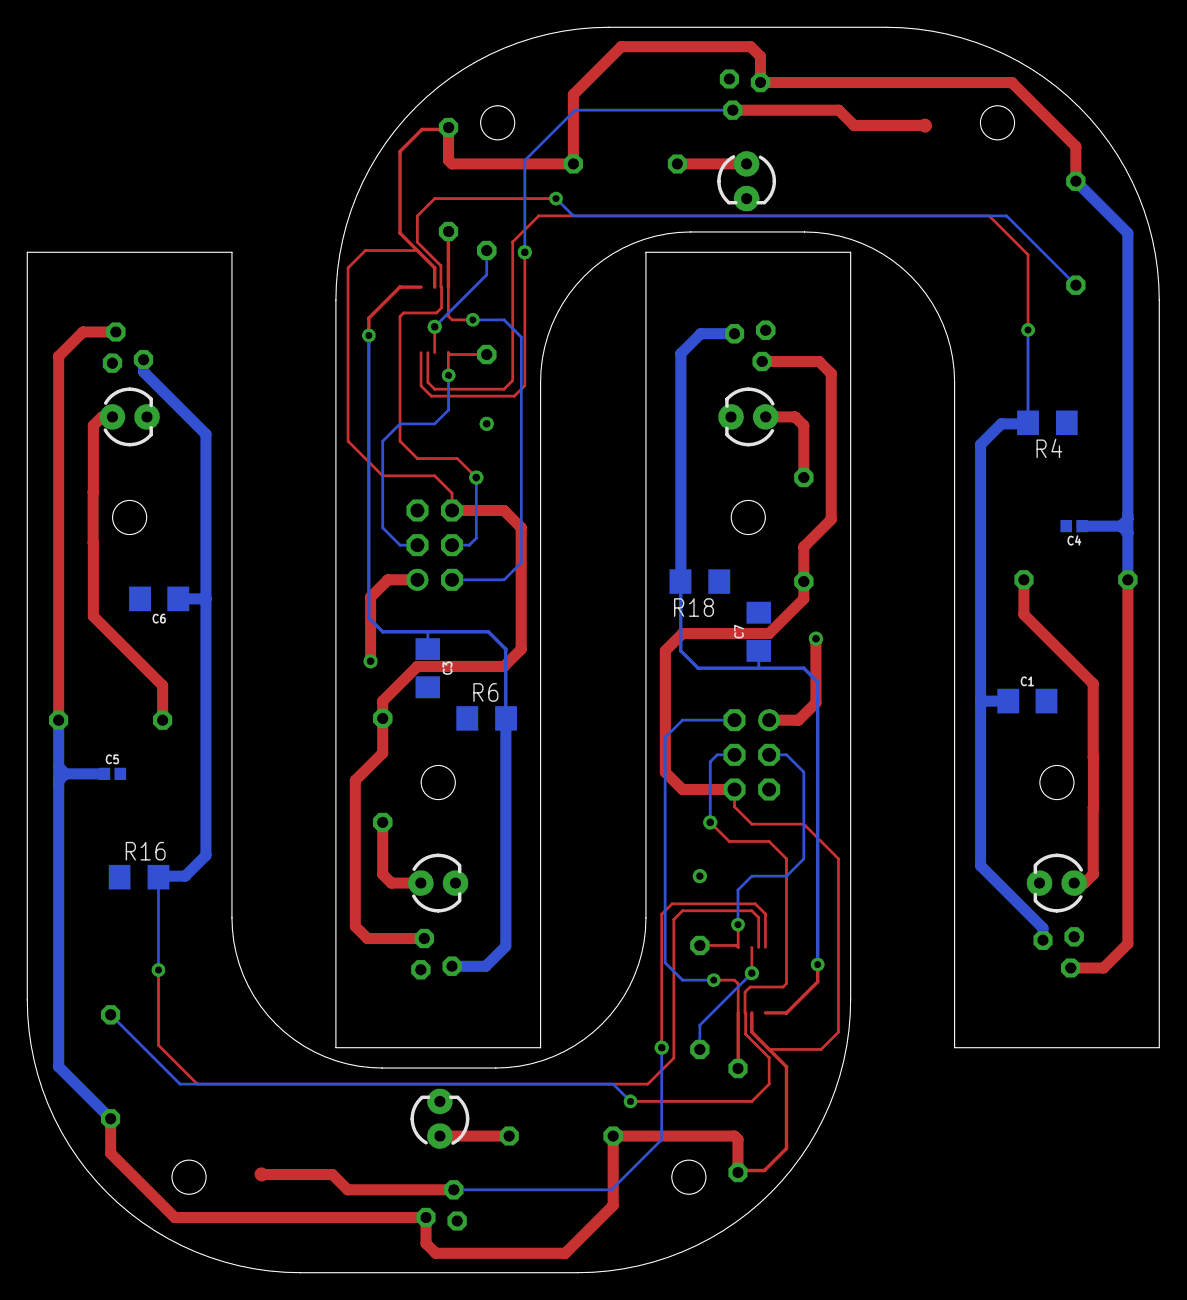
[picture p44: board sensore-linea-multipli.brd from below]

Board: 2 copper layers, 83.0 x 91.3 mm, 42 parts (10 on the bottom side), 22 nets.

Parts:
C1, C2, C3, C6, C7, C8: 1.0uF; 1206
C4, C5: 1.0uF; 0402
D1, D2, D3, D4, D5, D6: LED_3MM
R1, R2, R3, R13, R14, R15: 180; 0204/7
R4, R5, R6, R16, R17, R18: 10k; R1206
R7, R8, R9, R10, R11, R12: 10K; 0204/7
SV1, SV2: MA03-2
T1, T2, T3, T4, T5, T6: BP103
U$1, U$2: ADS1015IDGT; MSOP10_0.5

Connections:
ADDR: R7.1, SV1.3, U$1.1
ADDR1: R10.1, SV2.3, U$2.1
GND: C1.2, C2.2, C3.2, C4.2, D1.K, D2.K, D3.K, R4.1, R5.1, R6.1, R7.2, SV1.1, U$1.3
GND1: C5.2, C6.2, C7.2, C8.2, D4.K, D5.K, D6.K, R10.2, R16.1, R17.1, R18.1, SV2.1, U$2.3
unnamed: D4.A, R13.1
unnamed: D1.A, R1.1
unnamed: D2.A, R2.1
unnamed: D3.A, R3.1
unnamed: D5.A, R14.1
unnamed: D6.A, R15.1
OUT1: C1.1, R4.2, T1.E, U$1.4
OUT2: C2.1, R5.2, T2.E, U$1.5
OUT3: C3.1, R6.2, T3.E, U$1.6
OUT4: C6.1, R16.2, T4.E, U$2.4
OUT5: C8.1, R17.2, T5.E, U$2.5
OUT6: C7.1, R18.2, T6.E, U$2.6
SCL: R9.2, SV1.2, U$1.10
SCL1: R11.2, SV2.2, U$2.10
SDA: R8.2, SV1.4, U$1.9
SDA1: R12.2, SV2.4, U$2.9
VCC: C4.1, R1.2, R2.2, R3.2, R8.1, R9.1, SV1.6, T1.C, T2.C, T3.C, U$1.8
VCC1: C5.1, R11.1, R12.1, R13.2, R14.2, R15.2, SV2.6, T4.C, T5.C, T6.C, U$2.8
