Er-Chiacchiera/Soccer-2018-19/src/firmware/firmware_cazzutissimo/ares_globals.h

/**
 * phoenix_globals.h
 **/

#pragma once

#include <Arduino.h>
#include "ares_joints.h"
#include "ares_drive.h"
#include "ares_line.h"
#include "ares_line_internal.h"
#include "bno055.h"
#include "ares_imu.h"
#include "ares_rullo.h"
#include "ares_pixy.h"
#include "Adafruit_ADS1015.h"

extern PhoenixJoint joints[NUM_JOINTS];
extern PhoenixDrive drive;
extern PhoenixLineSensor line_sensors[];
extern PhoenixLineHandler line_handler;
extern BNO055 dev_bno055;
extern PhoenixImu imu;
extern Adafruit_ADS1015 line_adc;
extern PhoenixCamera _pixy;
