Er-Chiacchiera/Soccer-2018-19/(commit log)

2019-03-06 modifiche a bussola maniglie e pixy
    [bussola.3dm]
2019-03-07 Prova per connessioni motori
2019-03-08 motori + imu
2019-03-10 file per encoder
2019-03-11 piccoli aggiustamenti
    [Base_Sopra.dxf, Base_Sotto.dxf]
2019-03-12 src con encoder
2019-03-12 src, aggiunti test di simulazione
2019-03-14 Aggiunta I2C scanner
2019-04-15 aggiunta libreria di Gestione
2019-04-30 modifiche di cartelle ecc.
2019-06-30 PCB schematico
    [PCB.sch]
2019-06-30 Sens linea schematico
    [sensore-linea.sch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]
2020-01-30 Elettronica modifiche
    [PCB.brd]
